identitymonk/Fathom-Drone-Archive/Packaging Instructions/Assets/postcard.png

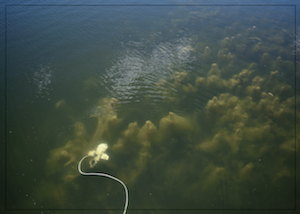
Packaging Instructions/Assets/postcard.png
