identitymonk/Fathom-Drone-Archive/Website/April 2018/Assets/UserManual.png

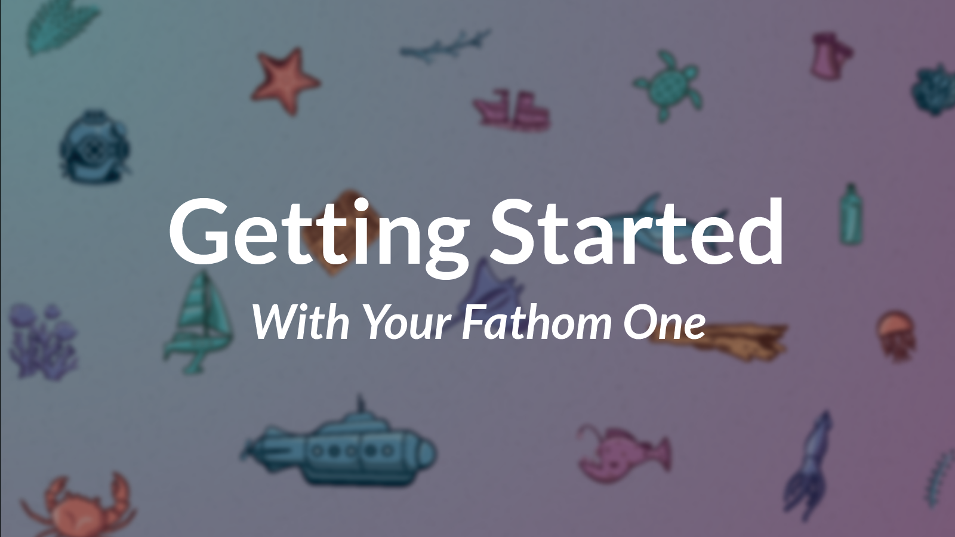
Website/April 2018/Assets/UserManual.png
