identitymonk/Fathom-Drone-Archive/README.md

# Fathom-Drone-Archive
Archive of the dead Fathom Drone Project (https://www.kickstarter.com/projects/1359605477/fathom-one-the-affordable-modular-hd-underwater-dr)
