identitymonk/Fathom-Drone-Archive/Charger/LiPo Charging Table.pdf

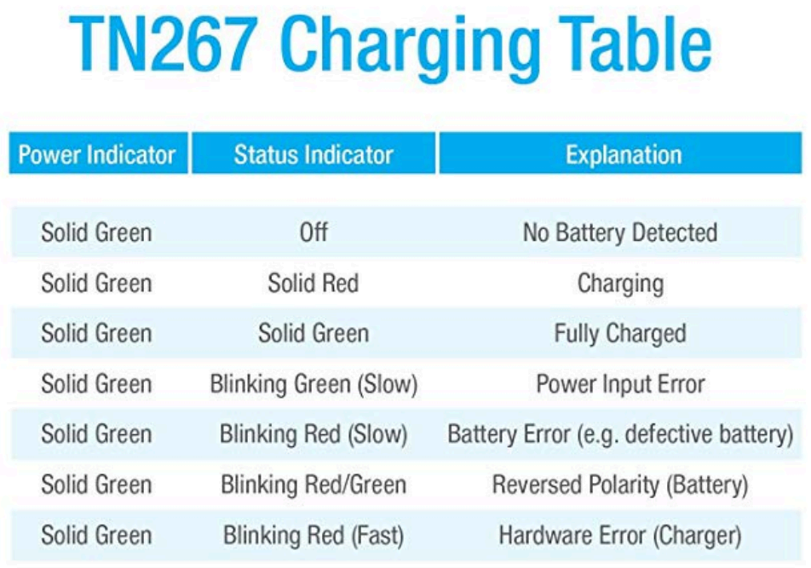
[picture p3: figure]
