identitymonk/Fathom-Drone-Archive/FaceMask/9013-0969.pdf

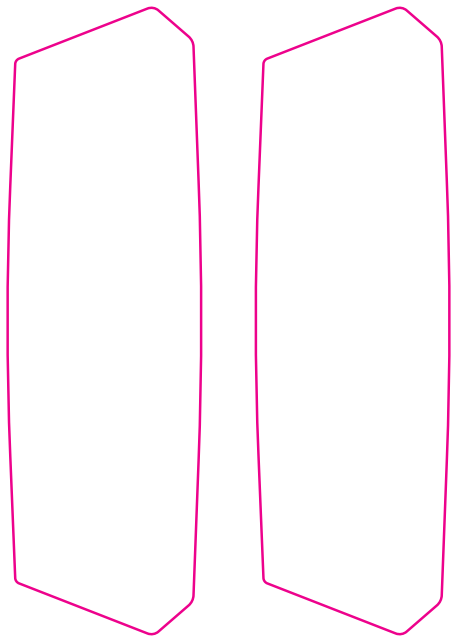
[picture p4: figure]
