identitymonk/Fathom-Drone-Archive/FaceMask/DOC072718-07272018104101.pdf

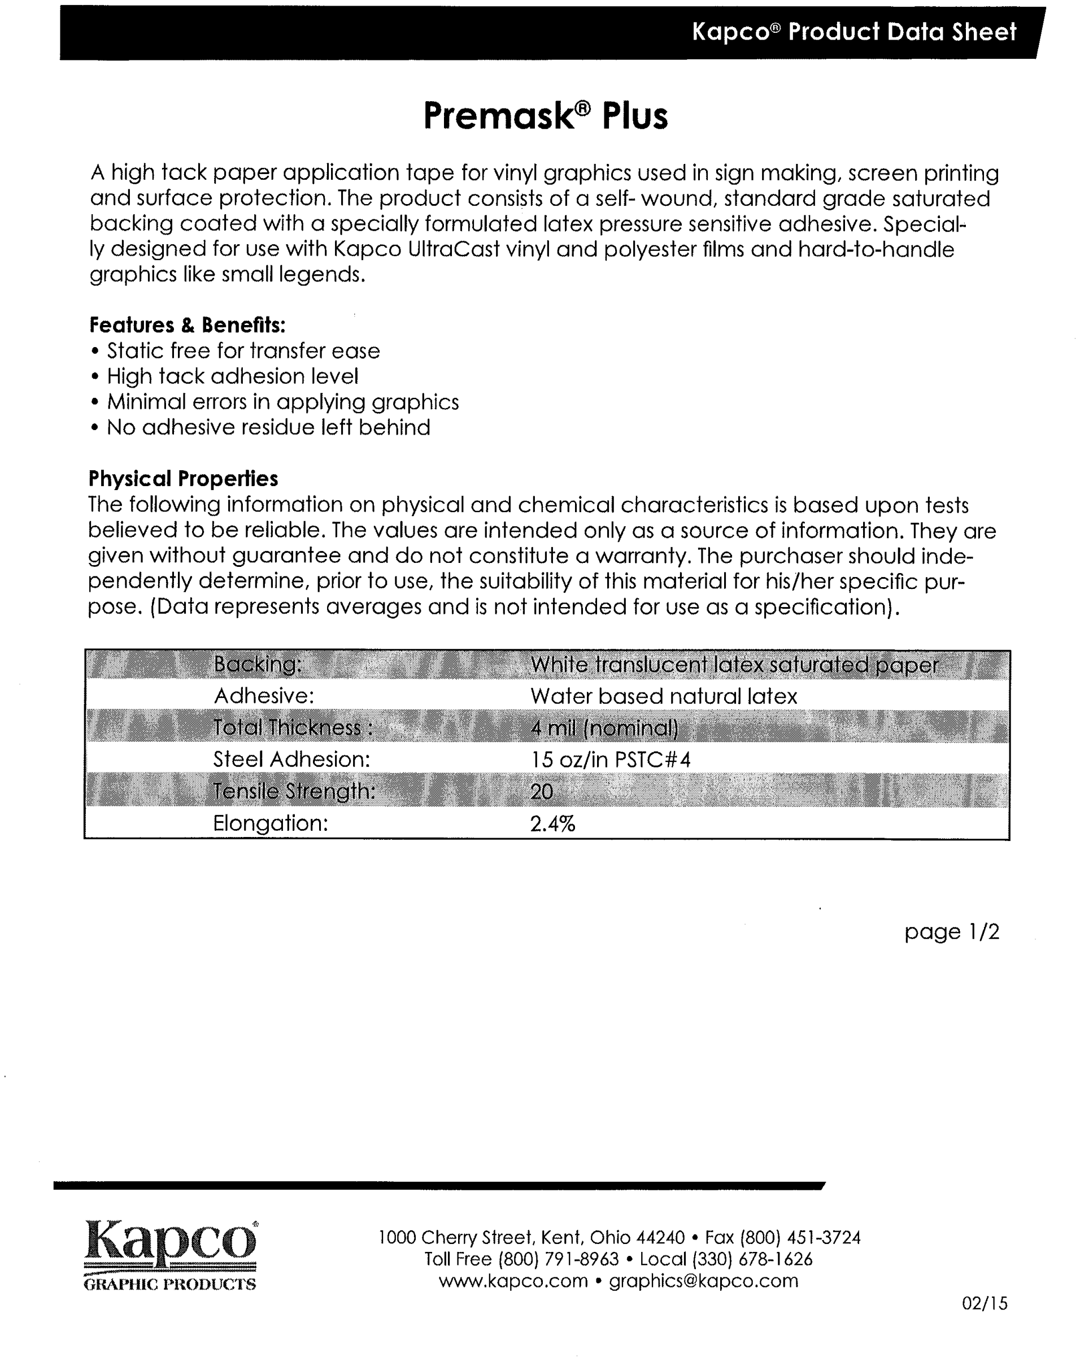
[picture p5: page 1]
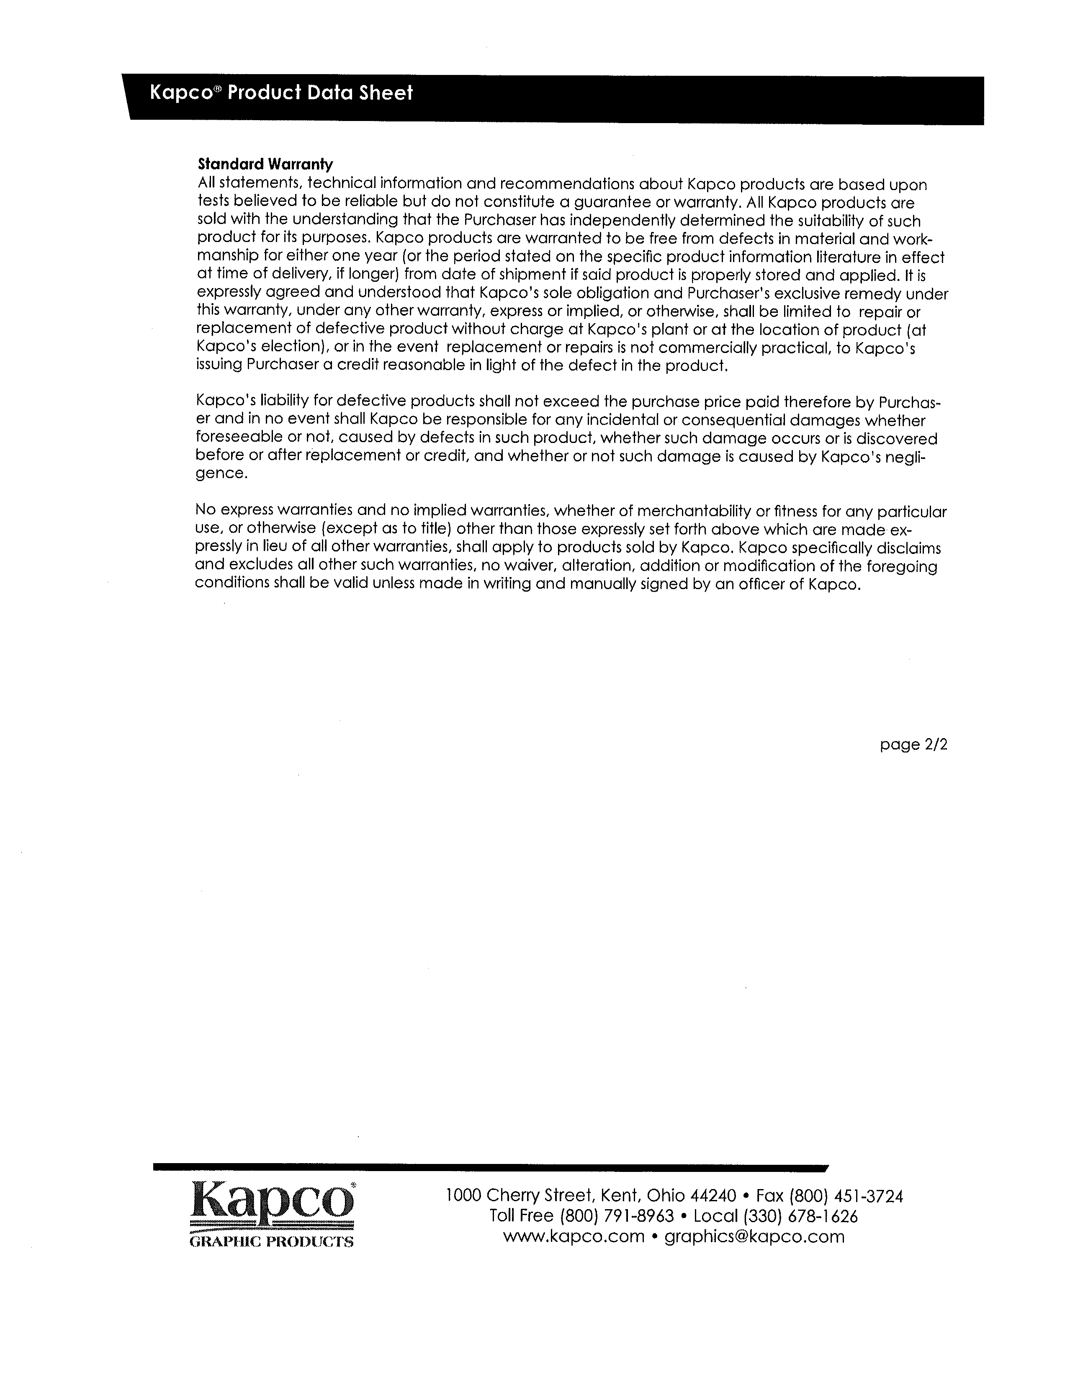
[picture p6: page 2]
