identitymonk/Fathom-Drone-Archive/FaceMask/Face drawing.pdf

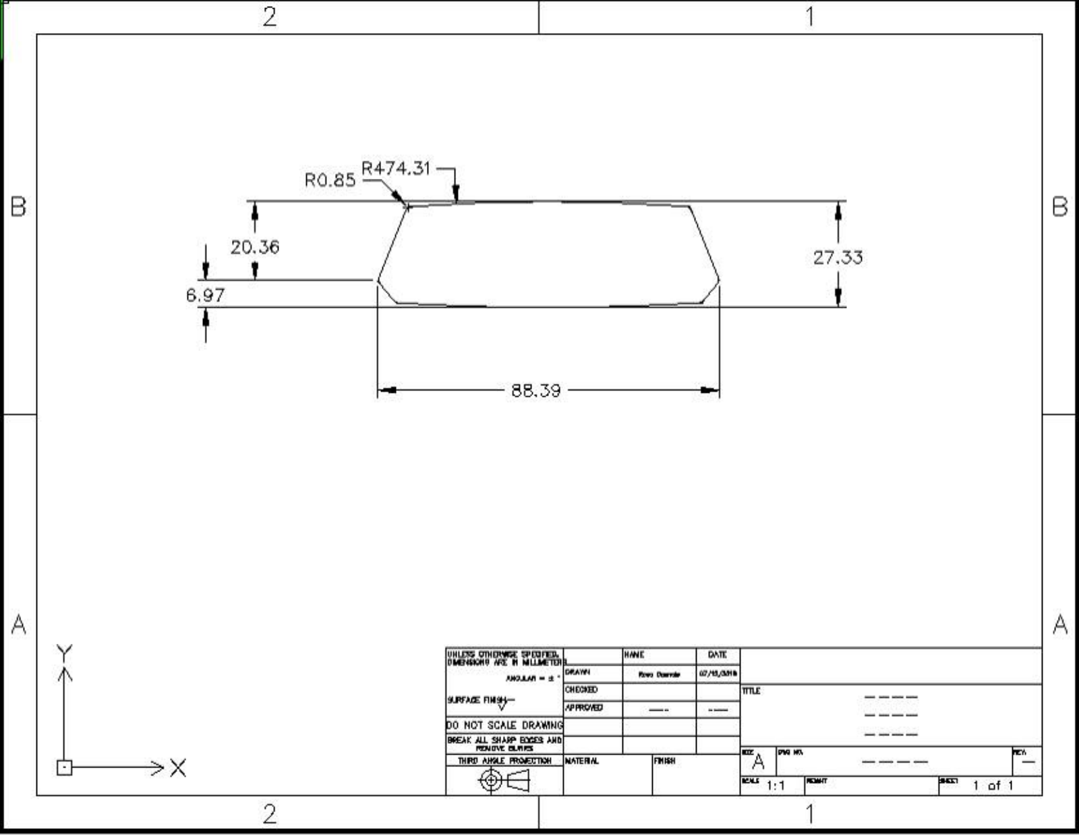
[picture p7: page 1]
