identitymonk/Fathom-Drone-Archive/App/App Screens/black-and-white-fun-happy-91227.jpg

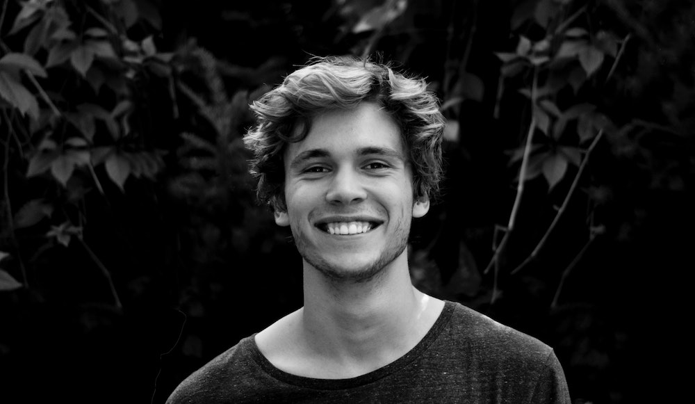
App/App Screens/black-and-white-fun-happy-91227.jpg
