identitymonk/Fathom-Drone-Archive/App/App Screens/IphoneXAccount.png

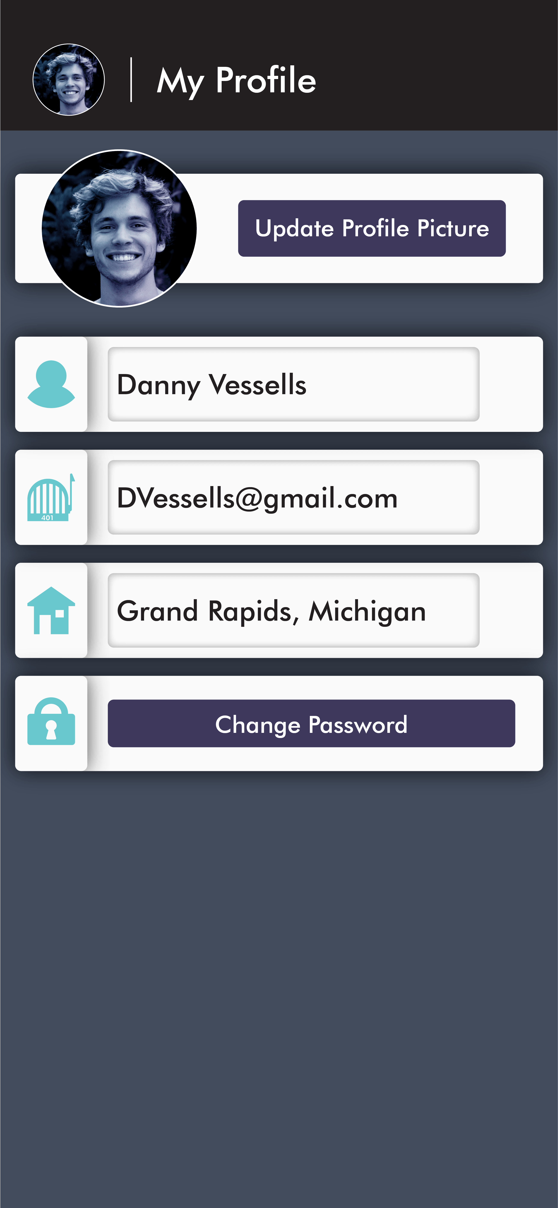
App/App Screens/IphoneXAccount.png
