identitymonk/Fathom-Drone-Archive/App/App Screens/X Home Connected.jpg

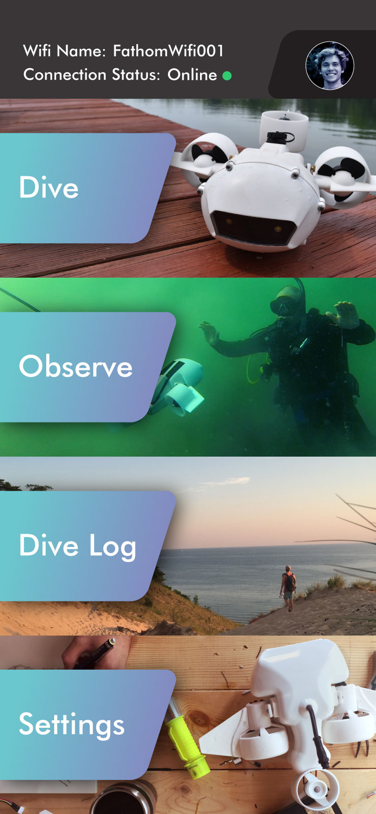
App/App Screens/X Home Connected.jpg
