identitymonk/Fathom-Drone-Archive/App/App Screens/X Profile.jpg

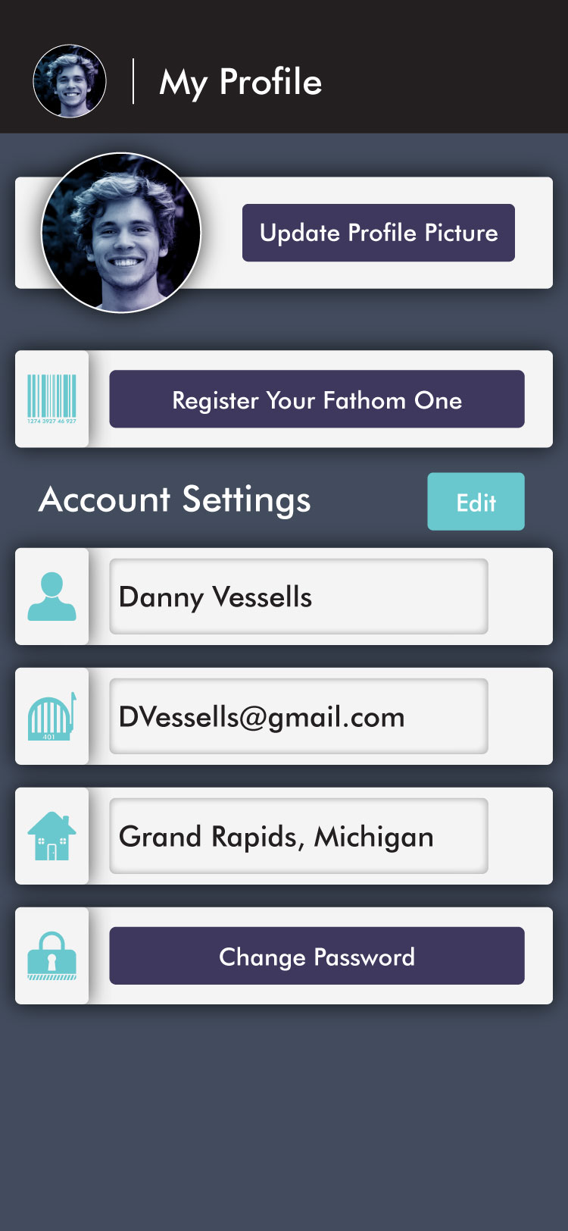
App/App Screens/X Profile.jpg
