identitymonk/Fathom-Drone-Archive/App/Drone Update/1 Loading.gif

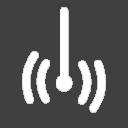
App/Drone Update/1 Loading.gif
