identitymonk/Fathom-Drone-Archive/App/iOS/October 2018 Update/iOSAssetsOCT16/DiveScreen/Joystick_Steer_Base@3x.png

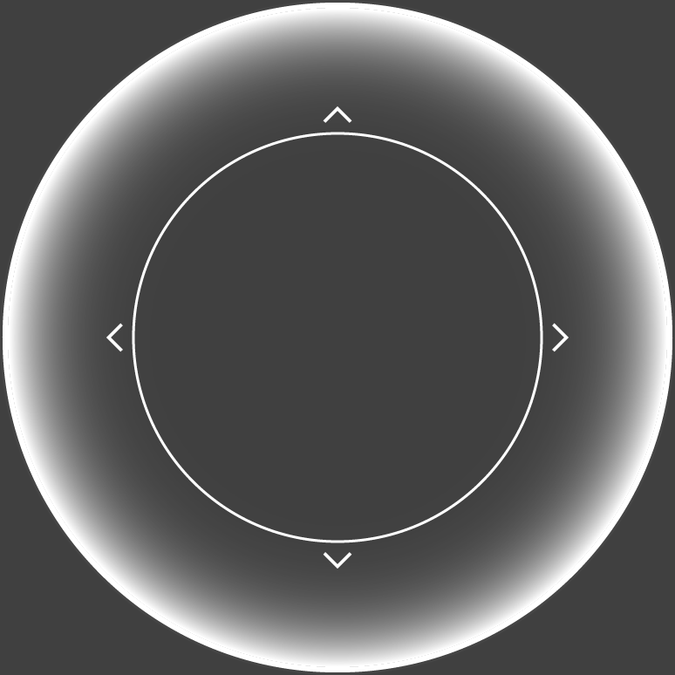
App/iOS/October 2018 Update/iOSAssetsOCT16/DiveScreen/Joystick_Steer_Base@3x.png
