identitymonk/Fathom-Drone-Archive/App/iOS/October 2018 Update/iOSAssetsOCT16/DiveScreen/JoyStick_Thrust_Base@3x.png

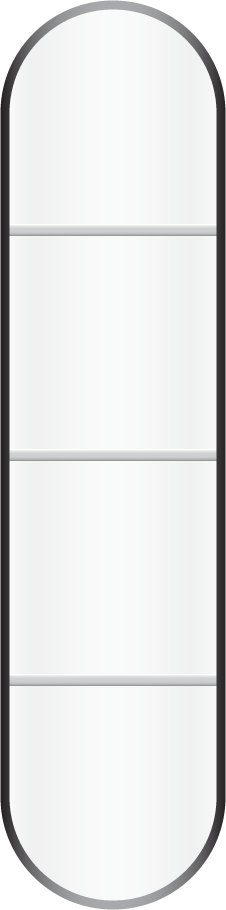
App/iOS/October 2018 Update/iOSAssetsOCT16/DiveScreen/JoyStick_Thrust_Base@3x.png
