identitymonk/Fathom-Drone-Archive/App/iOS/October 2018 Update/iOSAssetsOCT16/DiveScreen/ProMode.png

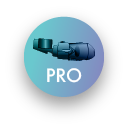
App/iOS/October 2018 Update/iOSAssetsOCT16/DiveScreen/ProMode.png
