identitymonk/Fathom-Drone-Archive/App/iOS/October 2018 Update/iOSAssetsOCT16/DiveScreen/Record_Off@2x.png

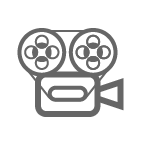
App/iOS/October 2018 Update/iOSAssetsOCT16/DiveScreen/Record_Off@2x.png
