identitymonk/Fathom-Drone-Archive/App/iOS/October 2018 Update/iOSAssetsOCT16/Examples/DiveScreen.png

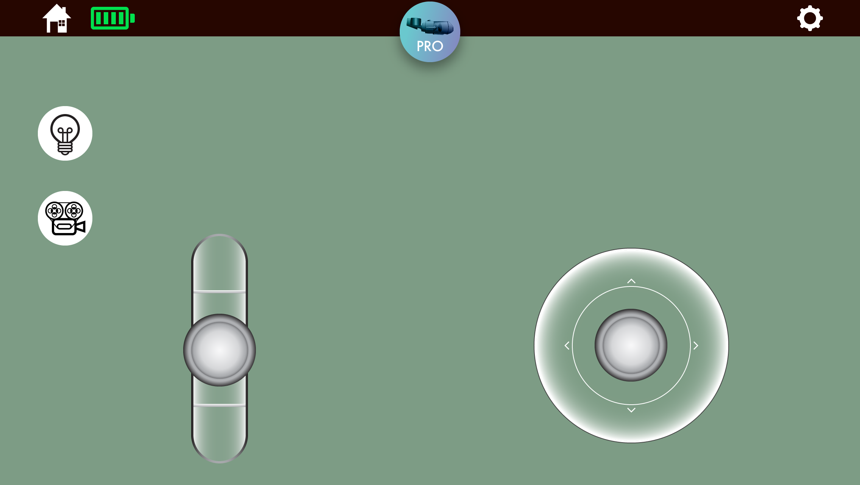
App/iOS/October 2018 Update/iOSAssetsOCT16/Examples/DiveScreen.png
