identitymonk/Fathom-Drone-Archive/App/iOS/October 2018 Update/iOSAssetsOCT16/MainMenu/Dive_Off.png

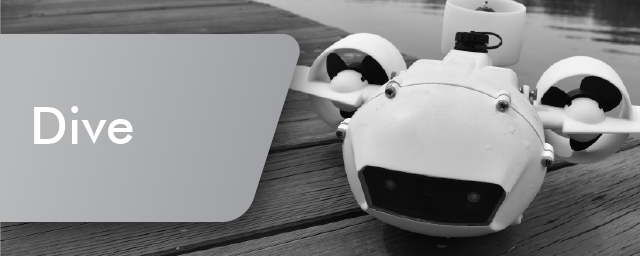
App/iOS/October 2018 Update/iOSAssetsOCT16/MainMenu/Dive_Off.png
