identitymonk/Fathom-Drone-Archive/App/iOS/October 2018 Update/iOSAssetsOCT16/MainMenu/Dive_On@2x.png

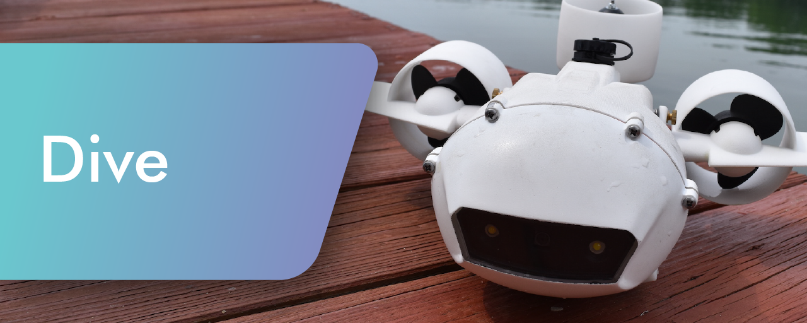
App/iOS/October 2018 Update/iOSAssetsOCT16/MainMenu/Dive_On@2x.png
