identitymonk/Fathom-Drone-Archive/App/iOS/October 2018 Update/iOSAssetsOCT16/MainMenu/DiveLog_Off.png

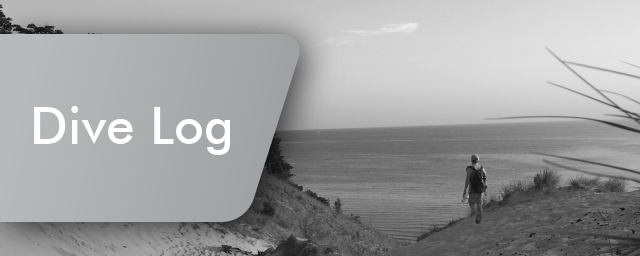
App/iOS/October 2018 Update/iOSAssetsOCT16/MainMenu/DiveLog_Off.png
