identitymonk/Fathom-Drone-Archive/App/iOS/October 2018 Update/iOSAssetsOCT16/MainMenu/Observe_Off.png

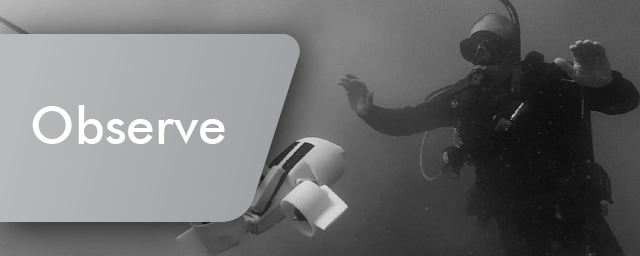
App/iOS/October 2018 Update/iOSAssetsOCT16/MainMenu/Observe_Off.png
