identitymonk/Fathom-Drone-Archive/App/Listing/DiveScreen.png

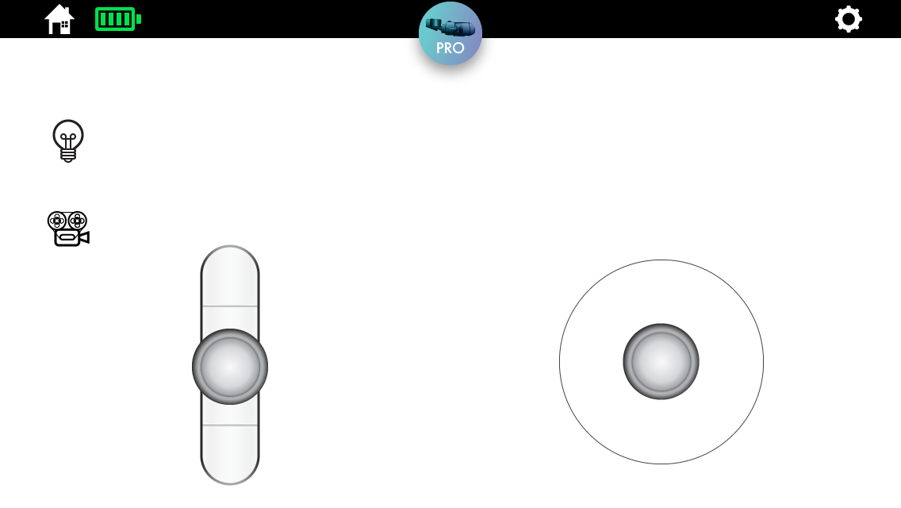
App/Listing/DiveScreen.png
