identitymonk/Fathom-Drone-Archive/App/Listing/Finals/MainMenu5_5.png

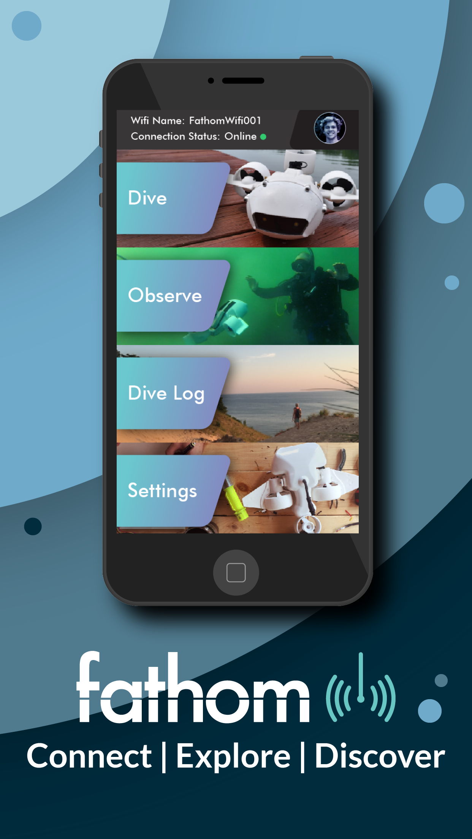
App/Listing/Finals/MainMenu5_5.png
