identitymonk/Fathom-Drone-Archive/App/Listing/Finals/MainMenu5_8.png

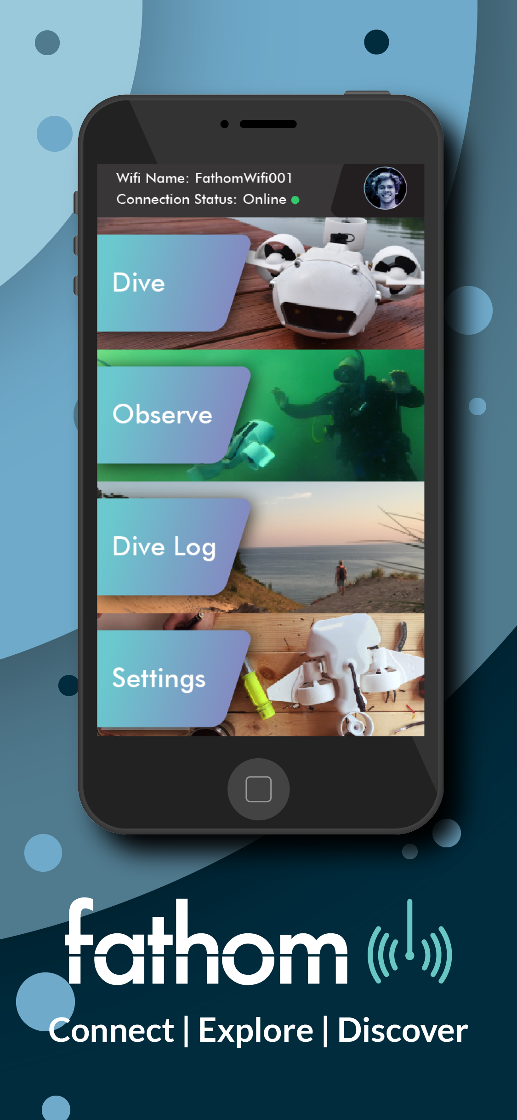
App/Listing/Finals/MainMenu5_8.png
