identitymonk/Fathom-Drone-Archive/App/Listing/Finals/MainMenu6_5.png

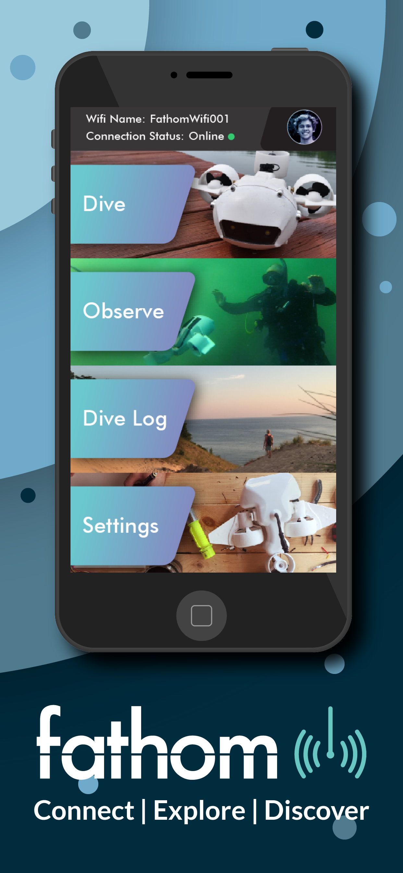
App/Listing/Finals/MainMenu6_5.png
