identitymonk/Fathom-Drone-Archive/App/Listing/Finals/MainMenu12_9.png

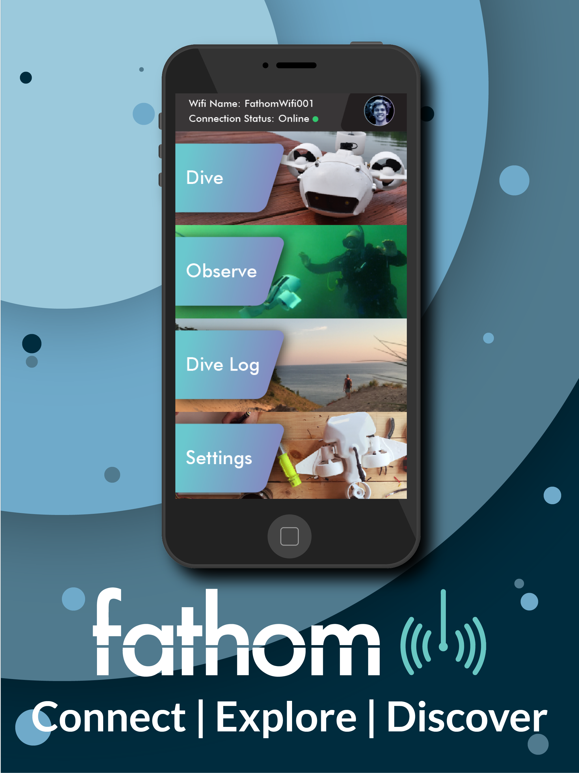
App/Listing/Finals/MainMenu12_9.png
