identitymonk/Fathom-Drone-Archive/CAD Files/Attachments/ElmoPayload/EPayload.JPG

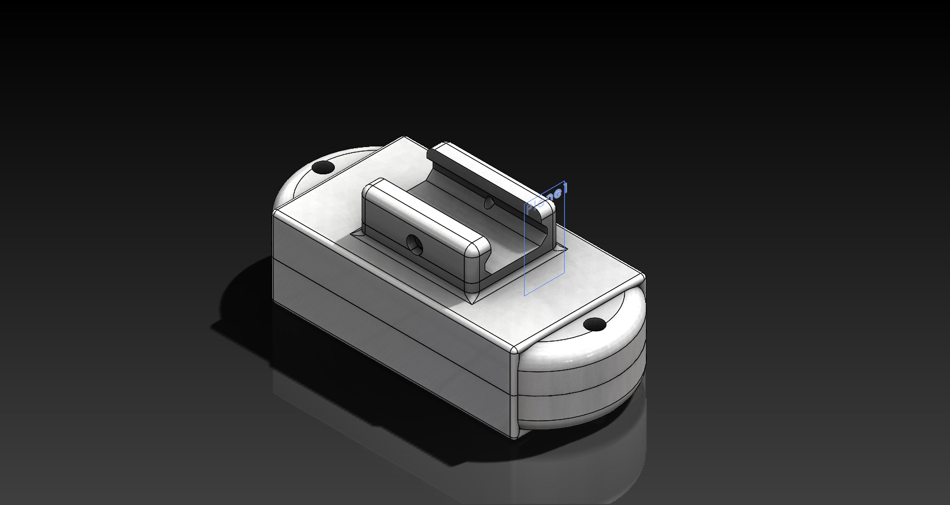
CAD Files/Attachments/ElmoPayload/EPayload.JPG
