identitymonk/Fathom-Drone-Archive/CAD Files/Attachments/LightModules2.JPG

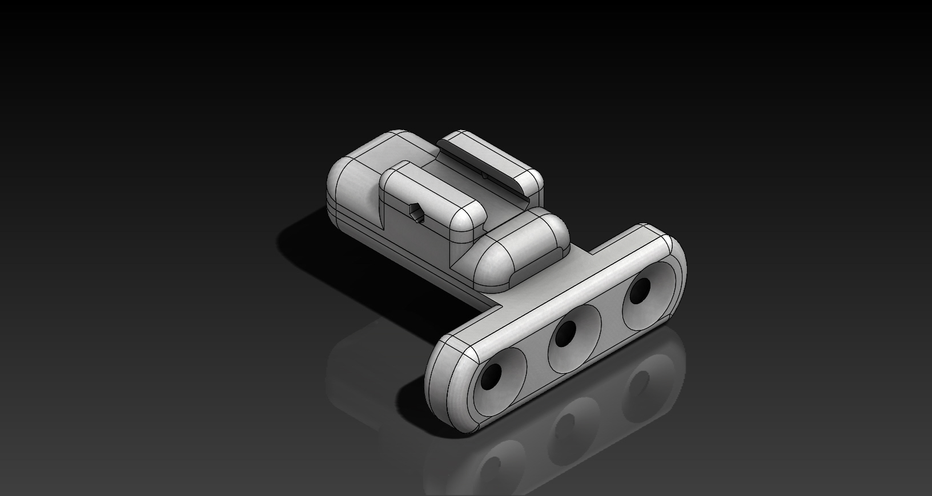
CAD Files/Attachments/LightModules2.JPG
