identitymonk/Fathom-Drone-Archive/CAD Files/Drone Related/Drone Documentation/Capture1.JPG

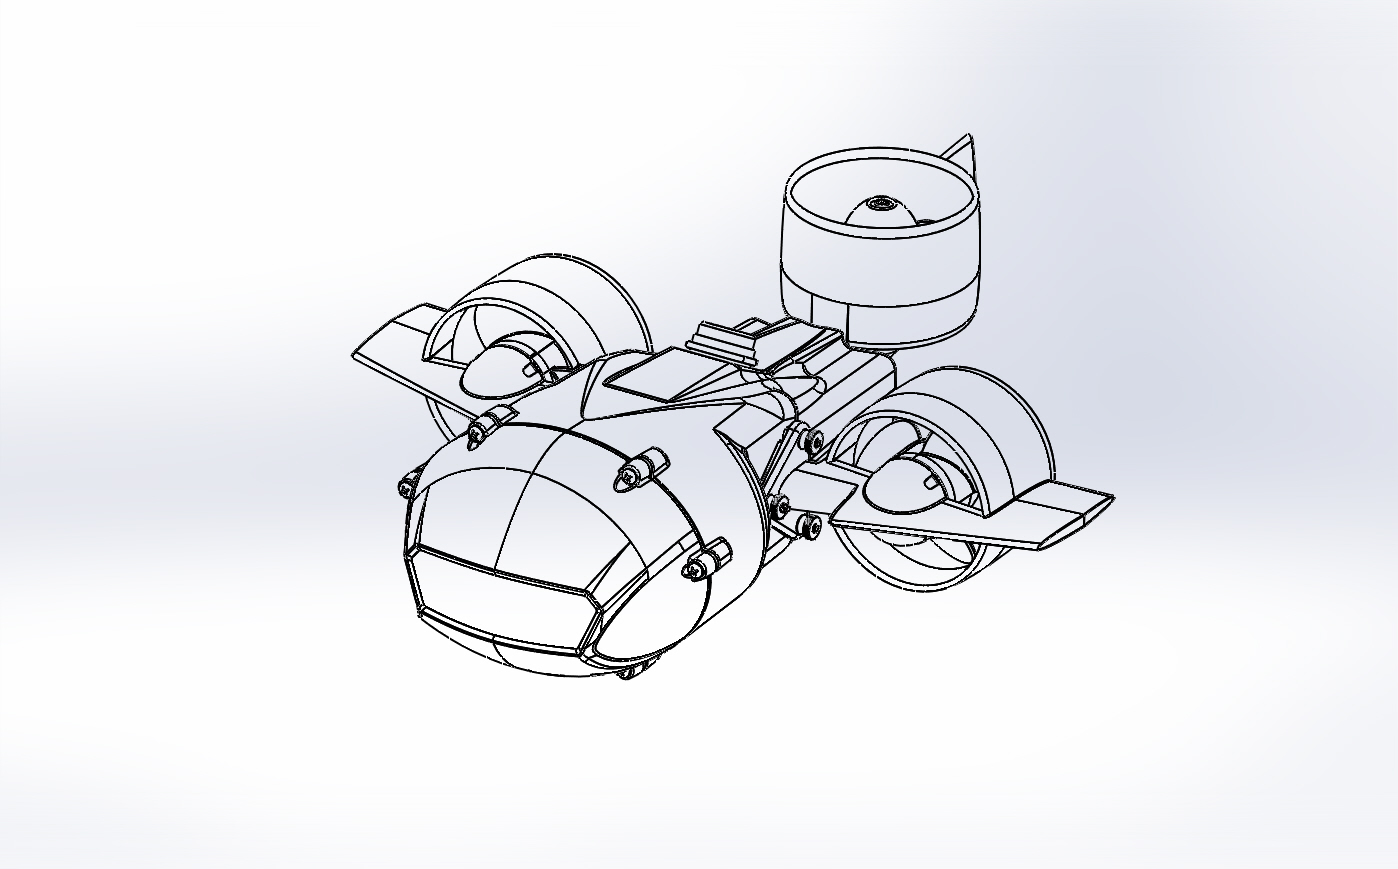
CAD Files/Drone Related/Drone Documentation/Capture1.JPG
