identitymonk/Fathom-Drone-Archive/CAD Files/Drone Related/Drone Documentation/Capture2.JPG

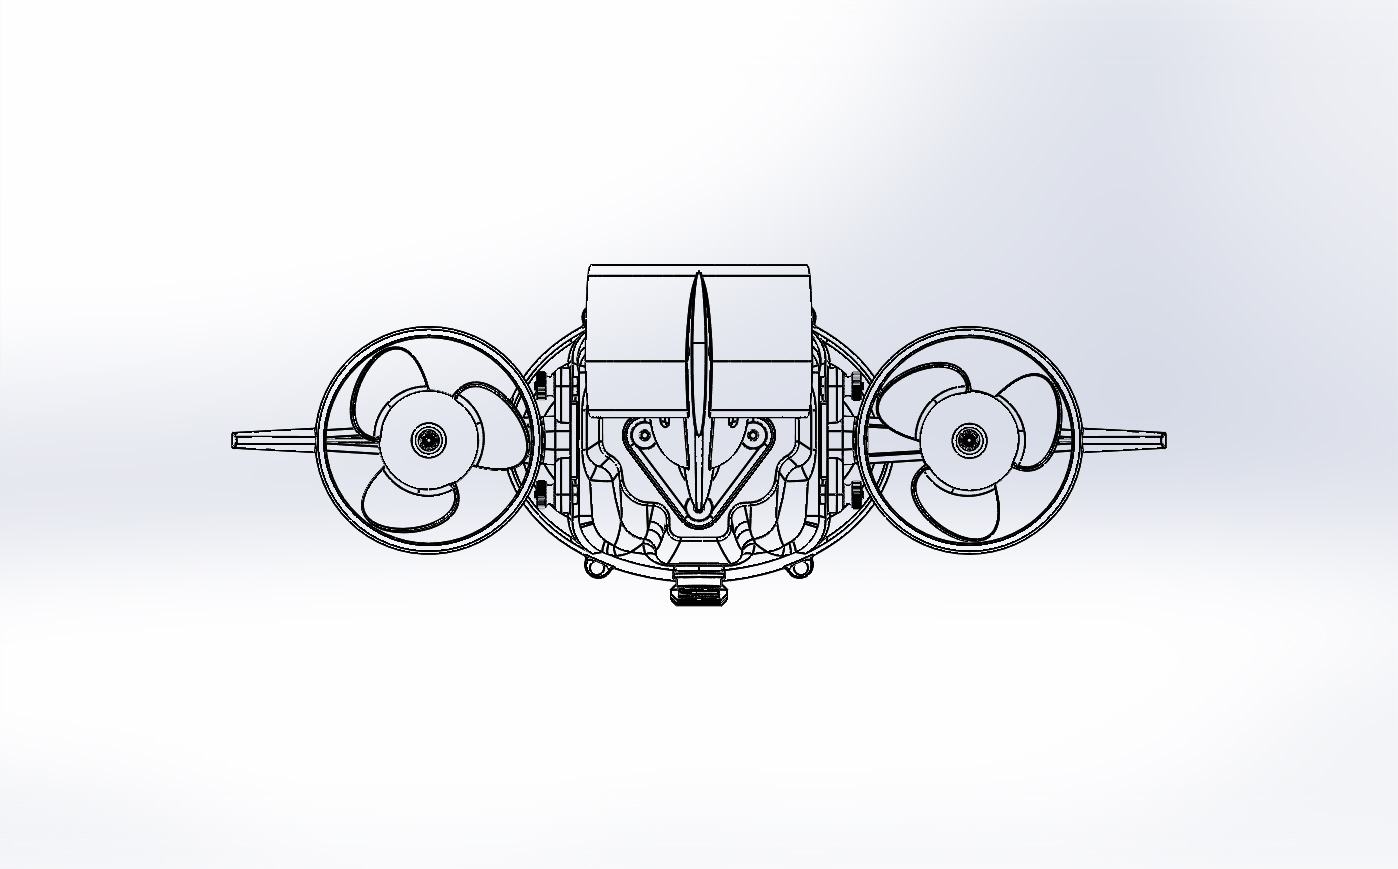
CAD Files/Drone Related/Drone Documentation/Capture2.JPG
