identitymonk/Fathom-Drone-Archive/CAD Files/Drone Related/Drone Documentation/Capture3.JPG

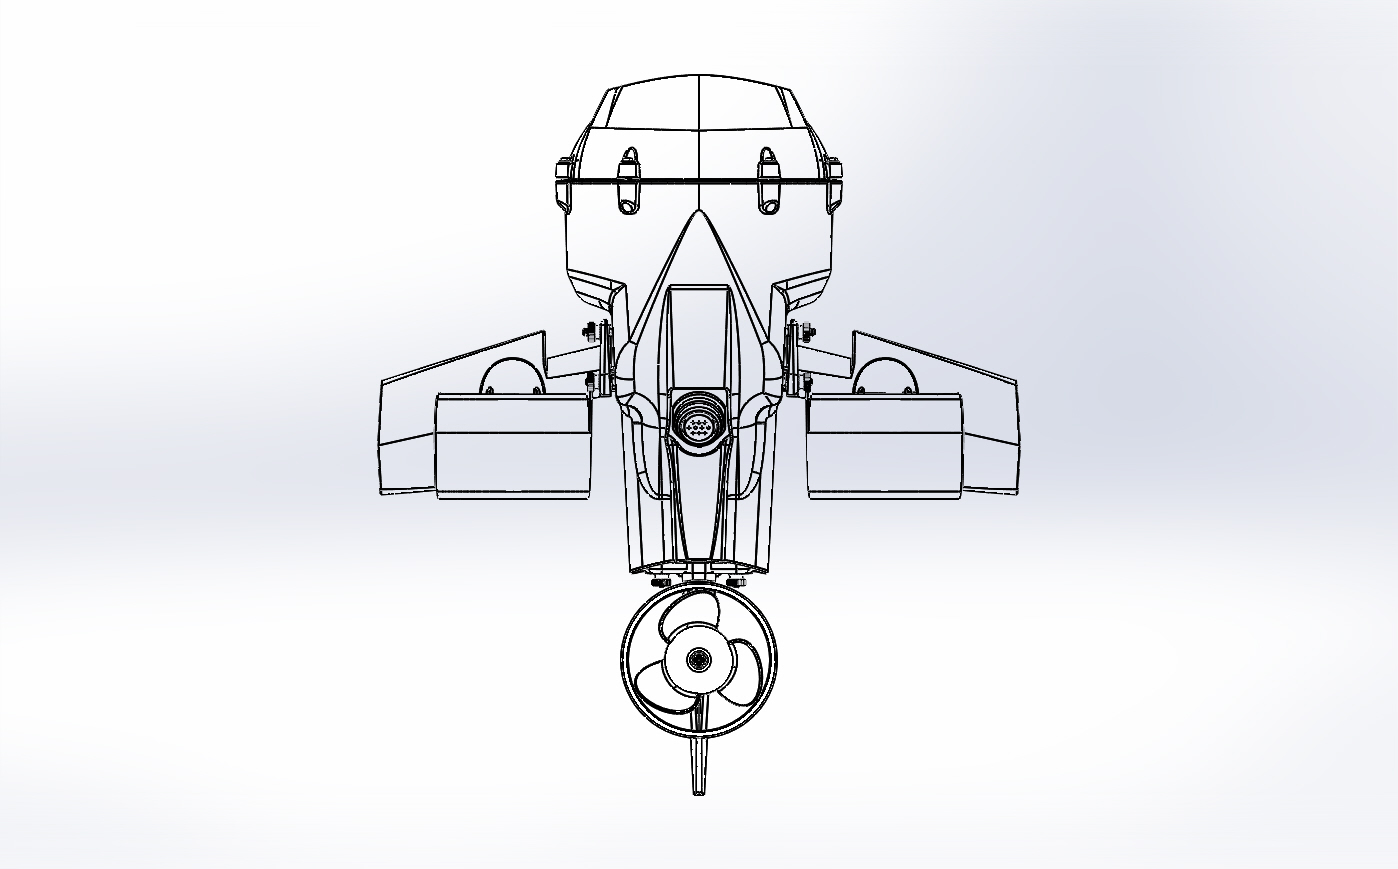
CAD Files/Drone Related/Drone Documentation/Capture3.JPG
