identitymonk/Fathom-Drone-Archive/CAD Files/Drone Related/Drone Documentation/Capture4.JPG

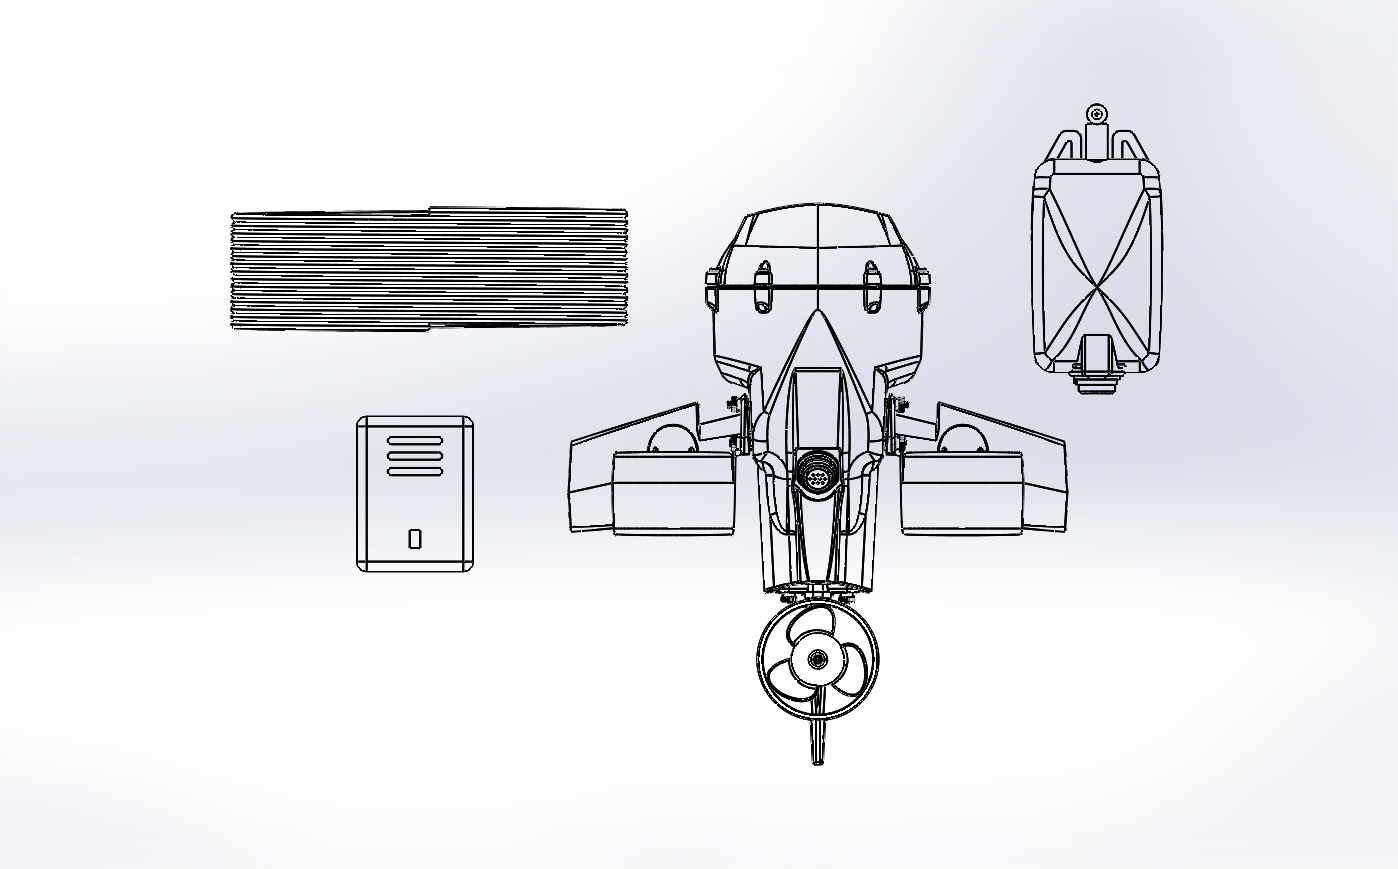
CAD Files/Drone Related/Drone Documentation/Capture4.JPG
