identitymonk/Fathom-Drone-Archive/Charger/Charger Status Code Table.jpg

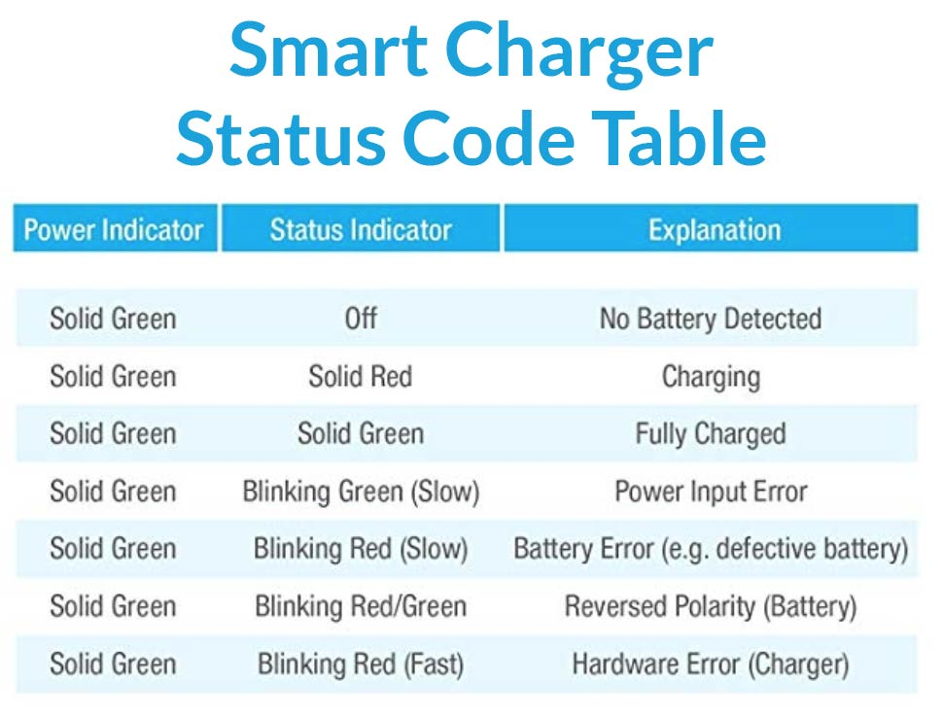
Charger/Charger Status Code Table.jpg
