identitymonk/Fathom-Drone-Archive/Drone Photos/2016 1 Alpha/Charlevoix/IMG_0231.jpg

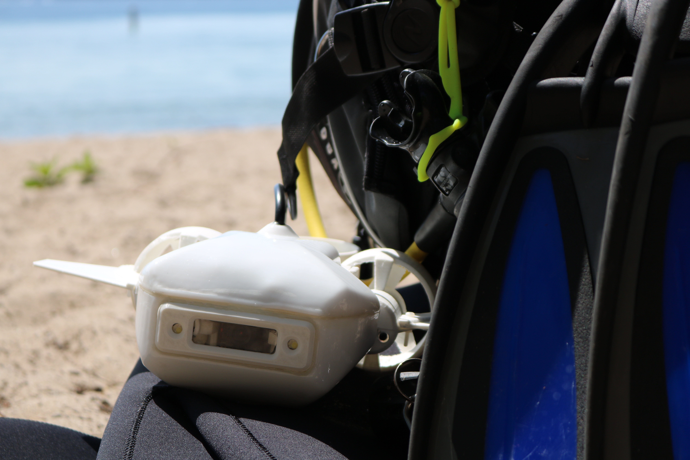
Drone Photos/2016 1 Alpha/Charlevoix/IMG_0231.jpg
