identitymonk/Fathom-Drone-Archive/Drone Photos/2016 1 Alpha/Charlevoix/IMG_0236.jpg

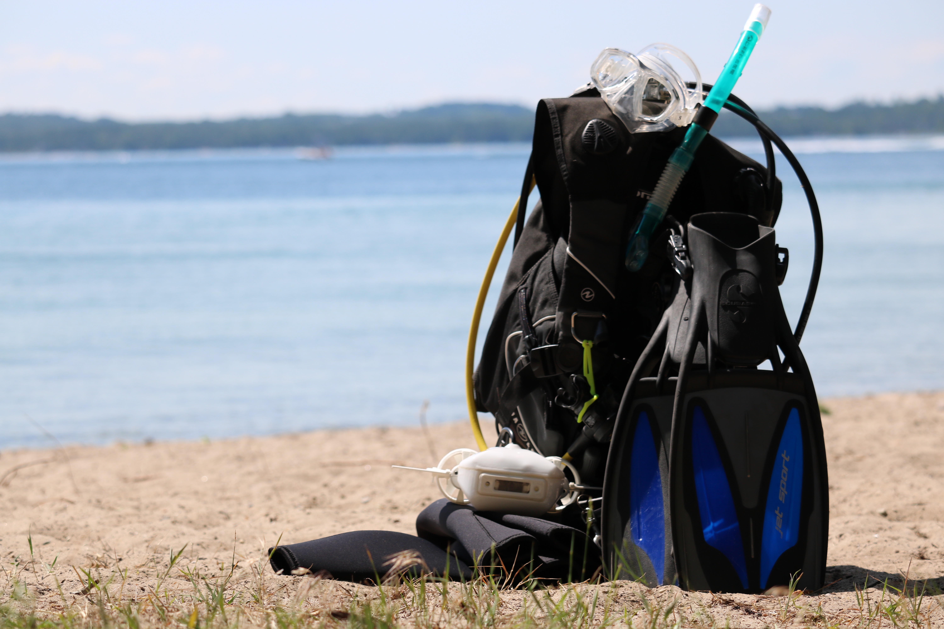
Drone Photos/2016 1 Alpha/Charlevoix/IMG_0236.jpg
