identitymonk/Fathom-Drone-Archive/Drone Photos/2016 1 Alpha/Charlevoix/IMG_0238.jpg

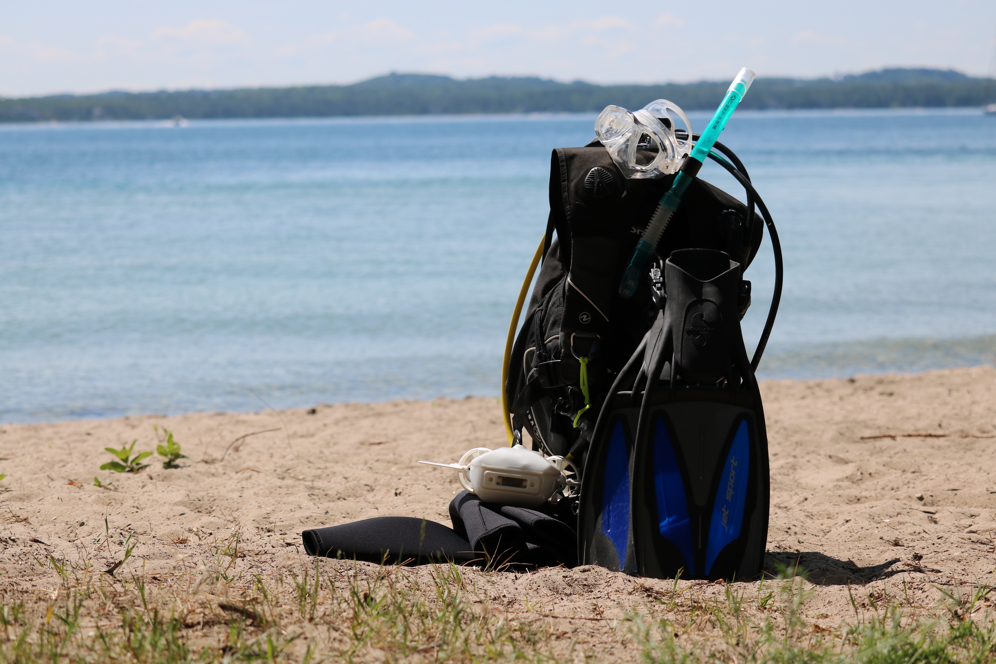
Drone Photos/2016 1 Alpha/Charlevoix/IMG_0238.jpg
