identitymonk/Fathom-Drone-Archive/Drone Photos/2016 1 Alpha/LL pics/IMG_0375.JPG

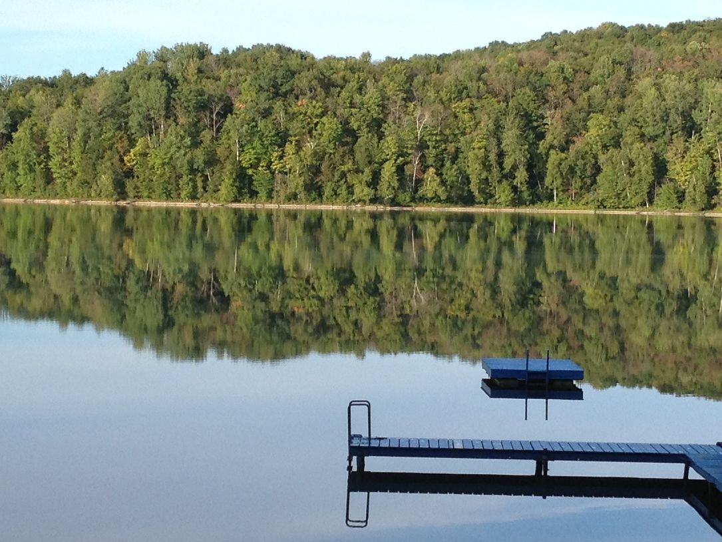
Drone Photos/2016 1 Alpha/LL pics/IMG_0375.JPG
