identitymonk/Fathom-Drone-Archive/Drone Photos/2016 1 Alpha/Press Kit/FathomBlackColor.png

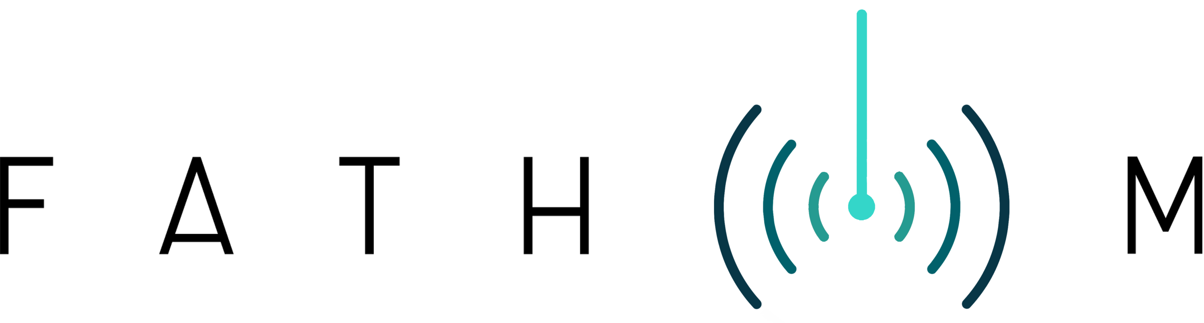
Drone Photos/2016 1 Alpha/Press Kit/FathomBlackColor.png
