identitymonk/Fathom-Drone-Archive/Drone Photos/2016 1 Alpha/Press Kit/FathomWhiteColor.png

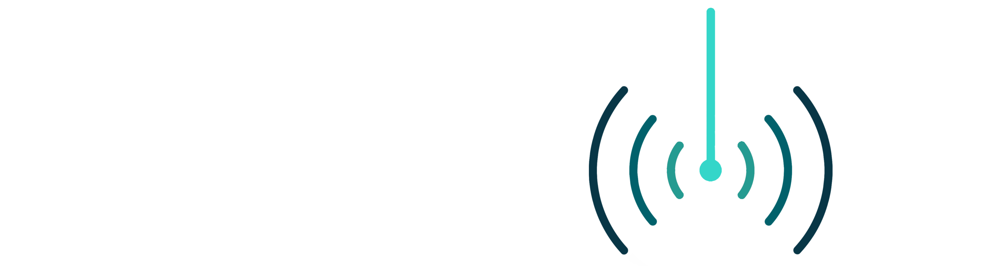
Drone Photos/2016 1 Alpha/Press Kit/FathomWhiteColor.png
