identitymonk/Fathom-Drone-Archive/Drone Photos/2016 1 Alpha/Underwater Shots/Fathom Floating Close.png

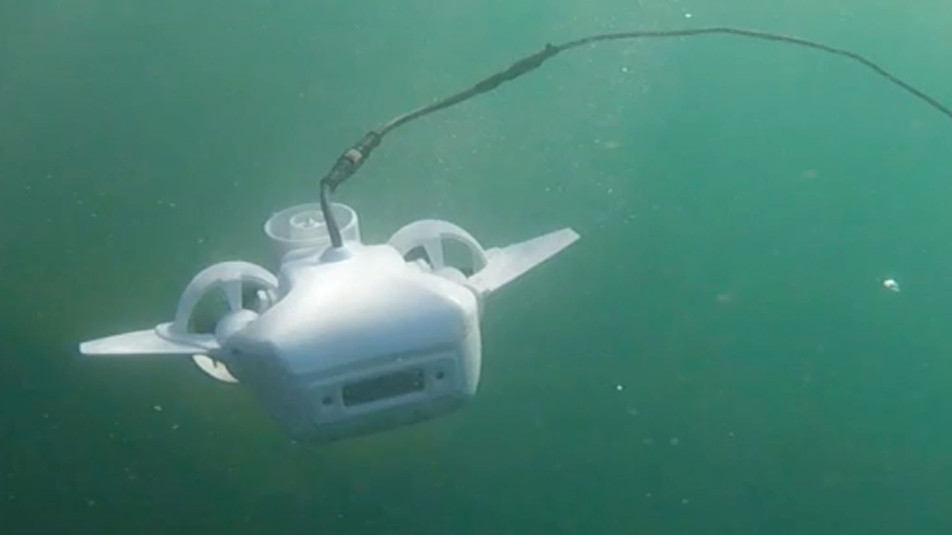
Drone Photos/2016 1 Alpha/Underwater Shots/Fathom Floating Close.png
