identitymonk/Fathom-Drone-Archive/Drone Photos/2016 1 Alpha/Underwater Shots/GoPro Rear.png

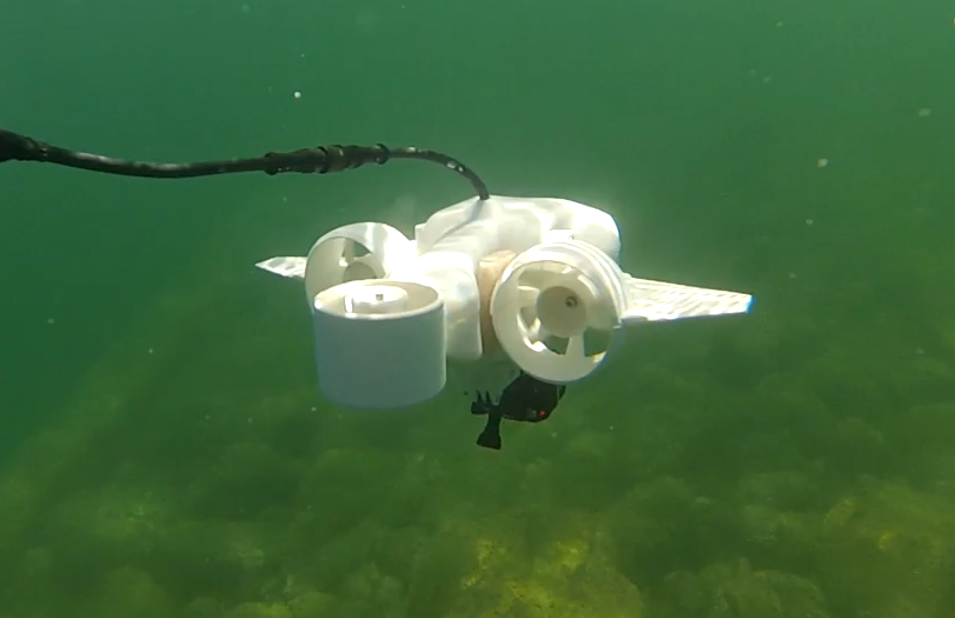
Drone Photos/2016 1 Alpha/Underwater Shots/GoPro Rear.png
