identitymonk/Fathom-Drone-Archive/Drone Photos/2017 2 Feb/Backpack.jpeg

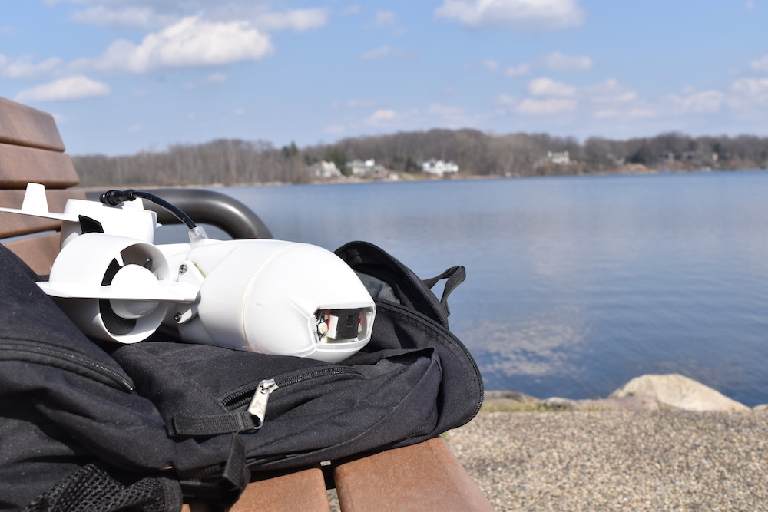
Drone Photos/2017 2 Feb/Backpack.jpeg
