identitymonk/Fathom-Drone-Archive/Drone Photos/2017 2 Feb/DroneShoot.png

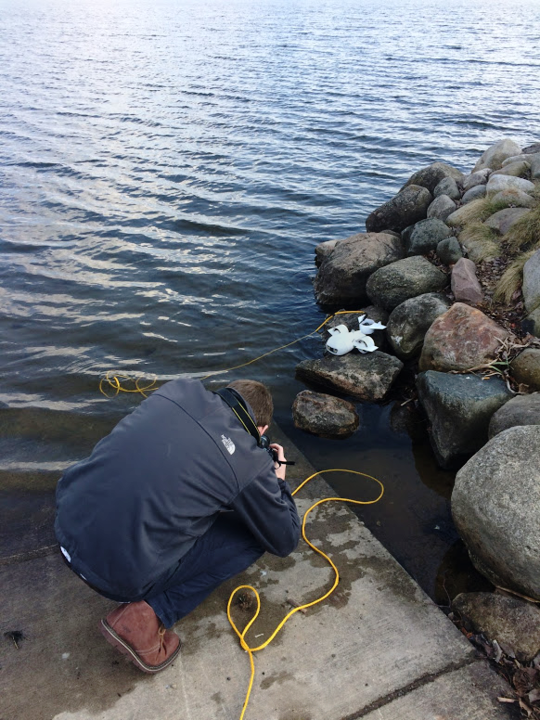
Drone Photos/2017 2 Feb/DroneShoot.png
