identitymonk/Fathom-Drone-Archive/Potting Cover/PottingCover.png

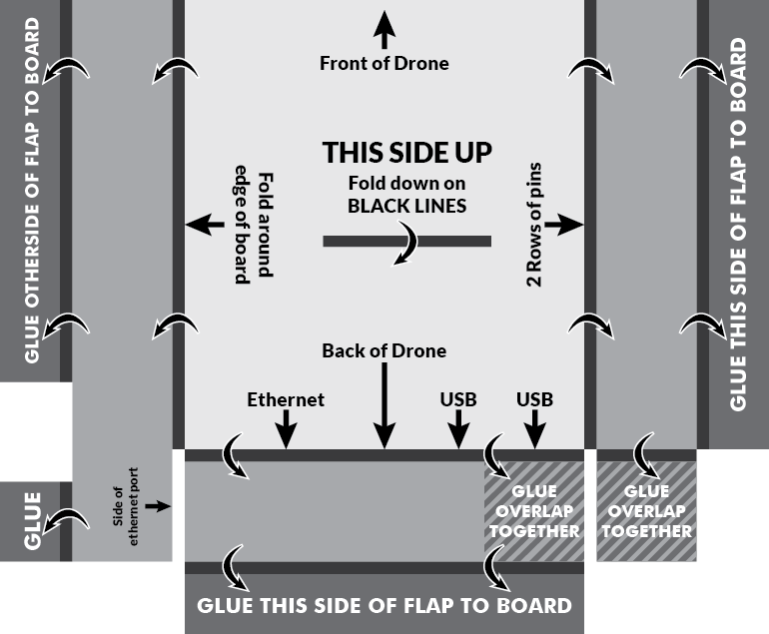
Potting Cover/PottingCover.png
