identitymonk/Fathom-Drone-Archive/Renders/F1 Model/Ortho30.png

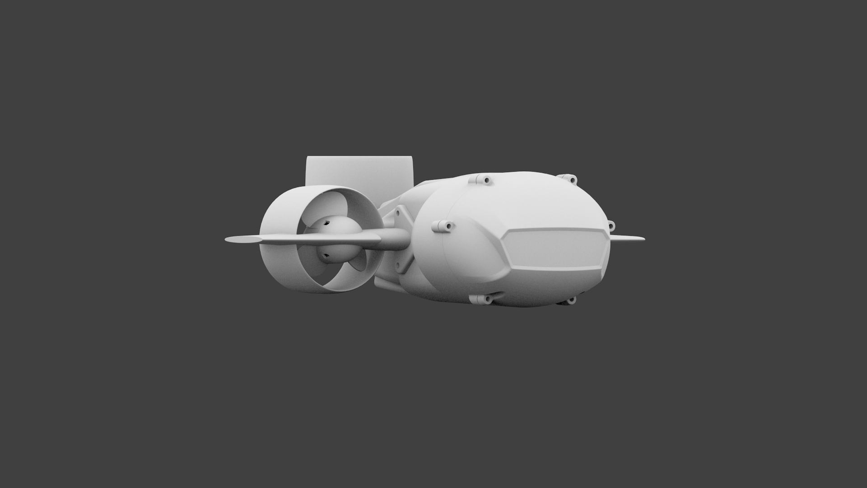
Renders/F1 Model/Ortho30.png
