identitymonk/Fathom-Drone-Archive/Renders/F1 Model/OrthoSide.png

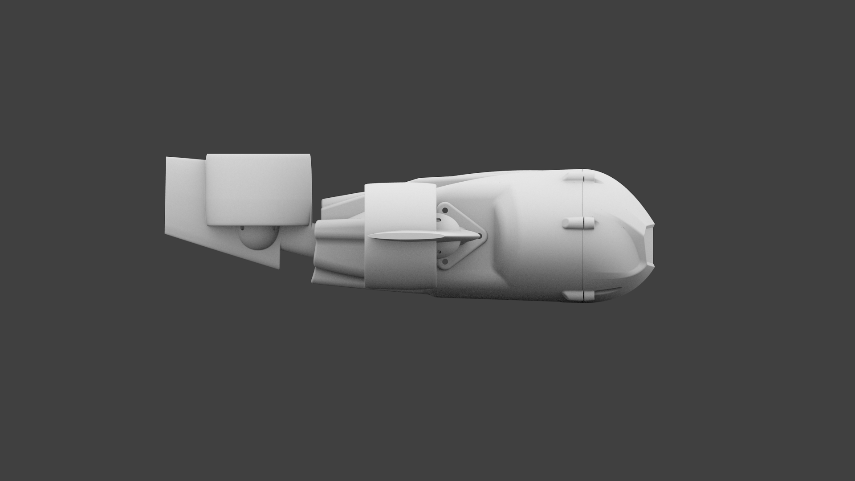
Renders/F1 Model/OrthoSide.png
