identitymonk/Fathom-Drone-Archive/Website/April 2018/Assets/App Breakout.png

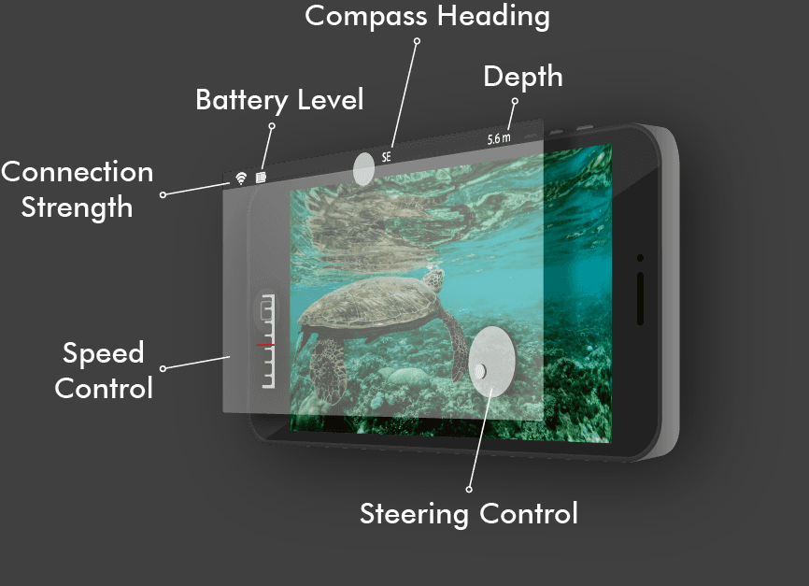
Website/April 2018/Assets/App Breakout.png
