identitymonk/Fathom-Drone-Archive/Website/April 2018/Assets/button-appstore.png

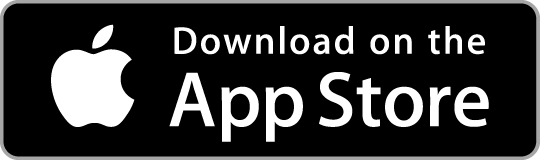
Website/April 2018/Assets/button-appstore.png
