identitymonk/Fathom-Drone-Archive/Website/April 2018/Assets/button_download_android.png

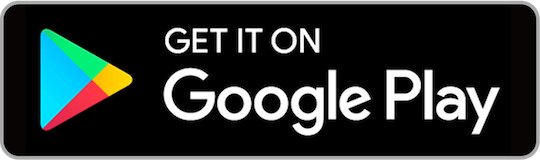
Website/April 2018/Assets/button_download_android.png
