identitymonk/Fathom-Drone-Archive/Website/April 2018/Assets/Dark Transparent Gradient.png

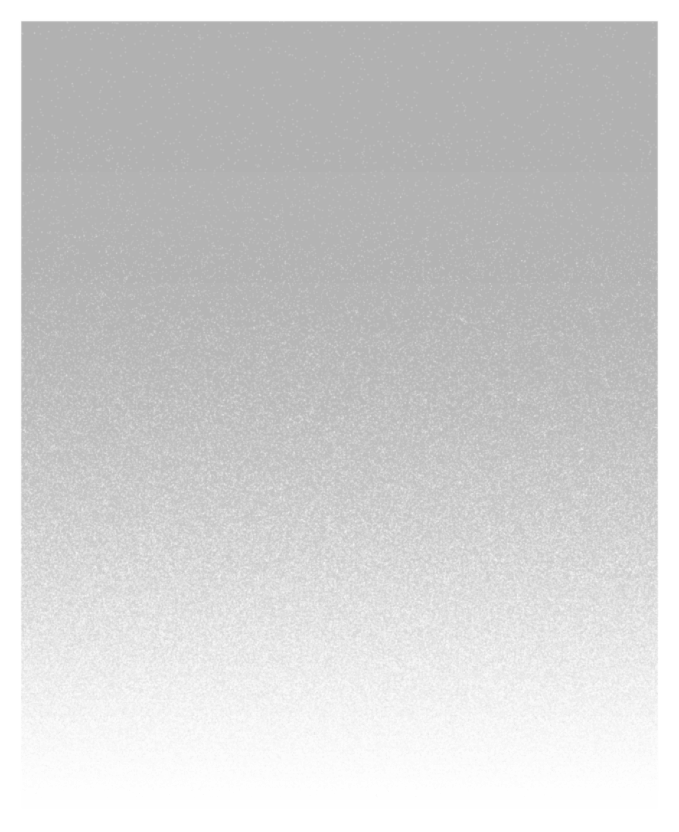
Website/April 2018/Assets/Dark Transparent Gradient.png
