identitymonk/Fathom-Drone-Archive/Website/April 2018/Assets/EmailConfirmationHeader.png

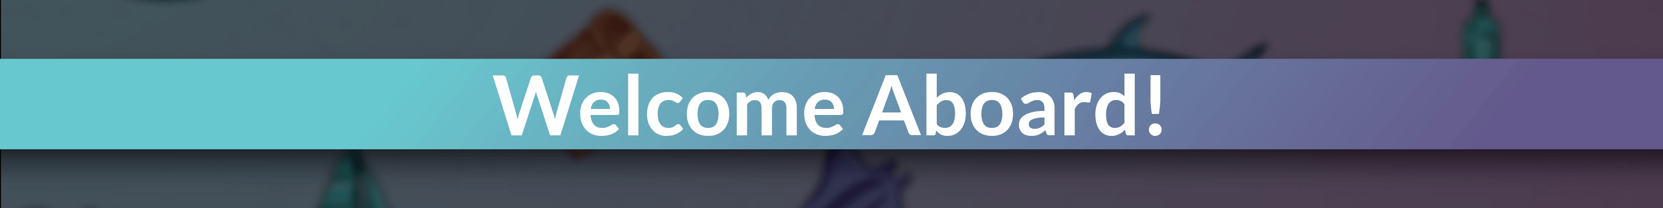
Website/April 2018/Assets/EmailConfirmationHeader.png
