identitymonk/Fathom-Drone-Archive/Website/April 2018/Assets/FathomOneDockEdit.jpg

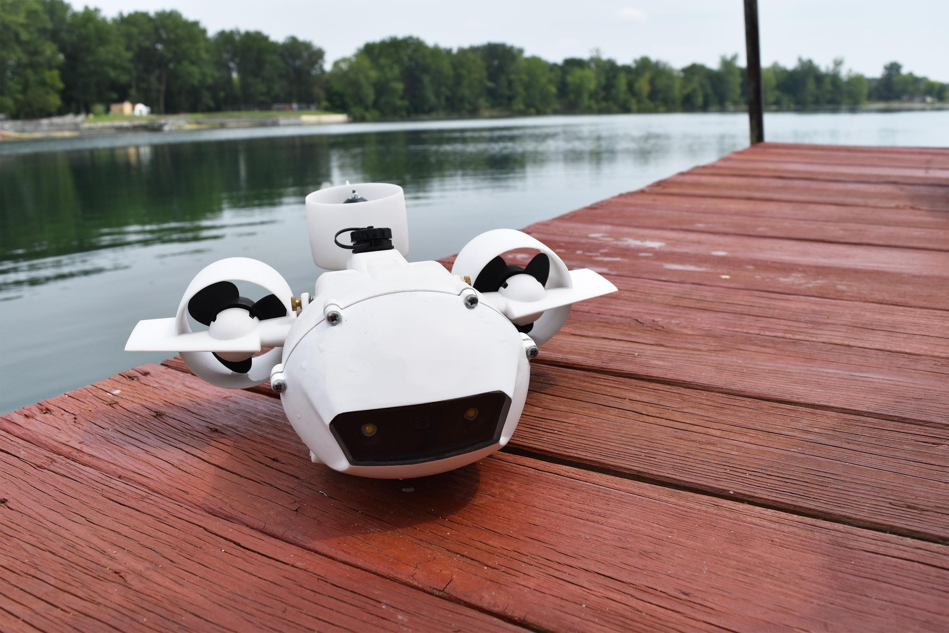
Website/April 2018/Assets/FathomOneDockEdit.jpg
