identitymonk/Fathom-Drone-Archive/Website/April 2018/Assets/FooterAdd.jpg

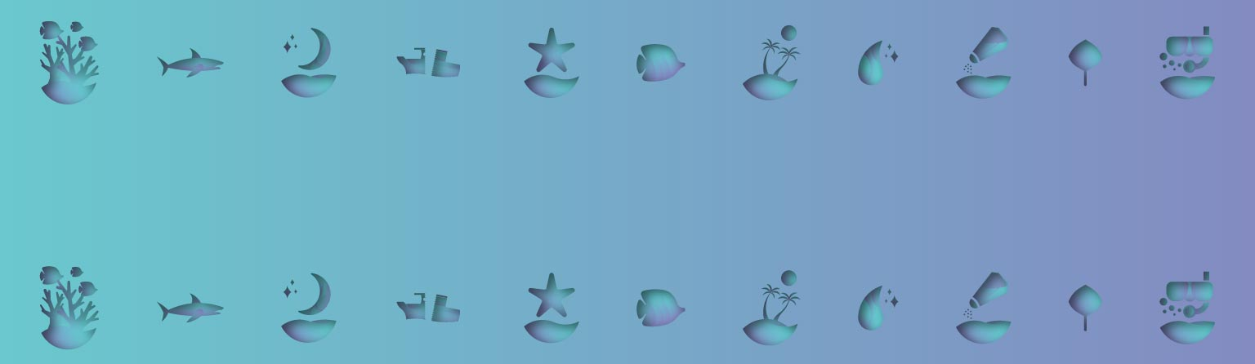
Website/April 2018/Assets/FooterAdd.jpg
