identitymonk/Fathom-Drone-Archive/Website/April 2018/Assets/Gradient Bottom2.png

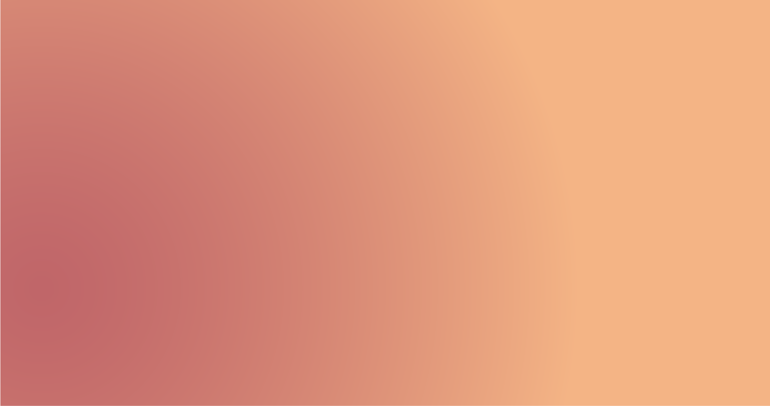
Website/April 2018/Assets/Gradient Bottom2.png
