identitymonk/Fathom-Drone-Archive/Website/April 2018/Assets/Gradient Bottom.png

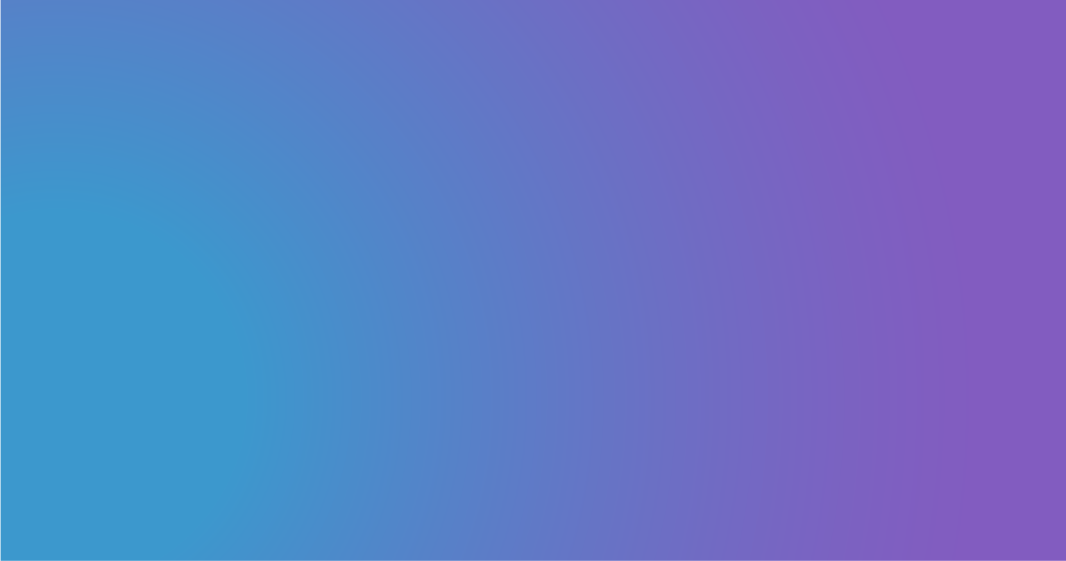
Website/April 2018/Assets/Gradient Bottom.png
