identitymonk/Fathom-Drone-Archive/Website/April 2018/Assets/HeaderBackground.png

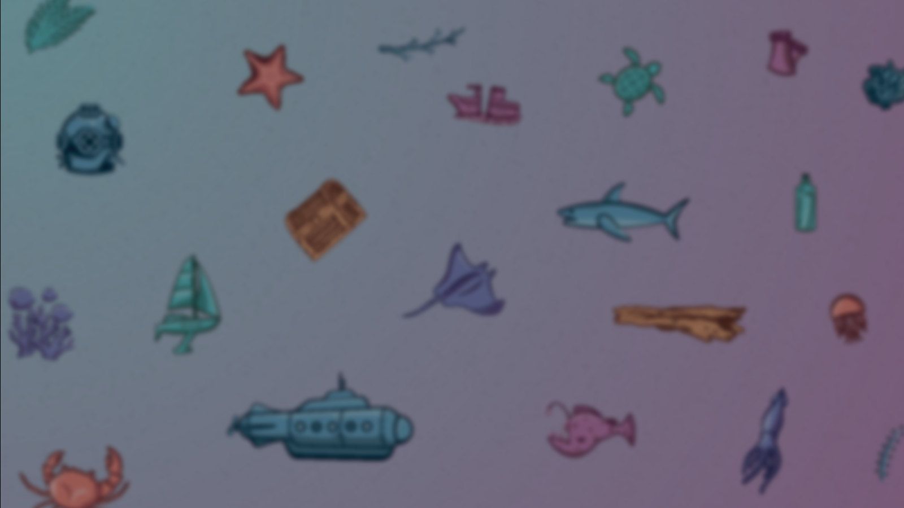
Website/April 2018/Assets/HeaderBackground.png
