identitymonk/Fathom-Drone-Archive/Website/April 2018/Assets/HeroTop.jpg

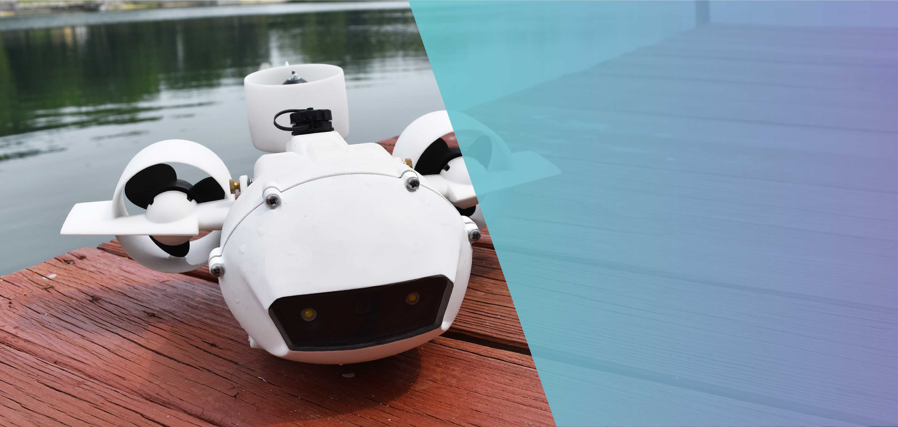
Website/April 2018/Assets/HeroTop.jpg
