identitymonk/Fathom-Drone-Archive/Website/April 2018/Assets/MilleniumParkFathom1-min.jpg

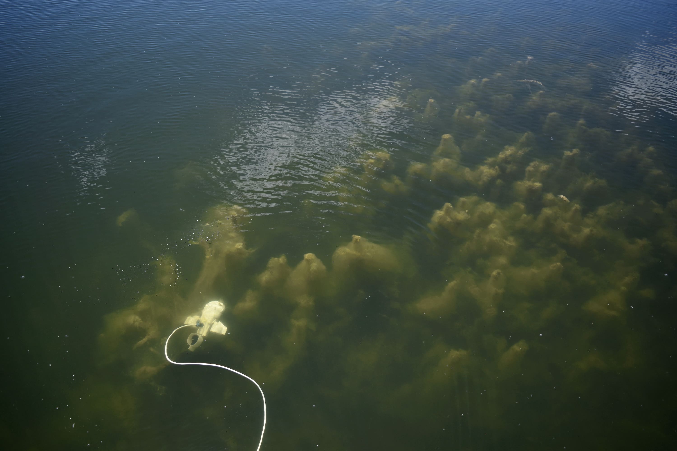
Website/April 2018/Assets/MilleniumParkFathom1-min.jpg
