identitymonk/Fathom-Drone-Archive/Website/April 2018/Assets/Phone Home.png

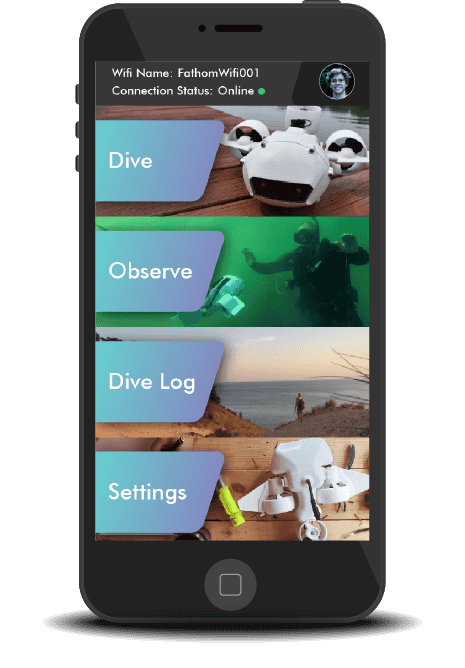
Website/April 2018/Assets/Phone Home.png
