identitymonk/Fathom-Drone-Archive/Website/April 2018/Final_Mobile/DownloadVideos_Mobile.jpg

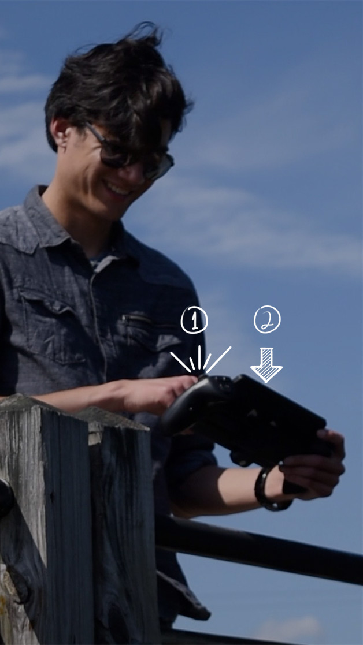
Website/April 2018/Final_Mobile/DownloadVideos_Mobile.jpg
