identitymonk/Fathom-Drone-Archive/Website/April 2018/Final_Mobile/FathomOneDock_Mobile.jpg

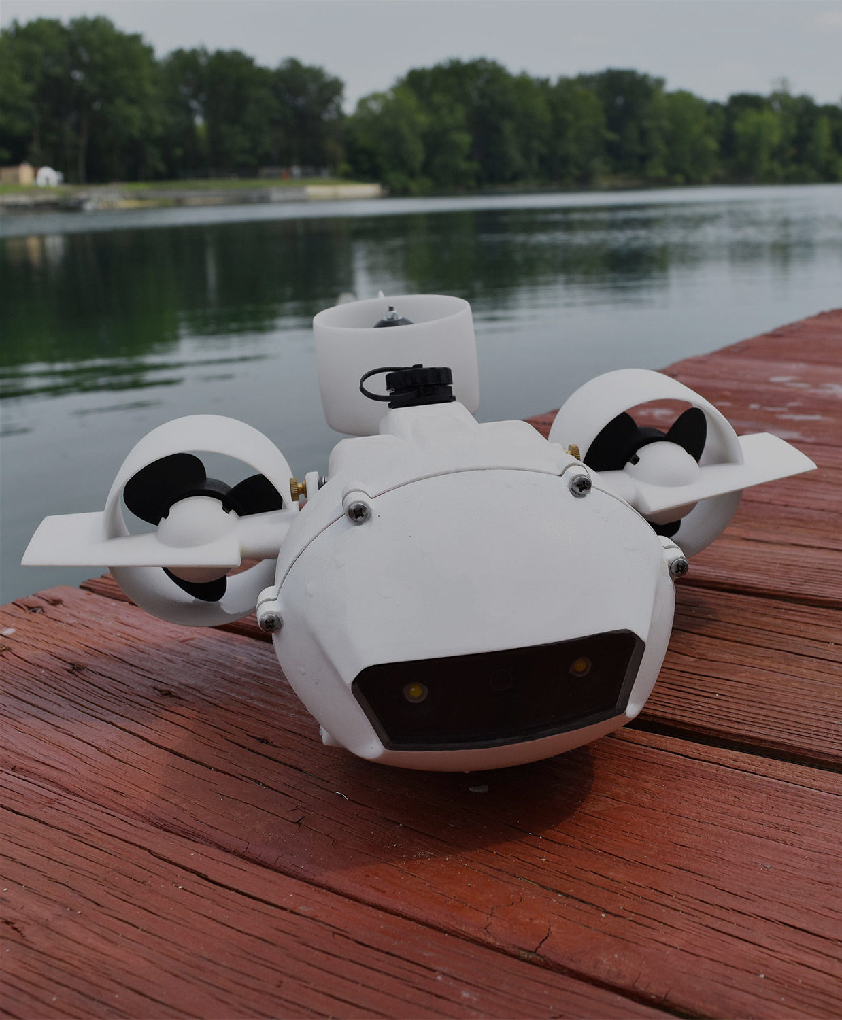
Website/April 2018/Final_Mobile/FathomOneDock_Mobile.jpg
