identitymonk/Fathom-Drone-Archive/Website/April 2018/Finals/AppBreakoutBacked.jpg

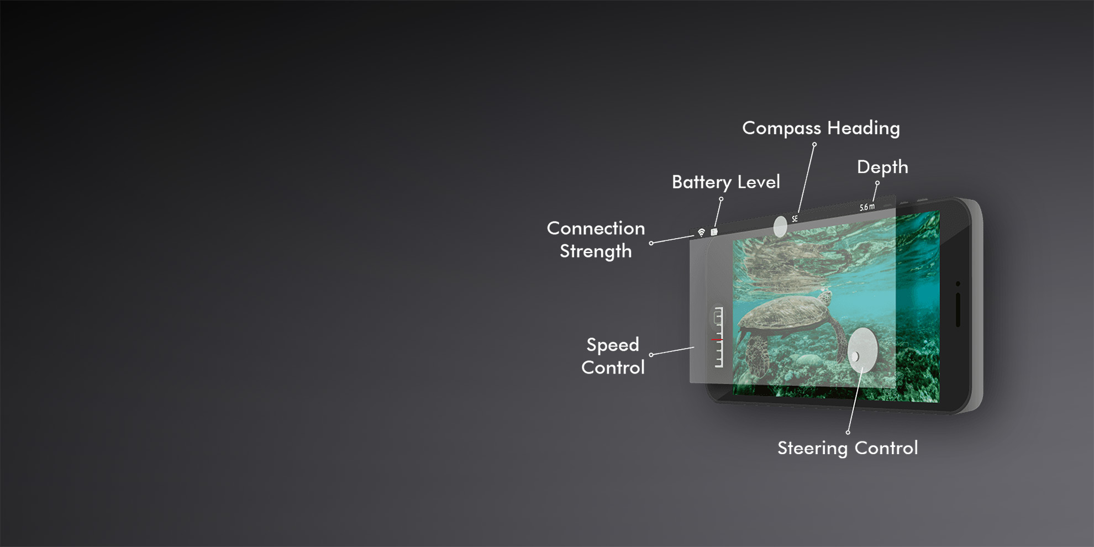
Website/April 2018/Finals/AppBreakoutBacked.jpg
