identitymonk/Fathom-Drone-Archive/Website/April 2018/Finals/Attachment.jpg

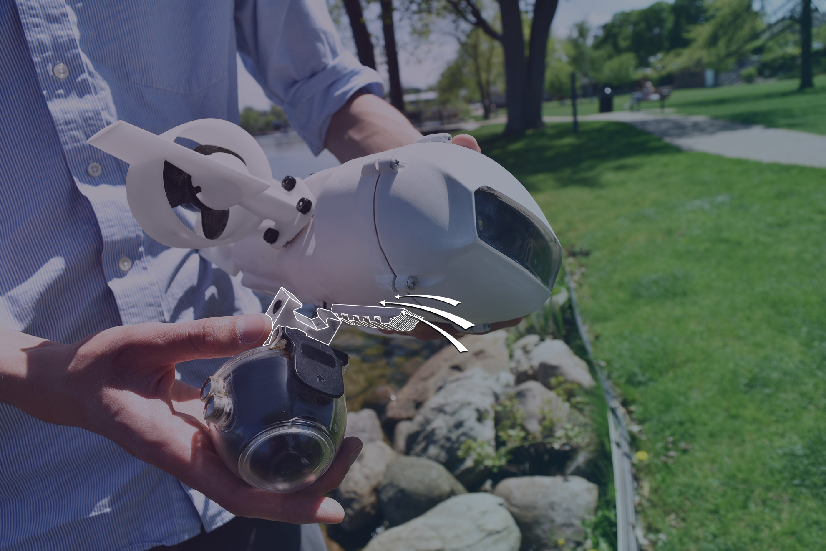
Website/April 2018/Finals/Attachment.jpg
