identitymonk/Fathom-Drone-Archive/Website/April 2018/Finals/BackgroundGradient.jpg

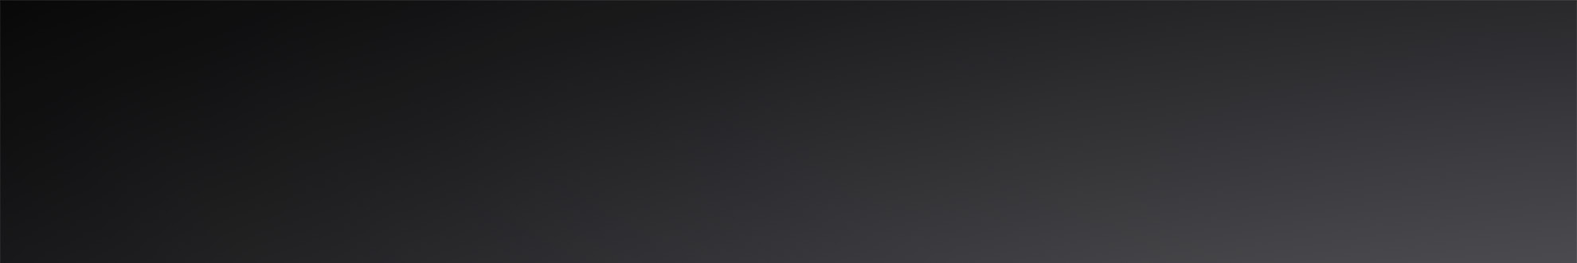
Website/April 2018/Finals/BackgroundGradient.jpg
