identitymonk/Fathom-Drone-Archive/Website/April 2018/Finals/Diver.jpg

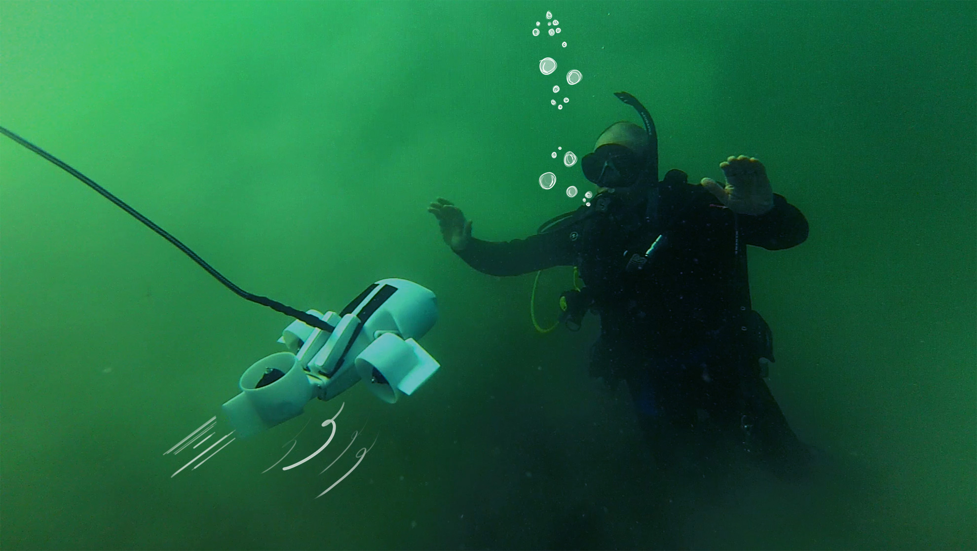
Website/April 2018/Finals/Diver.jpg
