identitymonk/Fathom-Drone-Archive/Website/April 2018/Finals/DownloadVideos.jpg

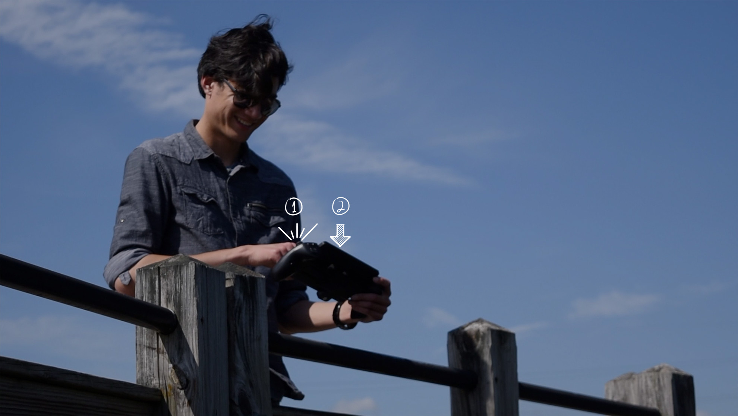
Website/April 2018/Finals/DownloadVideos.jpg
