identitymonk/Fathom-Drone-Archive/Website/April 2018/Finals/FathomPopup.jpg

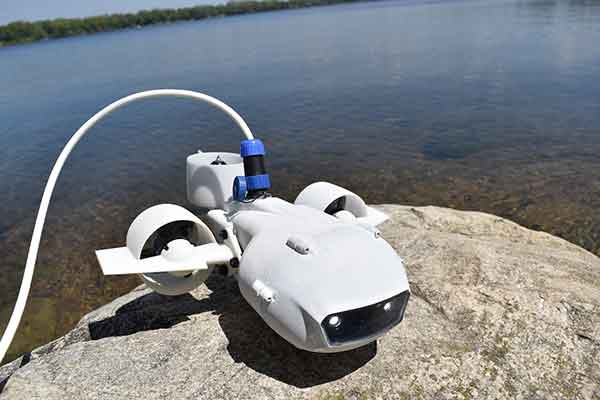
Website/April 2018/Finals/FathomPopup.jpg
