identitymonk/Fathom-Drone-Archive/Website/April 2018/Finals/HoldingOne.jpg

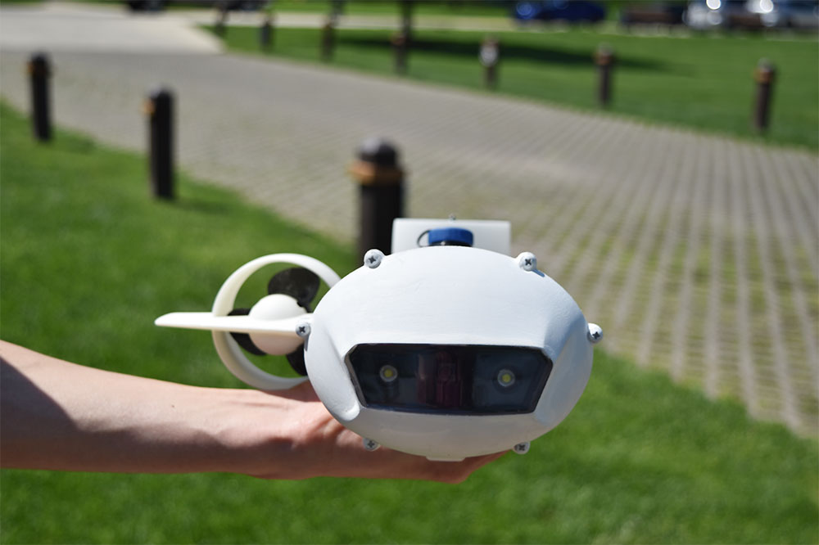
Website/April 2018/Finals/HoldingOne.jpg
