identitymonk/Fathom-Drone-Archive/Website/April 2018/Finals/ModularSplit.jpg

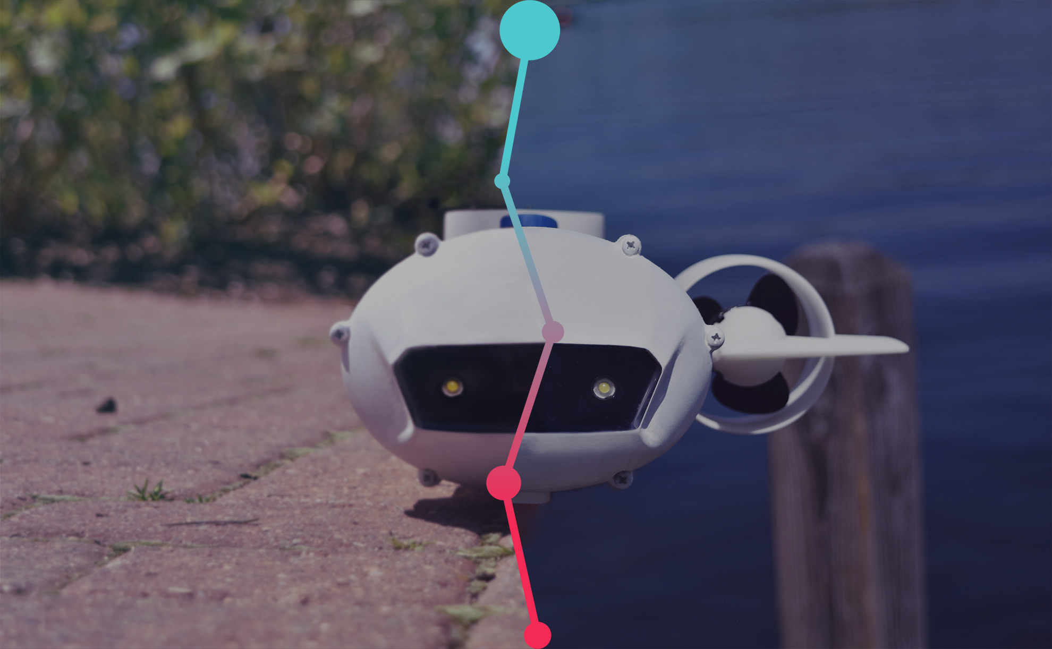
Website/April 2018/Finals/ModularSplit.jpg
