identitymonk/Fathom-Drone-Archive/Website/April 2018/Finals/Plug2.jpg

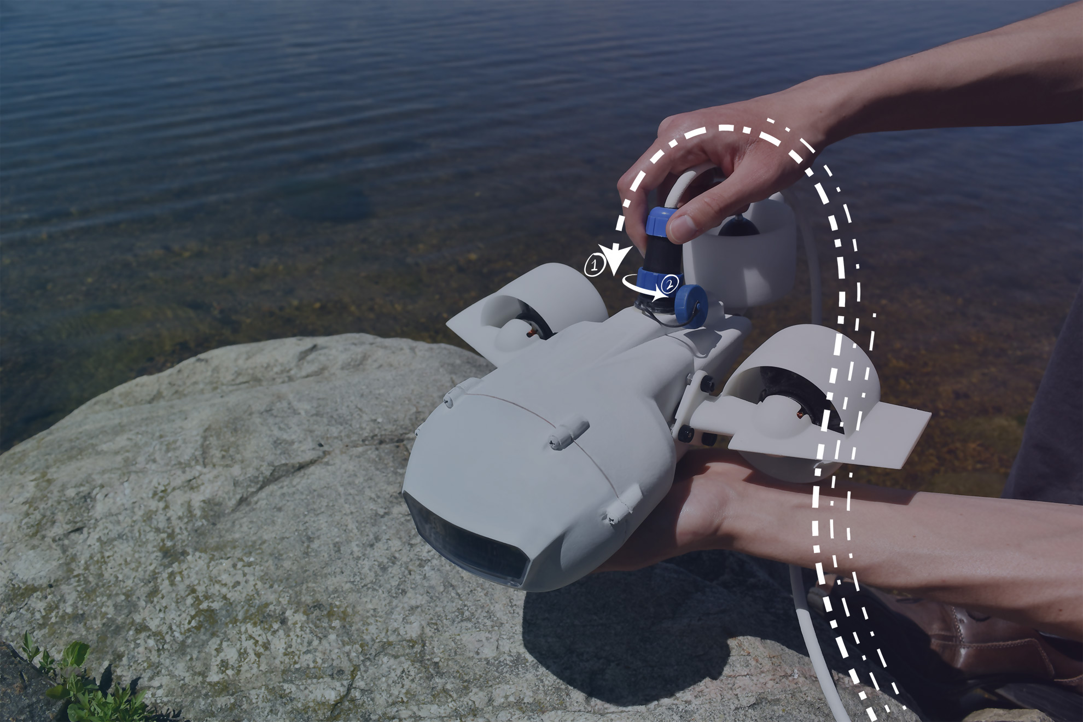
Website/April 2018/Finals/Plug2.jpg
