identitymonk/Fathom-Drone-Archive/Website/April 2018/Finals/Plug.jpg

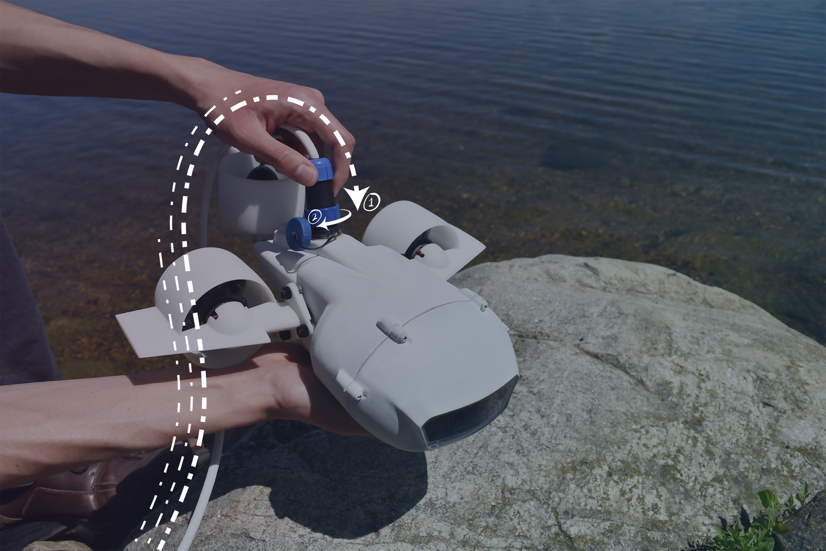
Website/April 2018/Finals/Plug.jpg
