identitymonk/Fathom-Drone-Archive/Website/April 2018/Finals/Portable.jpg

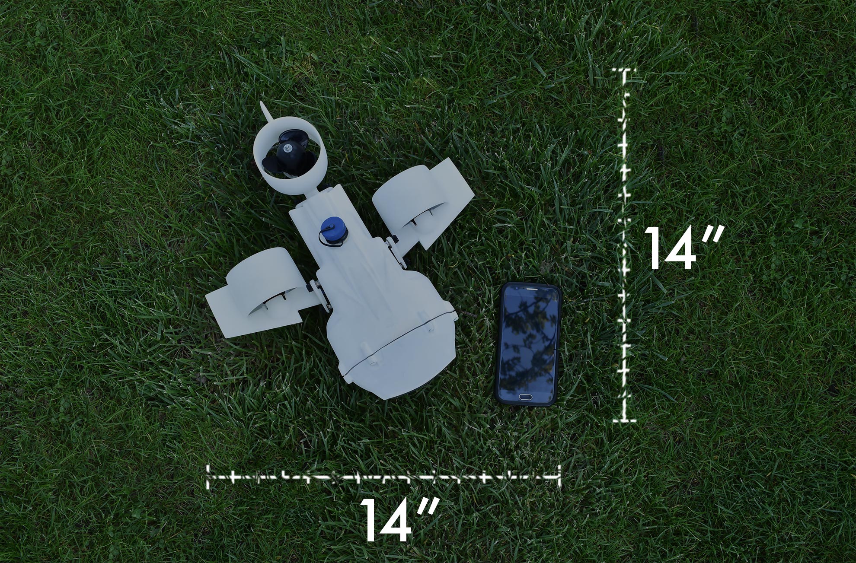
Website/April 2018/Finals/Portable.jpg
