identitymonk/Fathom-Drone-Archive/Website/April 2018/Finals/TabletAppHolding.jpg

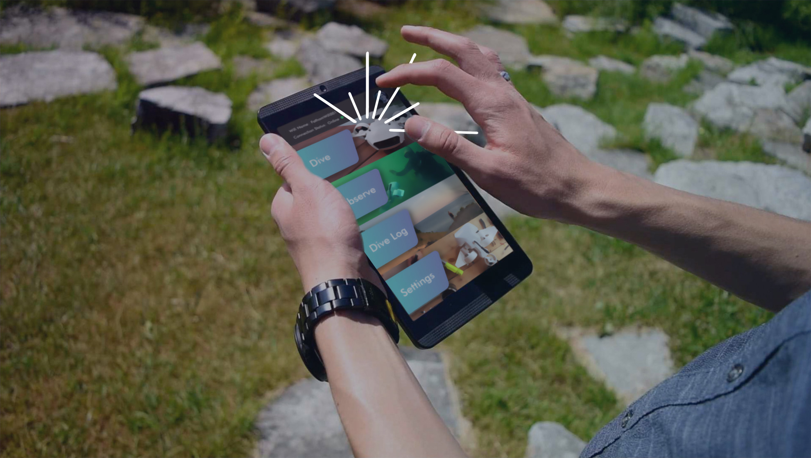
Website/April 2018/Finals/TabletAppHolding.jpg
