identitymonk/Fathom-Drone-Archive/Website/April 2018/Finals/UnderwaterFlight.jpg

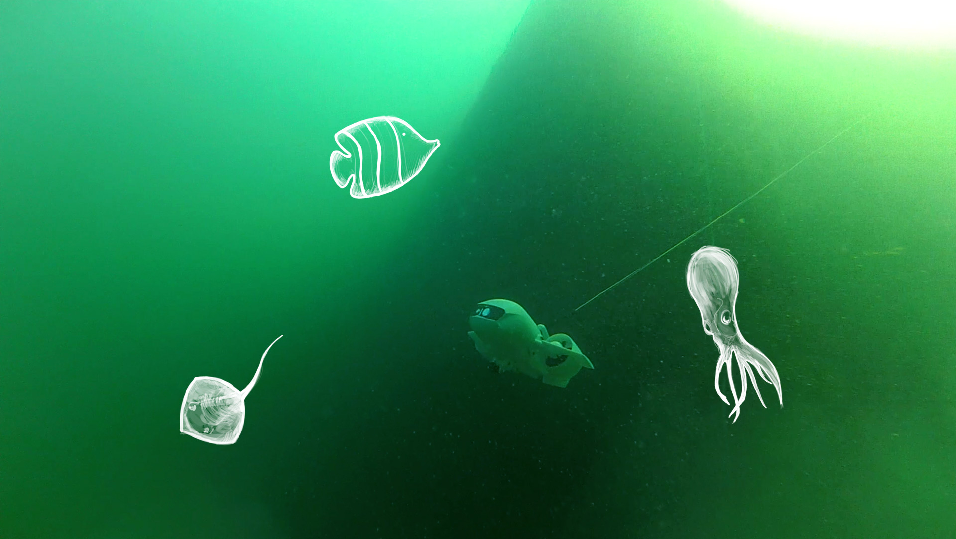
Website/April 2018/Finals/UnderwaterFlight.jpg
