identitymonk/Fathom-Drone-Archive/Website/April 2018/Finals/WholeSystem.jpg

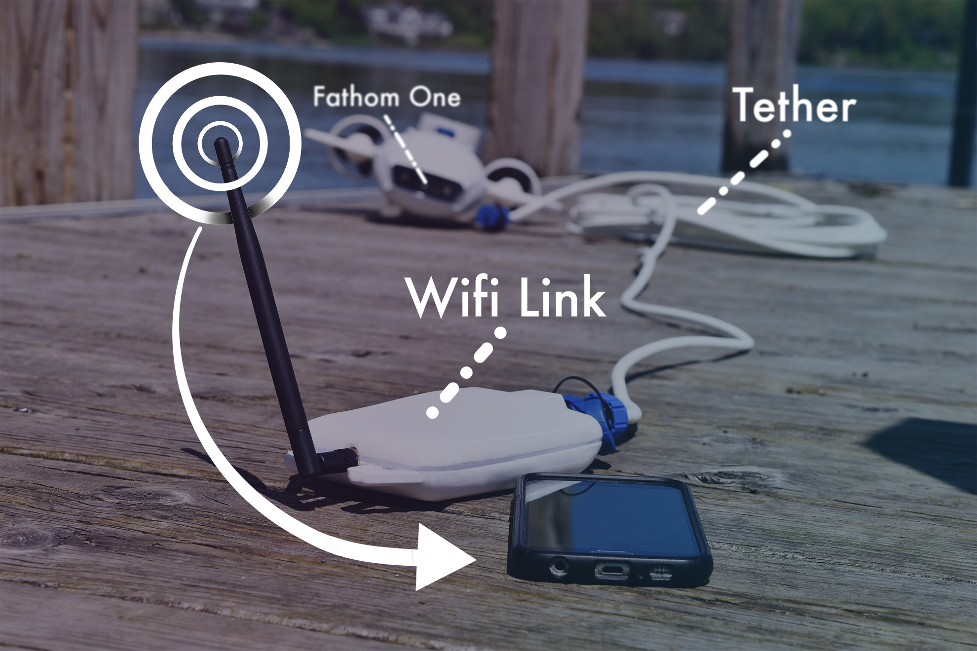
Website/April 2018/Finals/WholeSystem.jpg
