identitymonk/Fathom-Drone-Archive/Website/April 2018/Illustrations/ActionRail-assets/ActionRail.png

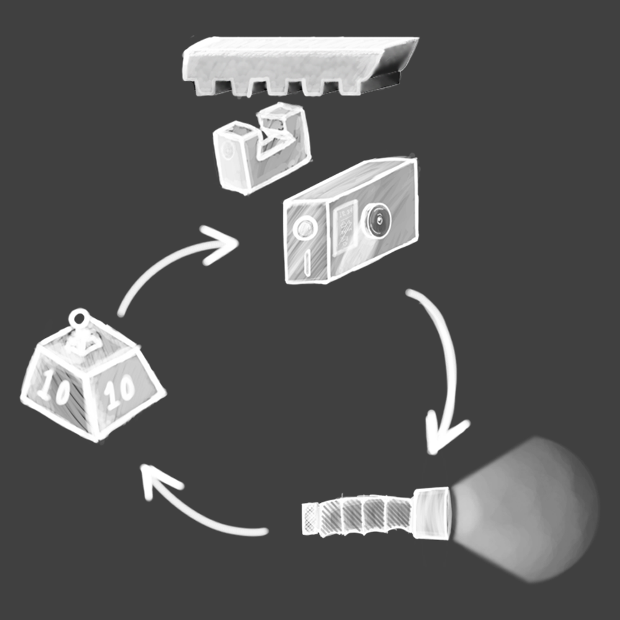
Website/April 2018/Illustrations/ActionRail-assets/ActionRail.png
