identitymonk/Fathom-Drone-Archive/Website/April 2018/Illustrations/LinkandTether-assets/How It Works.png

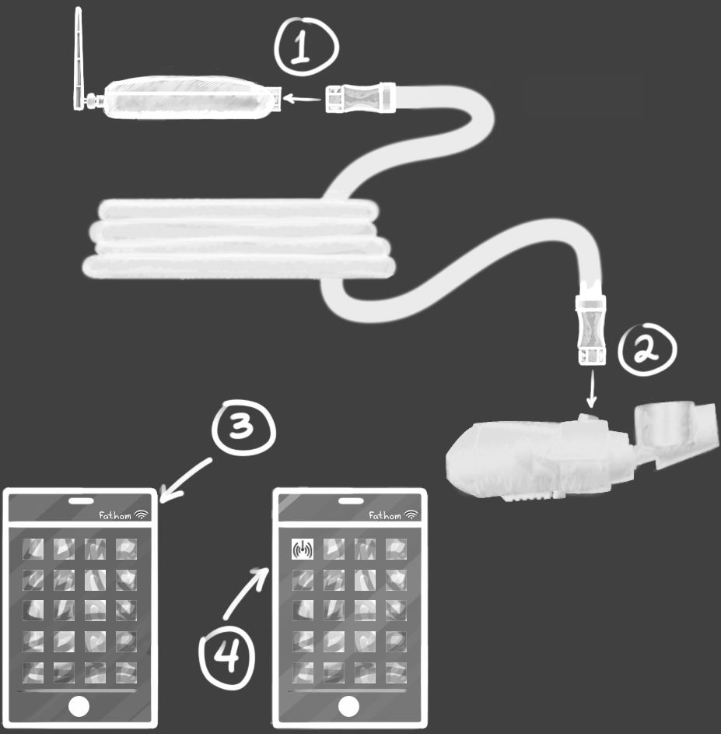
Website/April 2018/Illustrations/LinkandTether-assets/How It Works.png
