identitymonk/Fathom-Drone-Archive/Website/April 2018/Illustrations/TetherPhysics-assets/WirelessPhysics.png

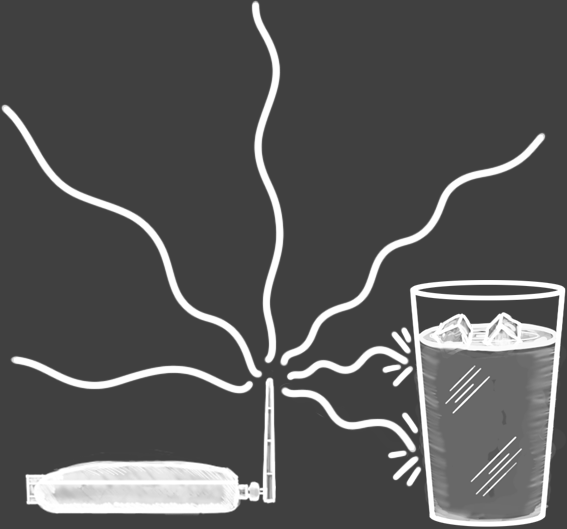
Website/April 2018/Illustrations/TetherPhysics-assets/WirelessPhysics.png
