identitymonk/Fathom-Drone-Archive/Website/April 2018/Illustrator Assets/ConnectGo1.png

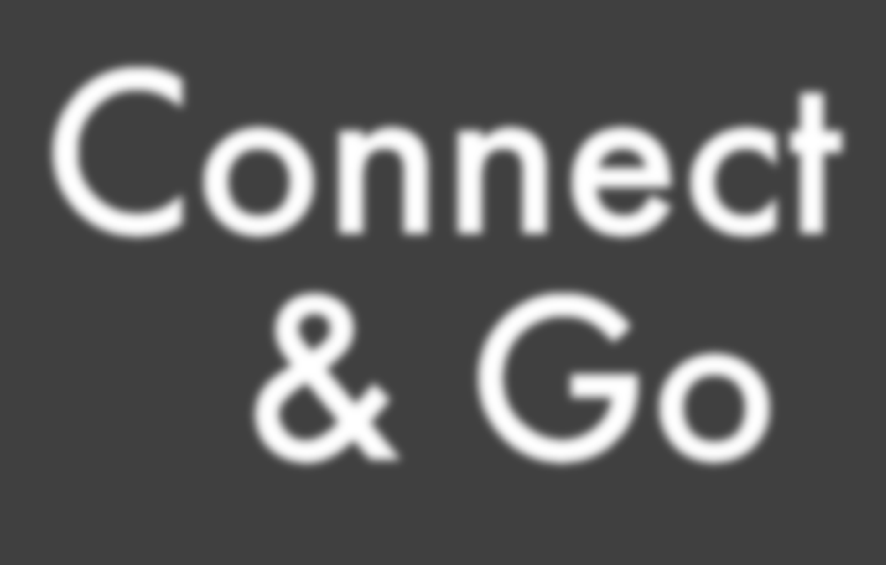
Website/April 2018/Illustrator Assets/ConnectGo1.png
