identitymonk/Fathom-Drone-Archive/Website/April 2018/Illustrator Assets/Dive.png

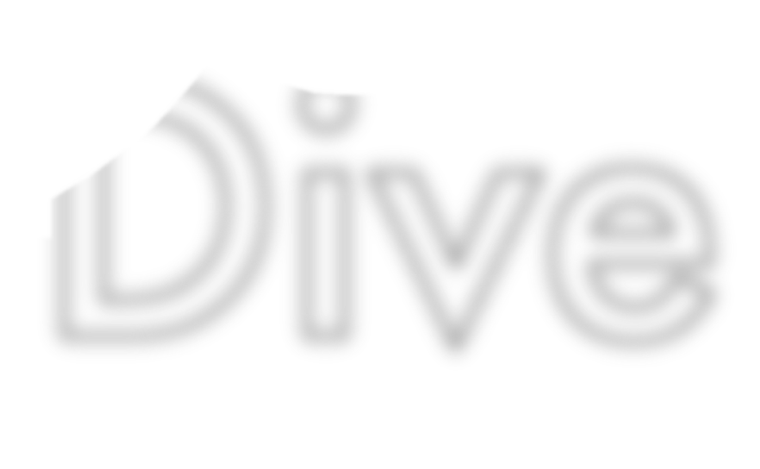
Website/April 2018/Illustrator Assets/Dive.png
