identitymonk/Fathom-Drone-Archive/Website/April 2018/Illustrator Assets/Divider.png

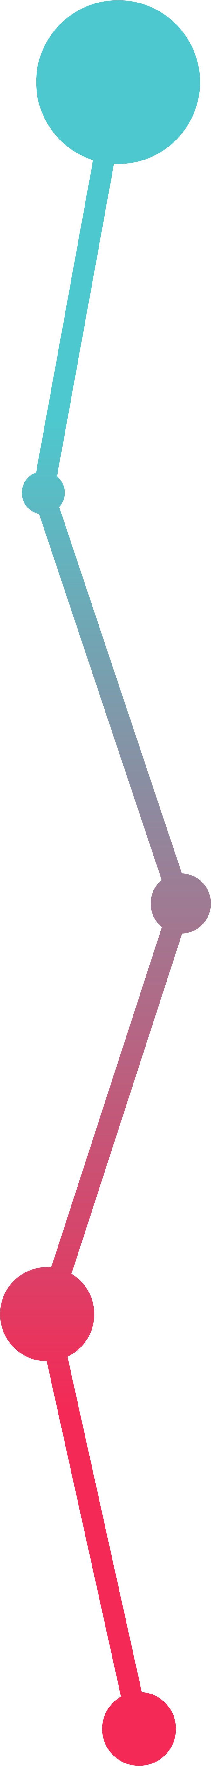
Website/April 2018/Illustrator Assets/Divider.png
