identitymonk/Fathom-Drone-Archive/Website/April 2018/Illustrator Assets/FathomOne.png

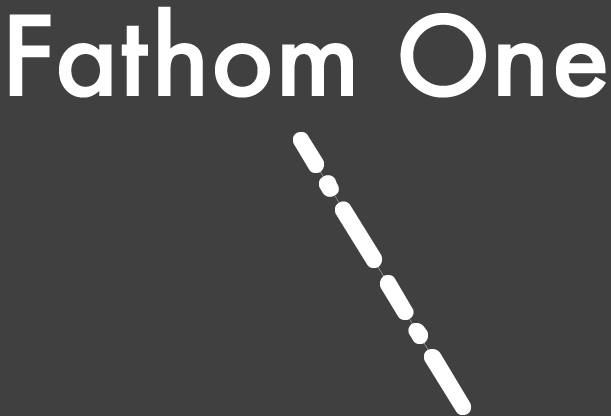
Website/April 2018/Illustrator Assets/FathomOne.png
