identitymonk/Fathom-Drone-Archive/Website/April 2018/Illustrator Assets/Tether.png

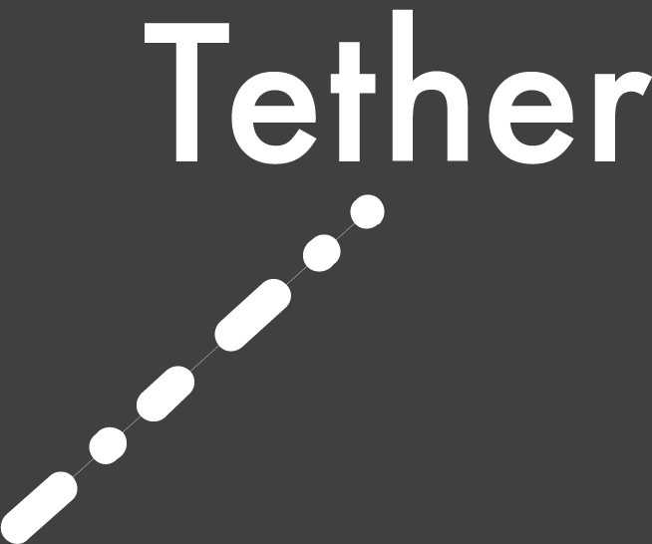
Website/April 2018/Illustrator Assets/Tether.png
