identitymonk/Fathom-Drone-Archive/Website/April 2018/Illustrator Assets/Travel.png

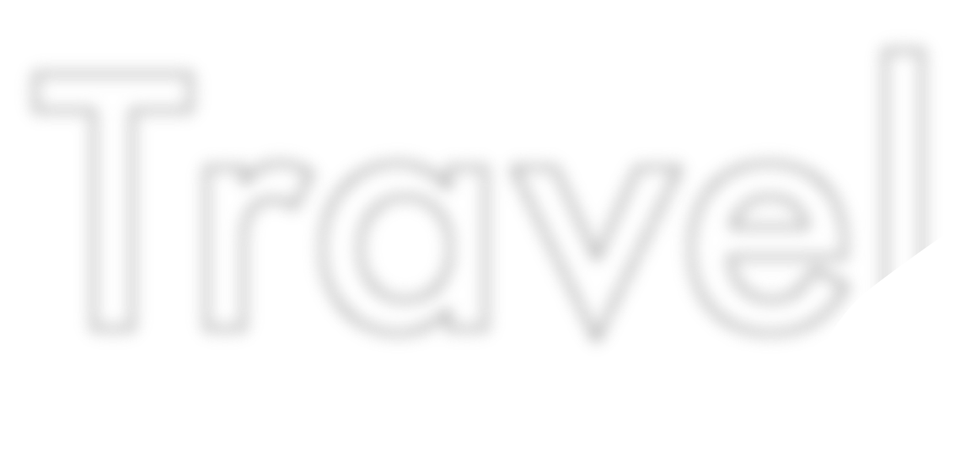
Website/April 2018/Illustrator Assets/Travel.png
