identitymonk/Fathom-Drone-Archive/Website/April 2018/Illustrator Assets/Whole System Text.png

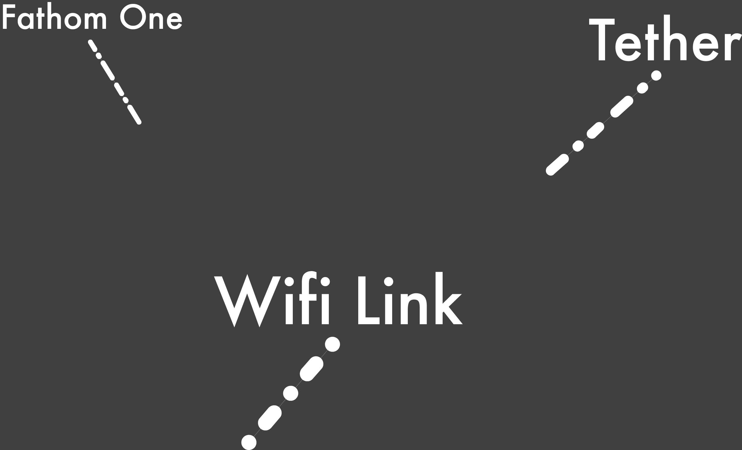
Website/April 2018/Illustrator Assets/Whole System Text.png
