identitymonk/Fathom-Drone-Archive/Website/April 2018/Illustrator Assets/WifiLink.png

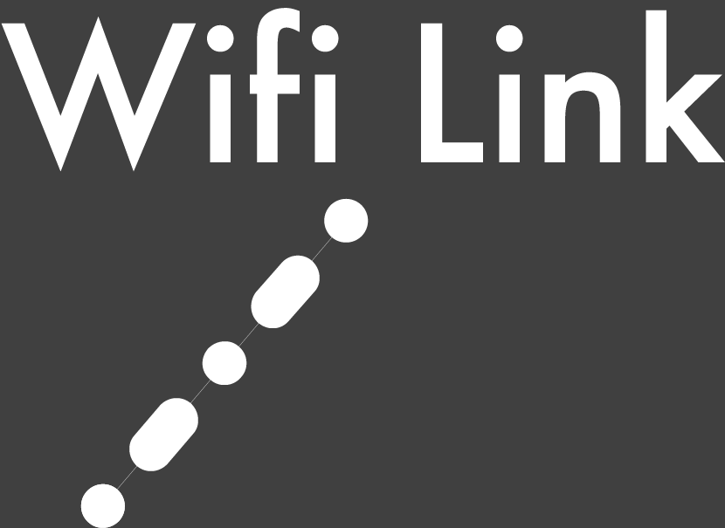
Website/April 2018/Illustrator Assets/WifiLink.png
