identitymonk/Fathom-Drone-Archive/Assembly Instructions/Supplier Information - Sheet1.pdf

## Fathom One Supplier Contact Information

Component | Contact Name | Email | Company Name
Drone Tether | Howie Wong | sales@comnen.com | Comnen Technology Co., Limited
Drone Charger | Lynn Lin | sales19@ryderbattery.com | Ryder Electronics
Topside Routerboard | Lydia Yang | lydia@alfa.com.tw | Alfa Networks Inc.
Custom 800 KV Brushless Motors | Callie Lu | info.aoxan@foxmail.com | Shenzhen Aoyuxiang Electronic Technology Co.,Ltd
Pressure Transducer | Amy Huang | 8017@kogean.cn | Joint Sensor Instruments Ltd.
Injection Molding | Justin Howard | Justin.Howard@3dsystems.com | 3D Systems
Custom 20A ESC | HobbyKing Wholesale | wholesale@hobbyking.com | HexTronik Ltd.
11.1V Lithium Polymer Pack | Amence Leu | amence@cxjtechnology.com | Shenzhen Chuangxinjia Technology Co.,LTD
Fathom One Robotics Core | Andrew Hamilton | andy@magnum-gr.com | Magnum Engineering
