identitymonk/Fathom-Drone-Archive/Assembly Instructions/F1_BOM_103117 (1).xlsx

Sheet: Flat Costed BOM
This is a generated report. Changes made to this sheet will be lost the next time the report is generated.
Type | Part Number | Part Name | Description | Lead Time (wk) | MOQ | Fixed Cost (USD) | Unit Cost (USD) | Quantity | Ext. Cost (USD)
PCB | PCBA-0001 | F1-CORE | Raspberry Pi 3 Robotics Shield |  |  |  | $44.000 | 1 | $44.000
PCB |  |  |  | 0 | 0 | $0.000 |  | 1 | $44.000
Fabricated Part | MH_001 | FP-0001 | F1 HULL | 8 | 600 |  | $6.600 | 1 | $6.600
Fabricated Part | FW_001 | FP-0002 | FRONT CAP | 8 | 600 |  | $3.000 | 1 | $3.000
Fabricated Part | TS_001 | FP-0003 | THRUSTER HOUSING | 8 | 1800 |  | $3.250 | 3 | $9.750
Fabricated Part | PR_001 | FP-0004 | PROP (R) | 8 | 600 |  | $1.400 | 1 | $1.400
Fabricated Part | PL-T_001 | FP-0005 | PROP (L/T) | 8 | 1200 |  | $1.400 | 2 | $2.800
Fabricated Part | BS_001 | FP-0006 | WIRELESS TRANSMITTER TOP | 8 | 600 |  | $3.000 | 1 | $3.000
Fabricated Part | BC_001 | FP-0007 | WIRELESS TRANSMITTER BOTTOM | 8 | 600 |  | $2.900 | 2 | $5.800
Fabricated Part | FC_001 | FP-0008 | CAMERA MOUNT | 8 | 600 |  | $2.500 | 1 | $2.500
Fabricated Part | CPU_MOUNT | FP-0009 | CPU MOUNT | 8 | 600 |  | $3.000 | 1 | $3.000
Fabricated Part | PIC_RAIL | FP-0010 | PICATINNY RAIL | 8 | 600 |  | $1.500 | 1 | $1.500
Fabricated Part |  |  |  | 8 | 1800 | $0.000 |  | 14 | $39.350
Purchased Part | M641-150psi A-1C32 | PP-0001 | 150 PSI PRESSURE TRANSDUCER WITH ANALOG OUTPUT |  |  | $0.000 | $30.000 | 1 | $30.000
Purchased Part | 9192000310-0 | PP-0002 | CUSTOM 20A BRUSHLESS SPEED CONTROLLER W/ FORWARD AND REVERSE FUNCTION |  |  | $0.000 | $9.900 | 3 | $29.700
Purchased Part | AR9331 | PP-0003 | 802.11 WIFI ROUTER MODULE |  |  | $0.000 | $16.700 | 1 | $16.700
Purchased Part | C6U001 | PP-0004 | 100 FT TETHER |  |  | $0.000 | $82.800 | 1 | $82.800
Purchased Part | TBD | PP-0005 | 3W LED |  |  | $0.000 | $0.420 | 2 | $0.840
Purchased Part | TBD | PP-0006 | 11.1V, 5200 MAH, 10C LITHIUM POLYMER BATTERY PACK |  |  | $0.000 | $32.000 | 1 | $32.000
Purchased Part | AX2312N | PP-0007 | CUSTOM RUGGEDIZED 800KV THREE PHASE BRUSHLESS MOTOR W/ RING TERMINALS |  |  | $0.000 | $21.000 | 3 | $63.000
Purchased Part | RASPBERRYPI3-MODB-1GB | PP-0008 | RASPBERRY PI 3 MODEL B |  |  | $0.000 | $34.500 | 1 | $34.500
Purchased Part | RPI 8MP CAMERA BOARD | PP-0009 | RASPBERRY PI CAMERA V2 |  |  | $0.000 | $25.000 | 1 | $25.000
Purchased Part | TBD | PP-0010 | 3S BALANCE LEAD EXTENSION |  |  | $0.000 | $2.470 | 1 | $2.470
Purchased Part | TBD | PP-0011 | CLASS 10 16GB MICRO SD CARD |  |  | $0.000 | $10.040 | 1 | $10.040
Purchased Part | TBD | PP-0012 | 5 DBI ANTENNA W/ LOCK WASHER AND NUT |  |  | $0.000 | $0.750 | 1 | $0.750
Purchased Part | TBD | PP-0013 | IPEX-RSMA(F)1.13-10 |  |  | $0.000 | $0.850 | 1 | $0.850
Purchased Part | JMC002-11 | PP-0014 | DRONE CHARGER |  |  | $0.000 | $16.510 | 1 | $16.510
Purchased Part | SD13 | PP-0015 | 4-PIN WATERPROOF CONNECTOR M/F - INCLUDED WITH CHARGER |  |  | $0.000 | $3.000 | 1 | $3.000
Purchased Part | SP2110/P10-SY2112/S10 | PP-0016 | 10-PIN WATERPROOF CONNECTOR M/F - INCLUDED WITH TETHER |  |  | $0.000 | $4.000 | 2 | $8.000
Purchased Part | 4.304 x .070 – 50SLR | PP-0017 | FACE GASKET ORING |  |  | $0.000 | $0.861 | 1 | $0.861
Purchased Part | TBD | PP-0018 | STEEL BALLAST STOCK (2.85’’ x 2.5’’ x 0.25’’) |  |  | $0.000 | $3.000 | 1 | $3.000
Purchased Part | TBD | PP-0019 | STEEL BALLAST STOCK (3.64’’ x 2.5’’ x 0.25’’) |  |  | $0.000 | $3.000 | 1 | $3.000
Purchased Part | 624/625 | PP-0020 | 624/625 POTTING FOAM COMPOUND |  |  | $0.000 | $0.100 | 1 | $0.100
Purchased Part | 92745A371 | PP-0021 | #4-40 0.25'' NYLON STANDOFF |  |  | $0.000 | $0.500 | 4 | $2.000
Purchased Part | 94812A200 | PP-0022 | #4-40 NYLON HEX NUT |  |  | $0.000 | $0.060 | 4 | $0.240
Purchased Part | 93135A272 | PP-0023 | #4-40 0.25'' NYLON SCREW |  |  | $0.000 | $0.060 | 4 | $0.240
Purchased Part | 93886A110 | PP-0025 | #6-32 PLASTIC THUMB NUT |  |  | $0.000 | $0.803 | 9 | $7.227
Purchased Part | 99461A615 | PP-0027 | #1 1/4'' SELF THREADING SCREWS |  |  | $0.000 | $0.230 | 12 | $2.760
Purchased Part | 97975A215 | PP-0029 | #6 5/8'' HIGH-LOW SELF THREADING SCREW |  |  | $0.000 | $0.060 | 10 | $0.600
Purchased Part | 93330A470 | PP-0030 | #6-32 3/16'' ROUND THREADED STANDOFF |  |  | $0.000 | $0.500 | 9 | $4.500
Purchased Part | TBD | PP-0031 | RJ45 PLUG - INCLUDED WITH TETHER |  |  | $0.000 | $0.000 | 2 | $0.000
Purchased Part | TBD | PP-0032 | SOLDER |  |  | $0.000 | $0.100 | 1 | $0.100
Purchased Part | TBD | PP-0033 | 15'' 26 AWG STRANDED COPPER WIRING |  |  | $0.000 | $0.100 | 1 | $0.100
Purchased Part | TBD | PP-0034 | 10K OHM NTC THERMISTOR (4050K B CONSTANT) |  |  | $0.000 | $0.100 | 2 | $0.200
Purchased Part | 99461A605 | PP-0035 | #1 1/8'' SELF THREADING SCREWS |  |  | $0.000 | $0.230 | 6 | $1.380
Purchased Part | 90380A144 | PP-0036 | #6 1/4'' SELF THREADING SCREWS |  |  | $0.000 | $0.073 | 7 | $0.511
Purchased Part | 92314A151 | PP-0037 | #6-32 0.75'' HEX HEAD SCREW |  |  | $0.000 | $0.137 | 9 | $1.233
Purchased Part | 209728 | PP-0038 | LOCTITE THREADLOCKER BLUE 242 |  |  | $0.000 | $0.100 | 1 | $0.100
Purchased Part | TBD | PP-0039 | M3 STAINLESS WASHER - INCLUDED WITH MOTOR |  |  | $0.000 | $0.000 | 3 | $0.000
Purchased Part | TBD | PP-0040 | M3 STAINLESS STEEL LOCK NUT - INCLUDED WITH MOTOR |  |  | $0.000 | $0.000 | 3 | $0.000
Purchased Part | TBD | PP-0041 | MIXING CUP |  |  | $0.000 | $0.050 | 1 | $0.050
Purchased Part | TBD | PP-0042 | MIXING STICK |  |  | $0.000 | $0.050 | 1 | $0.050
Purchased Part | TBD | PP-0043 | SILICONE GREASE |  |  | $0.000 | $0.050 | 1 | $0.050
Purchased Part | TBD | PP-0044 | POLYCARBONATE INDUSTRIAL ADHESIVE |  |  | $0.000 | $0.200 | 1 | $0.200
Purchased Part | TBD | PP-0045 | SILICA GEL PACKET |  |  | $0.000 | $0.050 | 1 | $0.050
Purchased Part |  |  |  | 0 | 0 | $0.000 |  | 118 | $384.712
PCB Component | C10 |  | CAP CER 10PF 50V C0G/NP0 0603 |  |  | $0.000 | $0.000 | 1 | $0.000
PCB Component | C9 |  | CAP CER 470PF 50V X7R 0603 |  |  | $0.000 | $0.000 | 1 | $0.000
PCB Component | C7,C25 |  | CAP CER 10000PF 50V X7R 0402 |  |  | $0.000 | $0.000 | 2 | $0.000
PCB Component | C2,C21,C24,C27-C30 |  | CAP CER 0.1UF 50V X7R 0402 |  |  | $0.000 | $0.000 | 7 | $0.000
PCB Component | C4,C8 |  | CAP CER 0.47UF 16V X7R 0603 |  |  | $0.000 | $0.000 | 2 | $0.000
PCB Component | C12,C13,C15-C19,C23,C46,C47 |  | CAP CER 1UF 10V X5R 0402 |  |  | $0.000 | $0.000 | 10 | $0.000
PCB Component | C1,C3 |  | CAP CER 2.2UF 25V X5R 0603 |  |  | $0.000 | $0.000 | 2 | $0.000
PCB Component | C5,C11,C26 |  | CAP CER 10UF 10V X5R 0805 |  |  | $0.000 | $0.000 | 3 | $0.000
PCB Component | C6,C22 |  | CAP CER 10UF 50V X5R 1206 |  |  | $0.000 | $0.000 | 2 | $0.000
PCB Component | C20 |  | CAP ALUM POLY 150UF 20% 6.3V SMD |  |  | $0.000 | $0.000 | 1 | $0.000
PCB Component | C14 |  | CAP ALUM 470UF 20% 25V RADIAL |  |  | $0.000 | $0.000 | 1 | $0.000
PCB Component | D1 |  | DIODE ZENER 12V 225MW SOT23-3 |  |  | $0.000 | $0.000 | 1 | $0.000
PCB Component | D2,D3,D6 |  | DIODE SCHOTTKY 40V 3A SMA |  |  | $0.000 | $0.000 | 3 | $0.000
PCB Component | D8 |  | TVS DIODE 15VWM 24.4VC SOD123F |  |  | $0.000 | $0.000 | 1 | $0.000
PCB Component | D5 |  | TVS DIODE 18VWM 29.2VC SMC |  |  | $0.000 | $0.000 | 1 | $0.000
PCB Component | D4 |  | DIODE GEN PURP 100V 150MA SOD123 |  |  | $0.000 | $0.000 | 1 | $0.000
PCB Component | F1 |  | PTC RESETTABLE 30V 500MA 1812 |  |  | $0.000 | $0.000 | 1 | $0.000
PCB Component | IC1 |  | IC LED DRVR RGLTR DIM 1A 16TSSOP |  |  | $0.000 | $0.000 | 1 | $0.000
PCB Component | IC2 |  | IC REG BUCK ADJ 5A 16-MSOP |  |  | $0.000 | $0.000 | 1 | $0.000
PCB Component | IC3 |  | IC ADC 12BIT I2C 3.3KSPS 10MSOP |  |  | $0.000 | $0.000 | 1 | $0.000
PCB Component | IC16 |  | IC LVL XLTR LV 8MBPS SOT23-8 |  |  | $0.000 | $0.000 | 1 | $0.000
PCB Component | J1 |  | TERM BLOCK 6POS SIDE ENT 5.08MM |  |  | $0.000 | $0.000 | 1 | $0.000
PCB Component | J2,J7 |  | CONN TERM BLOCK 2.54MM 2POS PCB |  |  | $0.000 | $0.000 | 2 | $0.000
PCB Component | J5 |  | CONN TERM BLOCK 2.54MM 3POS PCB |  |  | $0.000 | $0.000 | 1 | $0.000
PCB Component | J3,J6 |  | CONN TERM BLOCK 2.54MM 4POS PCB |  |  | $0.000 | $0.000 | 2 | $0.000
PCB Component | J4 |  | CONN TERM BLOCK 2.54MM 6POS PCB |  |  | $0.000 | $0.000 | 1 | $0.000
PCB Component | L1 |  | FIXED IND 6.8UH 1.45A 98 MOHM |  |  | $0.000 | $0.000 | 1 | $0.000
PCB Component | L2 |  | FIXED IND 2.2UH 7.4A 11.5 MOHM |  |  | $0.000 | $0.000 | 1 | $0.000
PCB Component | Q1 |  | MOSFET N-CH 40V 120A TO263-3-2 |  |  | $0.000 | $0.000 | 1 | $0.000
PCB Component | R4 |  | RES SMD 0.0 OHM JUMPER 1/8W 0805 |  |  | $0.000 | $0.000 | 1 | $0.000
PCB Component | R10 |  | RES SMD 2.2 OHM 1% 1/10W 0603 |  |  | $0.000 | $0.000 | 1 | $0.000
PCB Component | R22-R24 |  | RES SMD 100 OHM 1% 1/10W 0603 |  |  | $0.000 | $0.000 | 3 | $0.000
PCB Component | R18,R25-R29,R31 |  | RES SMD 300 OHM 1% 1/16W 0402 |  |  | $0.000 | $0.000 | 7 | $0.000
PCB Component | R2,R3 |  | RES SMD 2.2K OHM 1% 1/10W 0603 |  |  | $0.000 | $0.000 | 2 | $0.000
PCB Component | R13-R16,R20,R65,R66 |  | RES SMD 3.3K OHM 1% 1/16W 0402 |  |  | $0.000 | $0.000 | 7 | $0.000
PCB Component | R1,R17,R19,R21,R30,R51 |  | RES SMD 10K OHM 1% 1/10W 0603 |  |  | $0.000 | $0.000 | 6 | $0.000
PCB Component | R9 |  | RES SMD 14.7K OHM 1% 1/10W 0603 |  |  | $0.000 | $0.000 | 1 | $0.000
PCB Component | R6,R7 |  | RES SMD 33K OHM 1% 1/10W 0603 |  |  | $0.000 | $0.000 | 2 | $0.000
PCB Component | R8 |  | RES SMD 100K OHM 1% 1/10W 0603 |  |  | $0.000 | $0.000 | 1 | $0.000
PCB Component | R12 |  | RES SMD 316K OHM 1% 1/10W 0603 |  |  | $0.000 | $0.000 | 1 | $0.000
PCB Component | R5 |  | RES SMD 470K OHM 1% 1/10W 0603 |  |  | $0.000 | $0.000 | 1 | $0.000
PCB Component | R11 |  | RES SMD 1M OHM 1% 1/10W 0603 |  |  | $0.000 | $0.000 | 1 | $0.000
PCB Component | T1 |  | MOSFET N-CH 60V 0.115A SOT-23 |  |  | $0.000 | $0.000 | 1 | $0.000
PCB Component | U1 |  | IC LED DRIVER RGBA 28-TSSOP |  |  | $0.000 | $0.000 | 1 | $0.000
PCB Component | U6 |  | IMU ACCEL/GYRO/MAG |  |  | $0.000 | $0.000 | 1 | $0.000
PCB Component | X1-X3 |  | FERRITE BEAD 120 OHM 0603 1LN |  |  | $0.000 | $0.000 | 3 | $0.000
PCB Component | PI |  | CONN HEADR FMALE 40POS .1" DL AU |  |  | $0.000 | $0.000 | 1 | $0.000
PCB Component | XT60 |  | XT60 POWER CONNECTOR |  |  | $0.000 | $0.500 | 1 | $0.500
PCB Component | WIRE |  | 5'' 14 AWG SILICONE BATTERY WIRE |  |  | $0.000 | $0.200 | 1 | $0.200
PCB Component |  |  |  | 0 | 0 | $0.000 |  | 97 | $0.700
Packaging | PACK-001 | DRONE BOX | Packaging for the Fathom One Drone, Topside Wireless Transmitter, and Tether | 3 | 600 | $0.000 | $10.000 | 1 | $10.000
Packaging |  |  |  | 3 | 600 | $0.000 |  | 1 | $10.000
All Parts |  |  |  | 8 | 1800 | $0.000 |  | 231 | $478.762

Sheet: Purchased Parts
Detailed list of off-the-shelf components in your product such as batteries, accessories, fasteners, etc.
Quantity | Part Number | Part Name | Description | Manufacturer | MPN | Procurement Method | Lead Time (wk) | MOQ | Fixed Cost (USD) | Unit Cost (USD) | Ext. Cost (USD) | Notes
1 | M641-150psi A-1C32 | PP-0001 | 150 PSI PRESSURE TRANSDUCER WITH ANALOG OUTPUT | Joint Sensor Instruments Ltd. | M641-150psi A-1C32 | Assigned |  |  | $0.000 | $30.00 | $30.000
3 | 9192000310-0 | PP-0002 | CUSTOM 20A BRUSHLESS SPEED CONTROLLER W/ FORWARD AND REVERSE FUNCTION | Hextronic Ltd | 9192000310-0 | Assigned |  |  | $0.000 | $9.90 | $29.700
1 | AR9331 | PP-0003 | 802.11 WIFI ROUTER MODULE | Alfa Network Inc. | AR9331 | Assigned |  |  | $0.000 | $16.70 | $16.700
1 | C6U001 | PP-0004 | 100 FT TETHER | Comnen Technology Co., Limited | C6U001 | Generic |  |  | $0.000 | $82.80 | $82.800
2 | TBD | PP-0005 | 3W LED | TBD | TBD | Generic |  |  | $0.000 | $0.42 | $0.840
1 | TBD | PP-0006 | 11.1V, 5200 MAH, 10C LITHIUM POLYMER BATTERY PACK | Shenzhen Chuangxinjia Technology Co., Ltd | TBD | Generic |  |  | $0.000 | $32.00 | $32.000
3 | AX2312N | PP-0007 | CUSTOM RUGGEDIZED 800KV THREE PHASE BRUSHLESS MOTOR W/ RING TERMINALS | Shenzhen Aoyuxiang Electronic Technology Co.,Ltd | AX2312N | Assigned |  |  | $0.000 | $21.00 | $63.000
1 | RASPBERRYPI3-MODB-1GB | PP-0008 | RASPBERRY PI 3 MODEL B | Newark Element 14 | RASPBERRYPI3-MODB-1GB | Assigned |  |  | $0.000 | $34.50 | $34.500
1 | RPI 8MP CAMERA BOARD | PP-0009 | RASPBERRY PI CAMERA V2 | Newark Element 14 | RPI 8MP CAMERA BOARD | Assigned |  |  | $0.000 | $25.00 | $25.000
1 | TBD | PP-0010 | 3S BALANCE LEAD EXTENSION | TBD | TBD | Generic |  |  | $0.000 | $2.47 | $2.470
1 | TBD | PP-0011 | CLASS 10 16GB MICRO SD CARD | Sandisk | TBD | Generic |  |  | $0.000 | $10.04 | $10.040
1 | TBD | PP-0012 | 5 DBI ANTENNA W/ LOCK WASHER AND NUT | Alfa Network Inc. | TBD | Generic |  |  | $0.000 | $0.75 | $0.750
1 | TBD | PP-0013 | IPEX-RSMA(F)1.13-10 | Alfa Network Inc. | TBD | Generic |  |  | $0.000 | $0.85 | $0.850
1 | JMC002-11 | PP-0014 | DRONE CHARGER | Ryder Electronics | JMC002-11 | Assigned |  |  | $0.000 | $16.51 | $16.510
1 | SD13 | PP-0015 | 4-PIN WATERPROOF CONNECTOR M/F - INCLUDED WITH CHARGER | Ryder Electronics | SD13 | Generic |  |  | $0.000 | $3.000 | $3.000
2 | SP2110/P10-SY2112/S10 | PP-0016 | 10-PIN WATERPROOF CONNECTOR M/F - INCLUDED WITH TETHER | Comnen Technology Co., Limited | SP2110/P10-SY2112/S10 | Generic |  |  | $0.000 | $4.00 | $8.000
1 | 4.304 x .070 – 50SLR | PP-0017 | FACE GASKET ORING | Apple Rubber | 4.304 x .070 – 50SLR | Generic |  |  | $0.000 | $0.861 | $0.861
1 | TBD | PP-0018 | STEEL BALLAST STOCK (2.85’’ x 2.5’’ x 0.25’’) | TBD | TBD | Generic |  |  | $0.000 | $3.00 | $3.000
1 | TBD | PP-0019 | STEEL BALLAST STOCK (3.64’’ x 2.5’’ x 0.25’’) | TBD | TBD | Generic |  |  | $0.000 | $3.00 | $3.000
1 | 624/625 | PP-0020 | 624/625 POTTING FOAM COMPOUND | Fibre Glast | 624/625 | Generic |  |  | $0.000 | $0.10 | $0.100
4 | 92745A371 | PP-0021 | #4-40 0.25'' NYLON STANDOFF | McMaster Carr | 92745A371 | Generic |  |  | $0.000 | $0.500 | $2.000
4 | 94812A200 | PP-0022 | #4-40 NYLON HEX NUT | McMaster Carr | 94812A200 | Generic |  |  | $0.000 | $0.060 | $0.240
4 | 93135A272 | PP-0023 | #4-40 0.25'' NYLON SCREW | McMaster Carr | 93135A272 | Generic |  |  | $0.000 | $0.060 | $0.240
9 | 93886A110 | PP-0025 | #6-32 PLASTIC THUMB NUT | McMaster Carr | 93886A110 | Generic |  |  | $0.000 | $0.803 | $7.227
12 | 99461A615 | PP-0027 | #1 1/4'' SELF THREADING SCREWS | McMaster Carr | 99461A615 | Generic |  |  | $0.000 | $0.230 | $2.760
10 | 97975A215 | PP-0029 | #6 5/8'' HIGH-LOW SELF THREADING SCREW | McMaster Carr | 97975A215 | Generic |  |  | $0.000 | $0.060 | $0.600
9 | 93330A470 | PP-0030 | #6-32 3/16'' ROUND THREADED STANDOFF | McMaster Carr | 91125A441 | Generic |  |  | $0.000 | $0.500 | $4.500
2 | TBD | PP-0031 | RJ45 PLUG - INCLUDED WITH TETHER | Comnen Technology Co., Limited | N/A | Generic |  |  | $0.000 | $0.000 | $0.000
1 | TBD | PP-0032 | SOLDER | TBD | N/A | Generic |  |  | $0.000 | $0.100 | $0.100
1 | TBD | PP-0033 | 15'' 26 AWG STRANDED COPPER WIRING | TBD | N/A | Generic |  |  | $0.000 | $0.100 | $0.100
2 | TBD | PP-0034 | 10K OHM NTC THERMISTOR (4050K B CONSTANT) | TBD | N/A | Generic |  |  | $0.000 | $0.100 | $0.200
6 | 99461A605 | PP-0035 | #1 1/8'' SELF THREADING SCREWS | Mcmaster Carr | N/A | Generic |  |  | $0.000 | $0.230 | $1.380
7 | 90380A144 | PP-0036 | #6 1/4'' SELF THREADING SCREWS | Mcmaster Carr | N/A | Generic |  |  | $0.000 | $0.073 | $0.511
9 | 92314A151 | PP-0037 | #6-32 0.75'' HEX HEAD SCREW | Mcmaster Carr | N/A | Generic |  |  | $0.000 | $0.137 | $1.233
1 | 209728 | PP-0038 | LOCTITE THREADLOCKER BLUE 242 | Henkel Adhesives | N/A | Generic |  |  | $0.000 | $0.100 | $0.100
3 | TBD | PP-0039 | M3 STAINLESS WASHER - INCLUDED WITH MOTOR | Shenzhen Aoyuxiang Electronic Technology Co.,Ltd | N/A | Generic |  |  | $0.000 | $0.000 | $0.000
3 | TBD | PP-0040 | M3 STAINLESS STEEL LOCK NUT - INCLUDED WITH MOTOR | Shenzhen Aoyuxiang Electronic Technology Co.,Ltd | N/A | Generic |  |  | $0.000 | $0.000 | $0.000
1 | TBD | PP-0041 | MIXING CUP | TBD | N/A | Generic |  |  | $0.000 | $0.050 | $0.050
1 | TBD | PP-0042 | MIXING STICK | TBD | N/A | Generic |  |  | $0.000 | $0.050 | $0.050
1 | TBD | PP-0043 | SILICONE GREASE | TBD | N/A | Generic |  |  | $0.000 | $0.050 | $0.050
1 | TBD | PP-0044 | POLYCARBONATE INDUSTRIAL ADHESIVE | TBD | N/A | Generic |  |  | $0.000 | $0.200 | $0.200
1 | TBD | PP-0045 | SILICA GEL PACKET | TBD | N/A | Generic |  |  | $0.000 | $0.050 | $0.050
 |  |  |  |  |  |  |  |  |  |  | $0.000
 |  |  |  |  |  |  |  |  |  |  | $0.000
 |  |  |  |  |  |  |  |  |  |  | $0.000
 |  |  |  |  |  |  |  |  |  |  | $0.000
 |  |  |  |  |  |  |  |  |  |  | $0.000
 |  |  |  |  |  |  |  |  |  |  | $0.000
 |  |  |  |  |  |  |  |  |  |  | $0.000
 |  |  |  |  |  |  |  |  |  |  | $0.000
 |  |  |  |  |  |  |  |  |  |  | $0.000
 |  |  |  |  |  |  |  |  |  |  | $0.000
 |  |  |  |  |  |  |  |  |  |  | $0.000
 |  |  |  |  |  |  |  |  |  |  | $0.000
 |  |  |  |  |  |  |  |  |  |  | $0.000
 |  |  |  |  |  |  |  |  |  |  | $0.000
 |  |  |  |  |  |  |  |  |  |  | $0.000
 |  |  |  |  |  |  |  |  |  |  | $0.000
 |  |  |  |  |  |  |  |  |  |  | $0.000
 |  |  |  |  |  |  |  |  |  |  | $0.000
 |  |  |  |  |  |  |  |  |  |  | $0.000
 |  |  |  |  |  |  |  |  |  |  | $0.000
 |  |  |  |  |  |  |  |  |  |  | $0.000
 |  |  |  |  |  |  |  |  |  |  | $0.000
 |  |  |  |  |  |  |  |  |  |  | $0.000
 |  |  |  |  |  |  |  |  |  |  | $0.000
 |  |  |  |  |  |  |  |  |  |  | $0.000
 |  |  |  |  |  |  |  |  |  |  | $0.000
 |  |  |  |  |  |  |  |  |  |  | $0.000
 |  |  |  |  |  |  |  |  |  |  | $0.000
 |  |  |  |  |  |  |  |  |  |  | $0.000
 |  |  |  |  |  |  |  |  |  |  | $0.000
 |  |  |  |  |  |  |  |  |  |  | $0.000
 |  |  |  |  |  |  |  |  |  |  | $0.000
 |  |  |  |  |  |  |  |  |  |  | $0.000
 |  |  |  |  |  |  |  |  |  |  | $0.000
 |  |  |  |  |  |  |  |  |  |  | $0.000
 |  |  |  |  |  |  |  |  |  |  | $0.000
 |  |  |  |  |  |  |  |  |  |  | $0.000
 |  |  |  |  |  |  |  |  |  |  | $0.000
 |  |  |  |  |  |  |  |  |  |  | $0.000
 |  |  |  |  |  |  |  |  |  |  | $0.000
 |  |  |  |  |  |  |  |  |  |  | $0.000
 |  |  |  |  |  |  |  |  |  |  | $0.000
 |  |  |  |  |  |  |  |  |  |  | $0.000
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
 |  |  |  |  |  |  |  |  |  |  | $0.000
 |  |  |  |  |  |  |  |  |  |  | $0.000
 |  |  |  |  |  |  |  |  |  |  | $0.000
 |  |  |  |  |  |  |  |  |  |  | $0.000
 |  |  |  |  |  |  |  |  |  |  | $0.000
 |  |  |  |  |  |  |  |  |  |  | $0.000
 |  |  |  |  |  |  |  |  |  |  | $0.000

Sheet: Fabricated Parts
Detailed list of the custom fabricated parts in your product such as molded, stamped, diecast, etc.
Quantity | Part Number | Part Name | Description | Process Type | Material Type | Material Finish | Material Additives | Other Details | Bounding Width (mm) | Bounding Length (mm) | Bounding Height (mm) | Volume (cm^3) | Lead Time (wk) | MOQ | Fixed Cost (USD) | Unit Cost (USD) | Ext. Cost (USD) | Notes
1 | MH_001 | FP-0001 | F1 HULL | Injection Molding | Polycarbonate | Satin |  | White |  |  |  |  | 8 | 600 |  | $6.600 | $6.600
1 | FW_001 | FP-0002 | FRONT CAP | Injection Molding | Polycarbonate | Optical/Satin |  | Clear |  |  |  |  | 8 | 600 |  | $3.000 | $3.000
3 | TS_001 | FP-0003 | THRUSTER HOUSING | Injection Molding | Polycarbonate | Satin |  | White |  |  |  |  | 8 | 1800 |  | $3.250 | $9.750
1 | PR_001 | FP-0004 | PROP (R) | Injection Molding | Polycarbonate | Matte |  | Black |  |  |  |  | 8 | 600 |  | $1.400 | $1.400
2 | PL-T_001 | FP-0005 | PROP (L/T) | Injection Molding | Polycarbonate | Matte |  | Black |  |  |  |  | 8 | 1200 |  | $1.400 | $2.800
1 | BS_001 | FP-0006 | WIRELESS TRANSMITTER TOP | Injection Molding | Polycarbonate | Satin |  | White |  |  |  |  | 8 | 600 |  | $3.000 | $3.000
2 | BC_001 | FP-0007 | WIRELESS TRANSMITTER BOTTOM | Injection Molding | Polycarbonate | Satin |  | White |  |  |  |  | 8 | 600 |  | $2.900 | $5.800
1 | FC_001 | FP-0008 | CAMERA MOUNT | Injection Molding | ABS | Matte |  | Black |  |  |  |  | 8 | 600 |  | $2.500 | $2.500
1 | CPU_MOUNT | FP-0009 | CPU MOUNT | Sheet Cutting | Plastic | N/A |  | N/A |  |  |  |  | 8 | 600 |  | $3.000 | $3.000
1 | PIC_RAIL | FP-0010 | PICATINNY RAIL | Injection Molding | Polycarbonate | Satin |  | White |  |  |  |  | 8 | 600 |  | $1.500 | $1.500
 |  |  |  |  |  |  |  |  |  |  |  |  |  |  |  |  | $0.000
 |  |  |  |  |  |  |  |  |  |  |  |  |  |  |  |  | $0.000
 |  |  |  |  |  |  |  |  |  |  |  |  |  |  |  |  | $0.000
 |  |  |  |  |  |  |  |  |  |  |  |  |  |  |  |  | $0.000
 |  |  |  |  |  |  |  |  |  |  |  |  |  |  |  |  | $0.000
 |  |  |  |  |  |  |  |  |  |  |  |  |  |  |  |  | $0.000
 |  |  |  |  |  |  |  |  |  |  |  |  |  |  |  |  | $0.000
 |  |  |  |  |  |  |  |  |  |  |  |  |  |  |  |  | $0.000
 |  |  |  |  |  |  |  |  |  |  |  |  |  |  |  |  | $0.000
 |  |  |  |  |  |  |  |  |  |  |  |  |  |  |  |  | $0.000
 |  |  |  |  |  |  |  |  |  |  |  |  |  |  |  |  | $0.000
 |  |  |  |  |  |  |  |  |  |  |  |  |  |  |  |  | $0.000
 |  |  |  |  |  |  |  |  |  |  |  |  |  |  |  |  | $0.000
 |  |  |  |  |  |  |  |  |  |  |  |  |  |  |  |  | $0.000
 |  |  |  |  |  |  |  |  |  |  |  |  |  |  |  |  | $0.000
 |  |  |  |  |  |  |  |  |  |  |  |  |  |  |  |  | $0.000
 |  |  |  |  |  |  |  |  |  |  |  |  |  |  |  |  | $0.000
 |  |  |  |  |  |  |  |  |  |  |  |  |  |  |  |  | $0.000
 |  |  |  |  |  |  |  |  |  |  |  |  |  |  |  |  | $0.000
 |  |  |  |  |  |  |  |  |  |  |  |  |  |  |  |  | $0.000
 |  |  |  |  |  |  |  |  |  |  |  |  |  |  |  |  | $0.000
 |  |  |  |  |  |  |  |  |  |  |  |  |  |  |  |  | $0.000
 |  |  |  |  |  |  |  |  |  |  |  |  |  |  |  |  | $0.000
 |  |  |  |  |  |  |  |  |  |  |  |  |  |  |  |  | $0.000
 |  |  |  |  |  |  |  |  |  |  |  |  |  |  |  |  | $0.000
 |  |  |  |  |  |  |  |  |  |  |  |  |  |  |  |  | $0.000
 |  |  |  |  |  |  |  |  |  |  |  |  |  |  |  |  | $0.000
 |  |  |  |  |  |  |  |  |  |  |  |  |  |  |  |  | $0.000
 |  |  |  |  |  |  |  |  |  |  |  |  |  |  |  |  | $0.000
 |  |  |  |  |  |  |  |  |  |  |  |  |  |  |  |  | $0.000
 |  |  |  |  |  |  |  |  |  |  |  |  |  |  |  |  | $0.000
 |  |  |  |  |  |  |  |  |  |  |  |  |  |  |  |  | $0.000
 |  |  |  |  |  |  |  |  |  |  |  |  |  |  |  |  | $0.000
 |  |  |  |  |  |  |  |  |  |  |  |  |  |  |  |  | $0.000
 |  |  |  |  |  |  |  |  |  |  |  |  |  |  |  |  | $0.000
 |  |  |  |  |  |  |  |  |  |  |  |  |  |  |  |  | $0.000
 |  |  |  |  |  |  |  |  |  |  |  |  |  |  |  |  | $0.000
 |  |  |  |  |  |  |  |  |  |  |  |  |  |  |  |  | $0.000
 |  |  |  |  |  |  |  |  |  |  |  |  |  |  |  |  | $0.000
 |  |  |  |  |  |  |  |  |  |  |  |  |  |  |  |  | $0.000
 |  |  |  |  |  |  |  |  |  |  |  |  |  |  |  |  | $0.000
 |  |  |  |  |  |  |  |  |  |  |  |  |  |  |  |  | $0.000
 |  |  |  |  |  |  |  |  |  |  |  |  |  |  |  |  | $0.000
 |  |  |  |  |  |  |  |  |  |  |  |  |  |  |  |  | $0.000
 |  |  |  |  |  |  |  |  |  |  |  |  |  |  |  |  | $0.000
 |  |  |  |  |  |  |  |  |  |  |  |  |  |  |  |  | $0.000
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
 |  |  |  |  |  |  |  |  |  |  |  |  |  |  |  |  | $0.000
 |  |  |  |  |  |  |  |  |  |  |  |  |  |  |  |  | $0.000
 |  |  |  |  |  |  |  |  |  |  |  |  |  |  |  |  | $0.000
 |  |  |  |  |  |  |  |  |  |  |  |  |  |  |  |  | $0.000
 |  |  |  |  |  |  |  |  |  |  |  |  |  |  |  |  | $0.000

Sheet: PCBA Components
Detailed list of components that are either machine placed/mounted or through-hole soldered onto the PCB.
Quantity | Part Number | Part Name | Description | PCB Number | Manufacturer | MPN | Procurement Method | Lead Time (wk) | MOQ | Fixed Cost (USD) | Unit Cost (USD) | Ext. Cost (USD) | Notes
1 | C10 |  | CAP CER 10PF 50V C0G/NP0 0603 | PCBA-0001 | Murata Electronics North America | GCM1885C1H100JA16D | Assigned |  |  | $0.000 | $0.000 | $0.000
1 | C9 |  | CAP CER 470PF 50V X7R 0603 | PCBA-0001 | Murata Electronics North America | GRM188R71H471KA01D | Assigned |  |  | $0.000 | $0.000 | $0.000
2 | C7,C25 |  | CAP CER 10000PF 50V X7R 0402 | PCBA-0001 | Murata Electronics North America | GRM155R71H103KA88D | Assigned |  |  | $0.000 | $0.000 | $0.000
7 | C2,C21,C24,C27-C30 |  | CAP CER 0.1UF 50V X7R 0402 | PCBA-0001 | Murata Electronics North America | GRM155R71H104KE14J | Assigned |  |  | $0.000 | $0.000 | $0.000
2 | C4,C8 |  | CAP CER 0.47UF 16V X7R 0603 | PCBA-0001 | Murata Electronics North America | GCM188R71C474KA55D | Assigned |  |  | $0.000 | $0.000 | $0.000
10 | C12,C13,C15-C19,C23,C46,C47 |  | CAP CER 1UF 10V X5R 0402 | PCBA-0001 | Murata Electronics North America | GRM155R61A105ME01D | Assigned |  |  | $0.000 | $0.000 | $0.000
2 | C1,C3 |  | CAP CER 2.2UF 25V X5R 0603 | PCBA-0001 | Murata Electronics North America | GRM188R61E225MA12D | Assigned |  |  | $0.000 | $0.000 | $0.000
3 | C5,C11,C26 |  | CAP CER 10UF 10V X5R 0805 | PCBA-0001 | Murata Electronics North America | GRM21BR61A106ME19L | Assigned |  |  | $0.000 | $0.000 | $0.000
2 | C6,C22 |  | CAP CER 10UF 50V X5R 1206 | PCBA-0001 | Taiyo Yuden | UMK316BBJ106ML-T | Assigned |  |  | $0.000 | $0.000 | $0.000
1 | C20 |  | CAP ALUM POLY 150UF 20% 6.3V SMD | PCBA-0001 | United Chemi-Con | APXF6R3ARA151ME61G | Assigned |  |  | $0.000 | $0.000 | $0.000
1 | C14 |  | CAP ALUM 470UF 20% 25V RADIAL | PCBA-0001 | United Chemi-Con | EKY-250ELL471MH20D | Assigned |  |  | $0.000 | $0.000 | $0.000
1 | D1 |  | DIODE ZENER 12V 225MW SOT23-3 | PCBA-0001 | ON Semiconductor | BZX84C12LT1G | Assigned |  |  | $0.000 | $0.000 | $0.000
3 | D2,D3,D6 |  | DIODE SCHOTTKY 40V 3A SMA | PCBA-0001 | Diodes Incorporated | B340A-13-F | Assigned |  |  | $0.000 | $0.000 | $0.000
1 | D8 |  | TVS DIODE 15VWM 24.4VC SOD123F | PCBA-0001 | Littelfuse Inc. | SMF15A | Assigned |  |  | $0.000 | $0.000 | $0.000
1 | D5 |  | TVS DIODE 18VWM 29.2VC SMC | PCBA-0001 | Littelfuse Inc. | SMCJ18A | Assigned |  |  | $0.000 | $0.000 | $0.000
1 | D4 |  | DIODE GEN PURP 100V 150MA SOD123 | PCBA-0001 | Diodes Incorporated | BAV16W-7-F | Assigned |  |  | $0.000 | $0.000 | $0.000
1 | F1 |  | PTC RESETTABLE 30V 500MA 1812 | PCBA-0001 | Bel Fuse Inc. | 0ZCG0050AF2C | Assigned |  |  | $0.000 | $0.000 | $0.000
1 | IC1 |  | IC LED DRVR RGLTR DIM 1A 16TSSOP | PCBA-0001 | Linear Technology | LT3474EFE#PBF | Assigned |  |  | $0.000 | $0.000 | $0.000
1 | IC2 |  | IC REG BUCK ADJ 5A 16-MSOP | PCBA-0001 | Linear Technology | LT3976EMSE#PBF | Assigned |  |  | $0.000 | $0.000 | $0.000
1 | IC3 |  | IC ADC 12BIT I2C 3.3KSPS 10MSOP | PCBA-0001 | Texas Instruments | ADS1015IDGSR | Assigned |  |  | $0.000 | $0.000 | $0.000
1 | IC16 |  | IC LVL XLTR LV 8MBPS SOT23-8 | PCBA-0001 | Maxim Integrated | MAX3373EEKA+T | Assigned |  |  | $0.000 | $0.000 | $0.000
1 | J1 |  | TERM BLOCK 6POS SIDE ENT 5.08MM | PCBA-0001 | TE Connectivity AMP Connectors | 282857-6 | Assigned |  |  | $0.000 | $0.000 | $0.000
2 | J2,J7 |  | CONN TERM BLOCK 2.54MM 2POS PCB | PCBA-0001 | On Shore Technology Inc. | OSTVN02A150 | Assigned |  |  | $0.000 | $0.000 | $0.000
1 | J5 |  | CONN TERM BLOCK 2.54MM 3POS PCB | PCBA-0001 | On Shore Technology Inc. | OSTVN03A150 | Assigned |  |  | $0.000 | $0.000 | $0.000
2 | J3,J6 |  | CONN TERM BLOCK 2.54MM 4POS PCB | PCBA-0001 | On Shore Technology Inc. | OSTVN04A150 | Assigned |  |  | $0.000 | $0.000 | $0.000
1 | J4 |  | CONN TERM BLOCK 2.54MM 6POS PCB | PCBA-0001 | On Shore Technology Inc. | OSTVN06A150 | Assigned |  |  | $0.000 | $0.000 | $0.000
1 | L1 |  | FIXED IND 6.8UH 1.45A 98 MOHM | PCBA-0001 | Bourns Inc. | SRN4018TA-6R8M | Assigned |  |  | $0.000 | $0.000 | $0.000
1 | L2 |  | FIXED IND 2.2UH 7.4A 11.5 MOHM | PCBA-0001 | Bourns Inc. | SRN8040TA-2R2Y | Assigned |  |  | $0.000 | $0.000 | $0.000
1 | Q1 |  | MOSFET N-CH 40V 120A TO263-3-2 | PCBA-0001 | Infineon Technologies | IPB120N04S402ATMA1 | Assigned |  |  | $0.000 | $0.000 | $0.000
1 | R4 |  | RES SMD 0.0 OHM JUMPER 1/8W 0805 | PCBA-0001 | Yageo | RC0805FR-070RL | Assigned |  |  | $0.000 | $0.000 | $0.000
1 | R10 |  | RES SMD 2.2 OHM 1% 1/10W 0603 | PCBA-0001 | Yageo | RC0603FR-072R2L | Assigned |  |  | $0.000 | $0.000 | $0.000
3 | R22-R24 |  | RES SMD 100 OHM 1% 1/10W 0603 | PCBA-0001 | Yageo | RC0603FR-07100RL | Assigned |  |  | $0.000 | $0.000 | $0.000
7 | R18,R25-R29,R31 |  | RES SMD 300 OHM 1% 1/16W 0402 | PCBA-0001 | Yageo | RC0402FR-07300RL | Assigned |  |  | $0.000 | $0.000 | $0.000
2 | R2,R3 |  | RES SMD 2.2K OHM 1% 1/10W 0603 | PCBA-0001 | Yageo | RC0603FR-072K2L | Assigned |  |  | $0.000 | $0.000 | $0.000
7 | R13-R16,R20,R65,R66 |  | RES SMD 3.3K OHM 1% 1/16W 0402 | PCBA-0001 | Yageo | RC0402FR-073K3L | Assigned |  |  | $0.000 | $0.000 | $0.000
6 | R1,R17,R19,R21,R30,R51 |  | RES SMD 10K OHM 1% 1/10W 0603 | PCBA-0001 | Yageo | RC0603FR-0710KL | Assigned |  |  | $0.000 | $0.000 | $0.000
1 | R9 |  | RES SMD 14.7K OHM 1% 1/10W 0603 | PCBA-0001 | Yageo | RC0603FR-0714K7L | Assigned |  |  | $0.000 | $0.000 | $0.000
2 | R6,R7 |  | RES SMD 33K OHM 1% 1/10W 0603 | PCBA-0001 | Yageo | RC0603FR-0733KL | Assigned |  |  | $0.000 | $0.000 | $0.000
1 | R8 |  | RES SMD 100K OHM 1% 1/10W 0603 | PCBA-0001 | Yageo | RC0603FR-07100KL | Assigned |  |  | $0.000 | $0.000 | $0.000
1 | R12 |  | RES SMD 316K OHM 1% 1/10W 0603 | PCBA-0001 | Yageo | RC0603FR-07316KL | Assigned |  |  | $0.000 | $0.000 | $0.000
1 | R5 |  | RES SMD 470K OHM 1% 1/10W 0603 | PCBA-0001 | Yageo | RC0603FR-07470KL | Assigned |  |  | $0.000 | $0.000 | $0.000
1 | R11 |  | RES SMD 1M OHM 1% 1/10W 0603 | PCBA-0001 | Yageo | RC0603FR-071ML | Assigned |  |  | $0.000 | $0.000 | $0.000
1 | T1 |  | MOSFET N-CH 60V 0.115A SOT-23 | PCBA-0001 | ON Semiconductor | 2N7002LT1G | Assigned |  |  | $0.000 | $0.000 | $0.000
1 | U1 |  | IC LED DRIVER RGBA 28-TSSOP | PCBA-0001 | NXP USA Inc. | PCA9685PW,118 | Assigned |  |  | $0.000 | $0.000 | $0.000
1 | U6 |  | IMU ACCEL/GYRO/MAG | PCBA-0001 | STMicroelectronics | LSM9DS1TR | Assigned |  |  | $0.000 | $0.000 | $0.000
3 | X1-X3 |  | FERRITE BEAD 120 OHM 0603 1LN | PCBA-0001 | Murata Electronics North America | BLM18PG121SN1D | Assigned |  |  | $0.000 | $0.000 | $0.000
1 | PI |  | CONN HEADR FMALE 40POS .1" DL AU | PCBA-0001 | Sullins Connector Solutions | PPPC202LFBN-RC | Assigned |  |  | $0.000 | $0.000 | $0.000
1 | XT60 |  | XT60 POWER CONNECTOR | PCBA-0001 | Hextronik Ltd |  | Generic |  |  | $0.000 | $0.500 | $0.500
1 | WIRE |  | 5'' 14 AWG SILICONE BATTERY WIRE | PCBA-0001 | TBD |  | Generic |  |  | $0.000 | $0.200 | $0.200
 |  |  |  |  |  |  |  |  |  |  |  | $0.000
 |  |  |  |  |  |  |  |  |  |  |  | $0.000
 |  |  |  |  |  |  |  |  |  |  |  | $0.000
 |  |  |  |  |  |  |  |  |  |  |  | $0.000
 |  |  |  |  |  |  |  |  |  |  |  | $0.000
 |  |  |  |  |  |  |  |  |  |  |  | $0.000
 |  |  |  |  |  |  |  |  |  |  |  | $0.000
 |  |  |  |  |  |  |  |  |  |  |  | $0.000
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
 |  |  |  |  |  |  |  |  |  |  |  | $0.000
 |  |  |  |  |  |  |  |  |  |  |  | $0.000
 |  |  |  |  |  |  |  |  |  |  |  | $0.000
 |  |  |  |  |  |  |  |  |  |  |  | $0.000
 |  |  |  |  |  |  |  |  |  |  |  | $0.000
 |  |  |  |  |  |  |  |  |  |  |  | $0.000
 |  |  |  |  |  |  |  |  |  |  |  | $0.000
 |  |  |  |  |  |  |  |  |  |  |  | $0.000
 |  |  |  |  |  |  |  |  |  |  |  | $0.000
 |  |  |  |  |  |  |  |  |  |  |  | $0.000
 |  |  |  |  |  |  |  |  |  |  |  | $0.000
 |  |  |  |  |  |  |  |  |  |  |  | $0.000
 |  |  |  |  |  |  |  |  |  |  |  | $0.000
 |  |  |  |  |  |  |  |  |  |  |  | $0.000
 |  |  |  |  |  |  |  |  |  |  |  | $0.000
 |  |  |  |  |  |  |  |  |  |  |  | $0.000
 |  |  |  |  |  |  |  |  |  |  |  | $0.000
 |  |  |  |  |  |  |  |  |  |  |  | $0.000
 |  |  |  |  |  |  |  |  |  |  |  | $0.000
 |  |  |  |  |  |  |  |  |  |  |  | $0.000
 |  |  |  |  |  |  |  |  |  |  |  | $0.000
 |  |  |  |  |  |  |  |  |  |  |  | $0.000
 |  |  |  |  |  |  |  |  |  |  |  | $0.000
 |  |  |  |  |  |  |  |  |  |  |  | $0.000
 |  |  |  |  |  |  |  |  |  |  |  | $0.000
 |  |  |  |  |  |  |  |  |  |  |  | $0.000
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
