identitymonk/Fathom-Drone-Archive/Electronics/PCBA/Fathom PCBA.sldasm

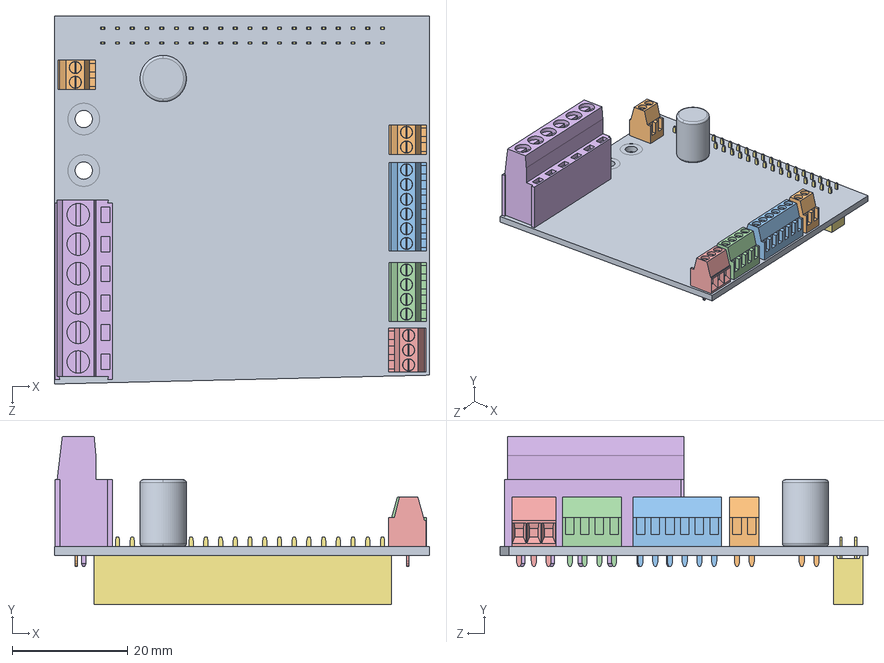
[picture p103: CAD file, 2019-07-11]
Electronics/PCBA/Fathom PCBA.sldasm
64.8 x 29.1 x 63.5 mm
Copy of PCB^Fathom PCBA
Copy of OSTVN2A150^Fathom PCBA x 2
Copy of OSTVN6A150^Fathom PCBA
Copy of OSTVN4A150^Fathom PCBA
Copy of OSTVN3A150^Fathom PCBA
Copy of c-282857-6-f-3d^Fathom PCBA
Copy of C202LFBN-RC^Fathom PCBA
