identitymonk/Fathom-Drone-Archive/CAD Files/Drone Related/Face.Assembly/electronics/RasPi_Camera.SLDASM

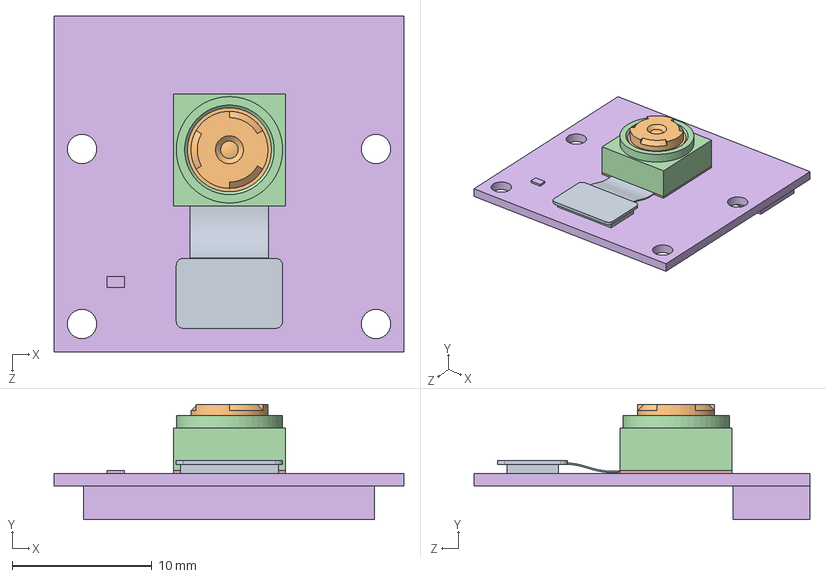
[picture p104: CAD file, 2019-07-11]
CAD Files/Drone Related/Face.Assembly/electronics/RasPi_Camera.SLDASM
25.0 x 8.25 x 24.0 mm
Copy of RasPi_Camera_Board_Standard
Copy of OVA5647_Standard
Copy of OVA5647_Housing_Standard
Copy of OVA5647_IR-Glas_Standard
Copy of OVA5647_Lens_FOV
Copy of OVA5647_Pigtail_Standard
