identitymonk/Fathom-Drone-Archive/CAD Files/Drone Related/Topside Transmitter/Topside Transmitter.SLDASM

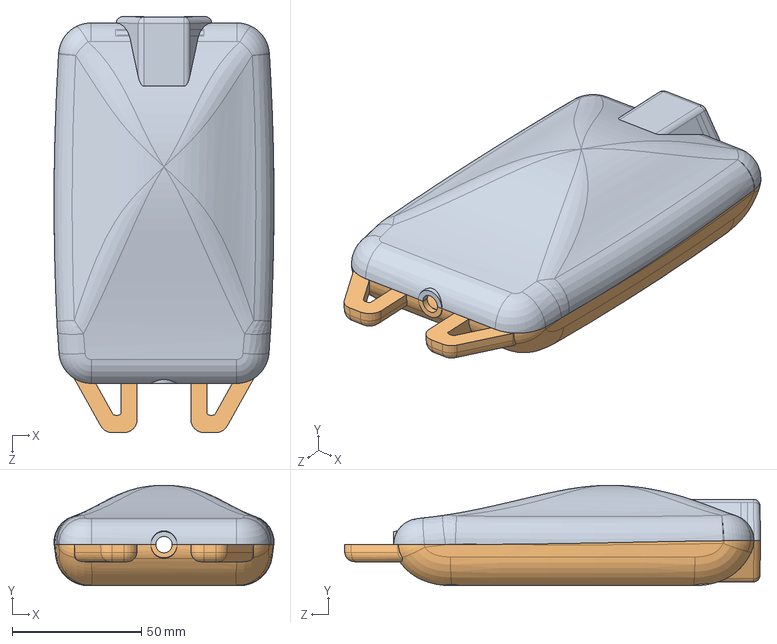
[picture p105: CAD file, 2019-07-11]
CAD Files/Drone Related/Topside Transmitter/Topside Transmitter.SLDASM
85.2 x 38.9 x 161.1 mm
FP-0006
FP-0007
