identitymonk/Fathom-Drone-Archive/CAD Files/Drone Related/Face.Assembly/Face.Assembly.sldasm

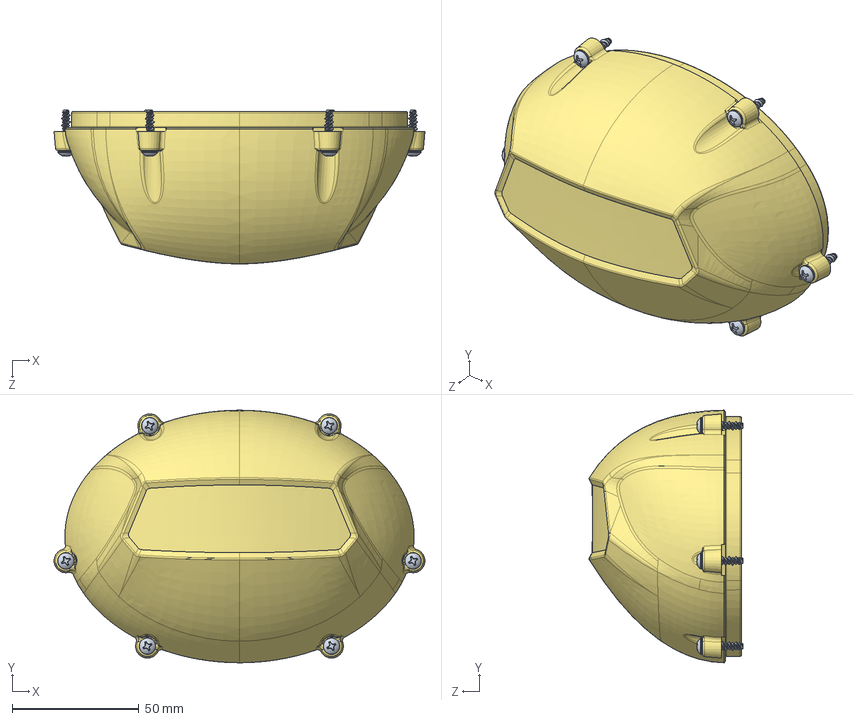
[picture p106: CAD file, 2019-07-11]
CAD Files/Drone Related/Face.Assembly/Face.Assembly.sldasm
146.3 x 99.6 x 60.7 mm
Copy of RasPi_Camera_Board_Standard
Copy of OVA5647_Standard
Copy of OVA5647_Housing_Standard
Copy of OVA5647_IR-Glas_Standard
Copy of OVA5647_Lens_FOV
Copy of OVA5647_Pigtail_Standard
Drone_LED x 2
97975A215_THRD-FORMING 410 SS SCREW FOR BRITTLE PLASTIC x 6
face.bracket
