identitymonk/Fathom-Drone-Archive/CAD Files/Drone Related/Face.Assembly/Copy of OVA5647_FOV.sldasm

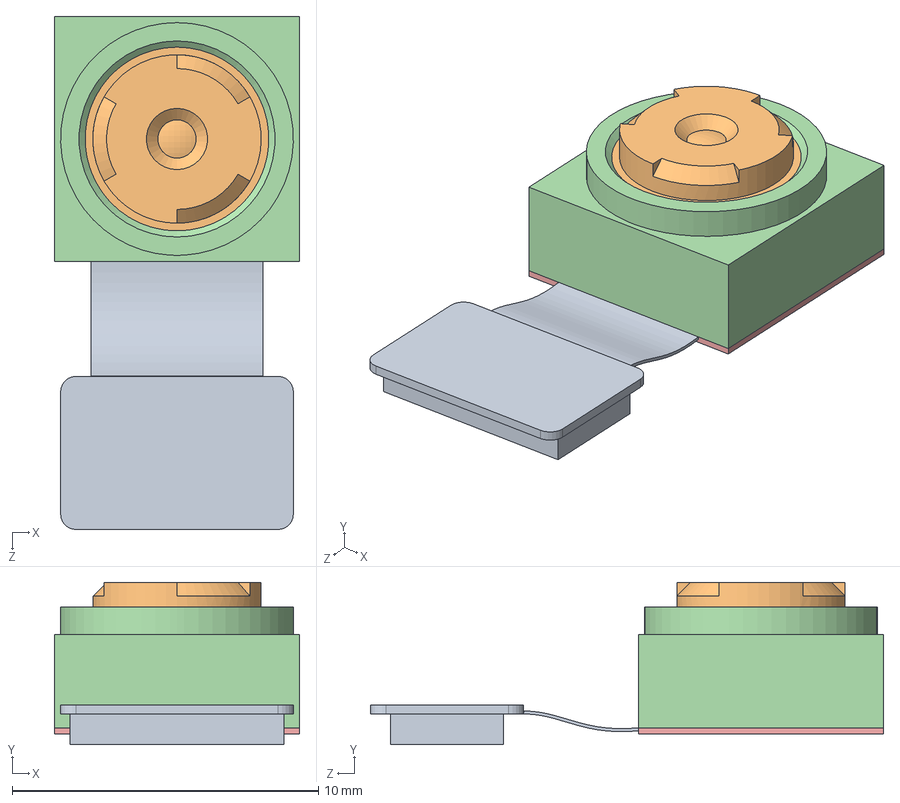
[picture p107: CAD file, 2019-07-11]
CAD Files/Drone Related/Face.Assembly/Copy of OVA5647_FOV.sldasm
8.00 x 5.30 x 16.8 mm
Copy of OVA5647_Standard
Copy of OVA5647_Housing_Standard
Copy of OVA5647_IR-Glas_Standard
Copy of OVA5647_Lens_FOV
Copy of OVA5647_Pigtail_Standard
