identitymonk/Fathom-Drone-Archive/CAD Files/Attachments/ElmoPayload/EPayload2.STL

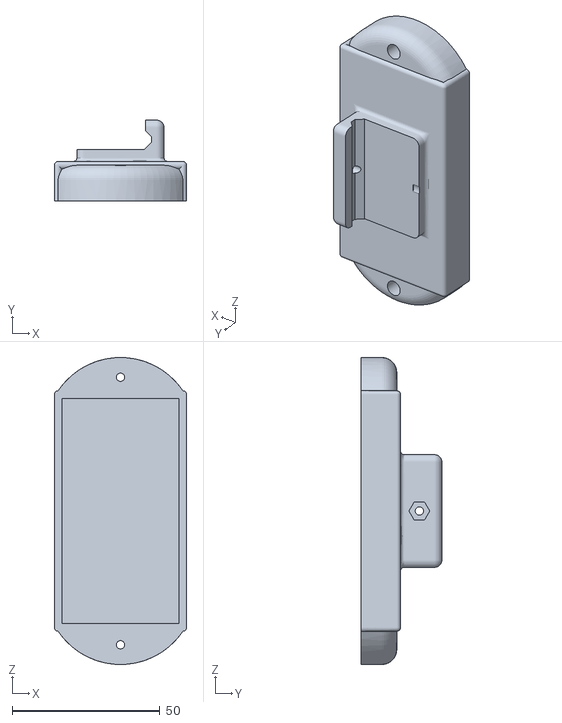
[picture p108: CAD file, 2019-07-11]
CAD Files/Attachments/ElmoPayload/EPayload2.STL
44.7 x 27.3 x 103.7
