identitymonk/Fathom-Drone-Archive/CAD Files/Attachments/Fixtures and Tools/Picatinny Mount.SLDPRT

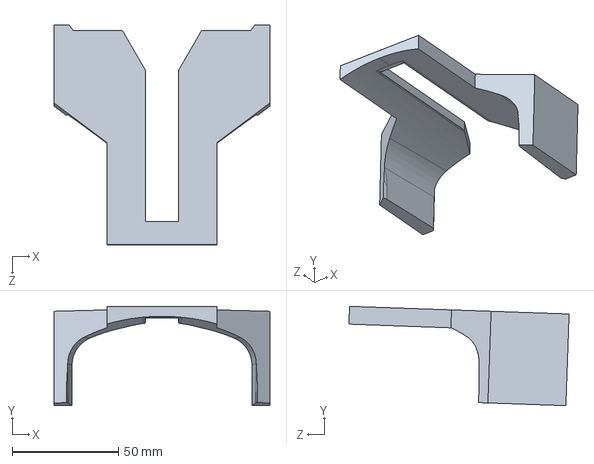
[picture p109: CAD file, 2019-07-11]
CAD Files/Attachments/Fixtures and Tools/Picatinny Mount.SLDPRT
101.7 x 46.8 x 103.7 mm
