identitymonk/Fathom-Drone-Archive/CAD Files/Attachments/LightModule2/LightModule2.STL

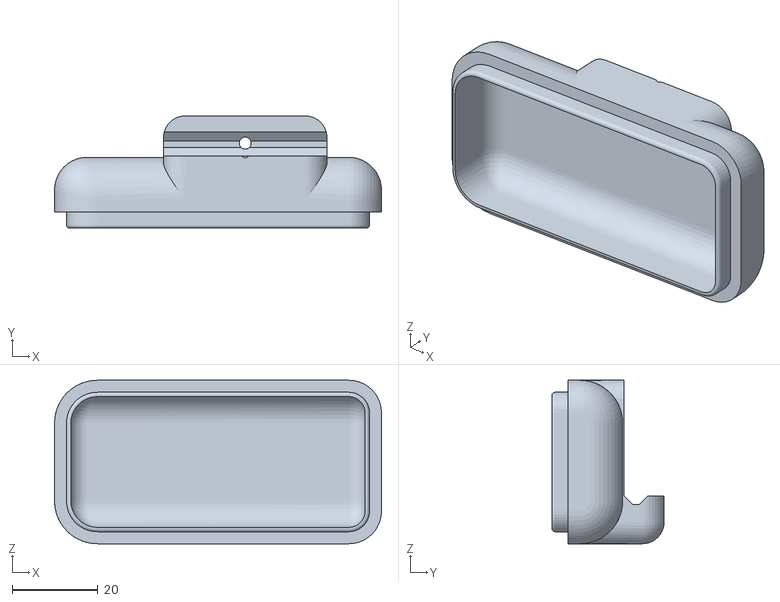
[picture p110: CAD file, 2019-07-11]
CAD Files/Attachments/LightModule2/LightModule2.STL
76.2 x 26.2 x 38.1
