identitymonk/Fathom-Drone-Archive/CAD Files/Attachments/LightModules2.SLDPRT

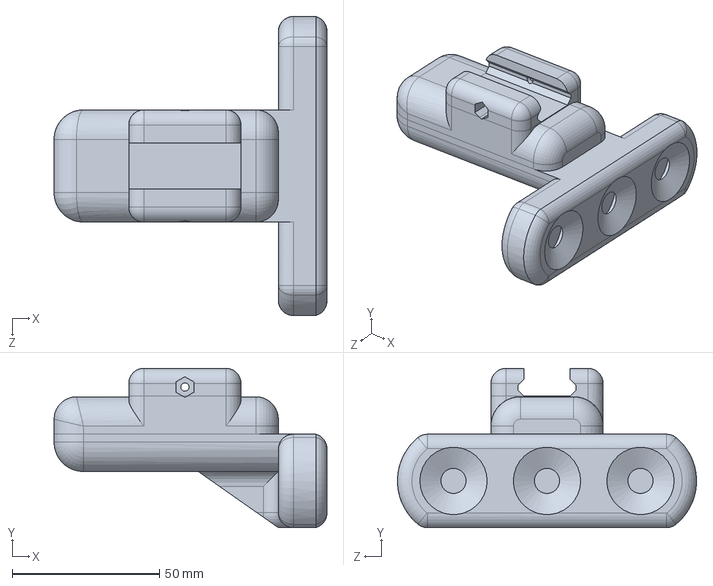
[picture p111: CAD file, 2019-07-11]
CAD Files/Attachments/LightModules2.SLDPRT
92.7 x 54.1 x 101.6 mm
