identitymonk/Fathom-Drone-Archive/CAD Files/Attachments/Trim Weight/SaltBallast2.STL

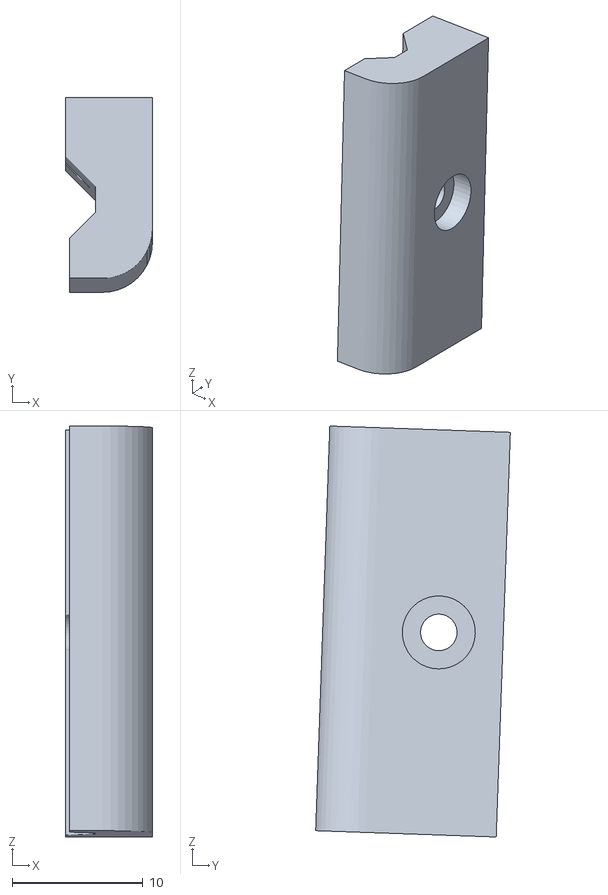
[picture p112: CAD file, 2019-07-11]
CAD Files/Attachments/Trim Weight/SaltBallast2.STL
6.65 x 14.9 x 31.5
