identitymonk/Fathom-Drone-Archive/CAD Files/Drone Related/Drone Documentation/Tether.SLDPRT

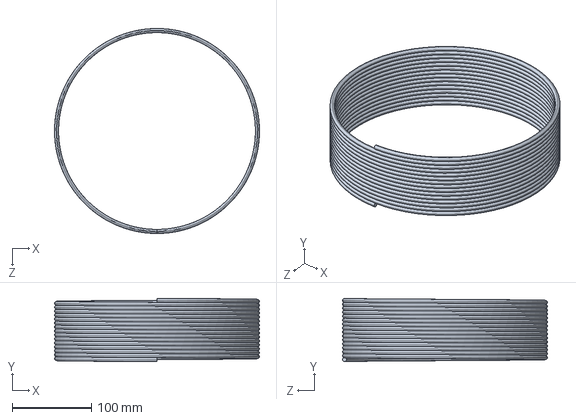
[picture p113: CAD file, 2019-07-11]
CAD Files/Drone Related/Drone Documentation/Tether.SLDPRT
259.1 x 80.1 x 259.1 mm
