identitymonk/Fathom-Drone-Archive/CAD Files/Drone Related/Face.Assembly/Copy of RasPi_Camera_Board_Standard.sldprt

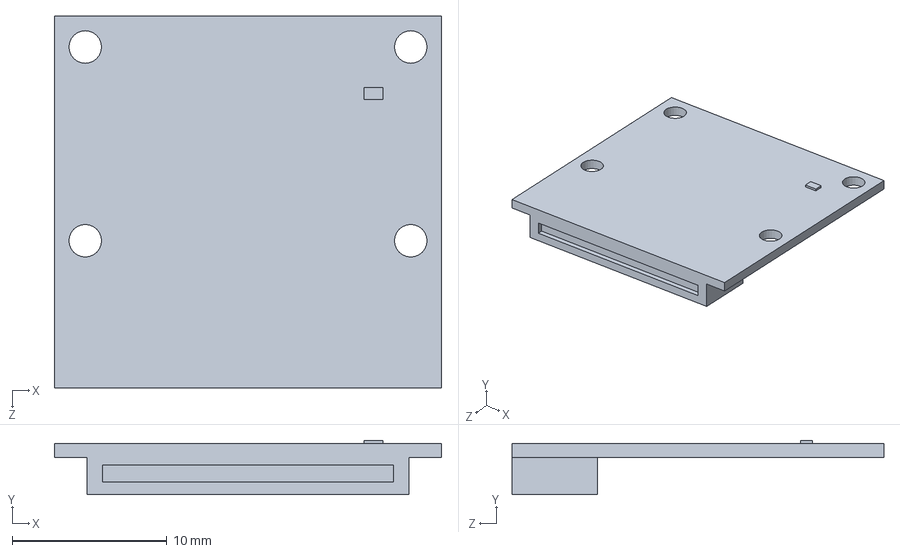
[picture p114: CAD file, 2019-07-11]
CAD Files/Drone Related/Face.Assembly/Copy of RasPi_Camera_Board_Standard.sldprt
25.0 x 3.50 x 24.0 mm
