identitymonk/Fathom-Drone-Archive/CAD Files/Drone Related/Face.Assembly/electronics/Drone_LED.SLDPRT

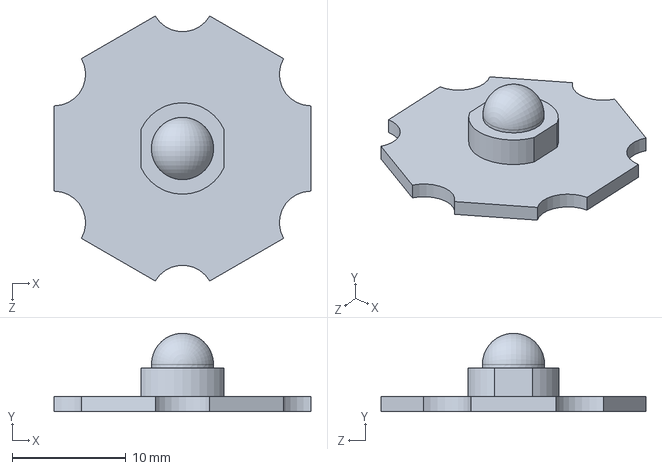
[picture p115: CAD file, 2019-07-11]
CAD Files/Drone Related/Face.Assembly/electronics/Drone_LED.SLDPRT
22.6 x 6.89 x 23.3 mm
