identitymonk/Fathom-Drone-Archive/CAD Files/Drone Related/Printer Files/Prop.001.STL

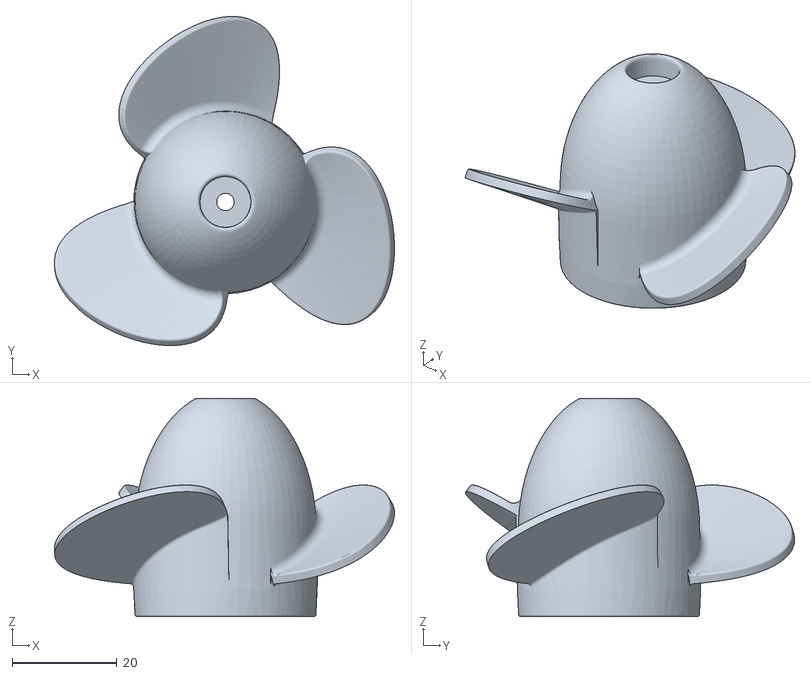
[picture p116: CAD file, 2019-07-11]
CAD Files/Drone Related/Printer Files/Prop.001.STL
65.0 x 62.9 x 41.7
