identitymonk/Fathom-Drone-Archive/CAD Files/Drone Related/Topside Transmitter/FP-0007_TransmitterBottomHalf.STL

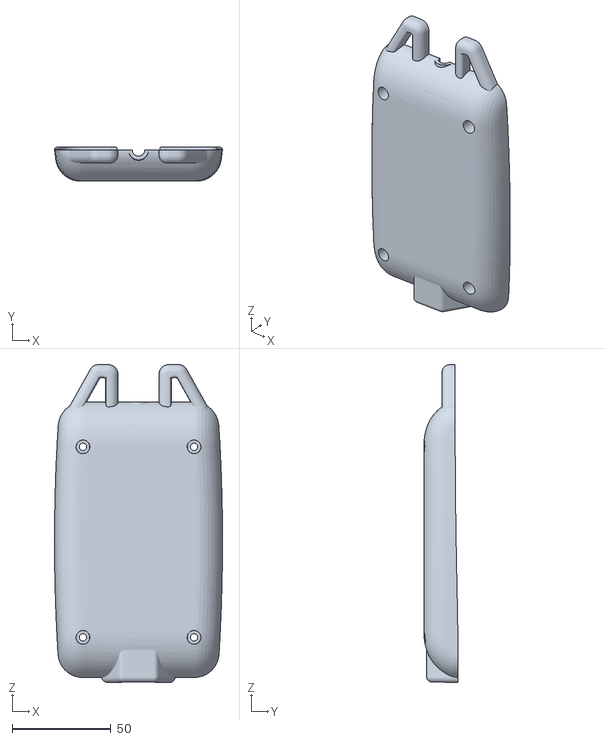
[picture p117: CAD file, 2019-07-11]
CAD Files/Drone Related/Topside Transmitter/FP-0007_TransmitterBottomHalf.STL
85.1 x 17.5 x 161.1
