identitymonk/Fathom-Drone-Archive/CAD Files/Attachments/ElmoPayload/EPayload1.STL

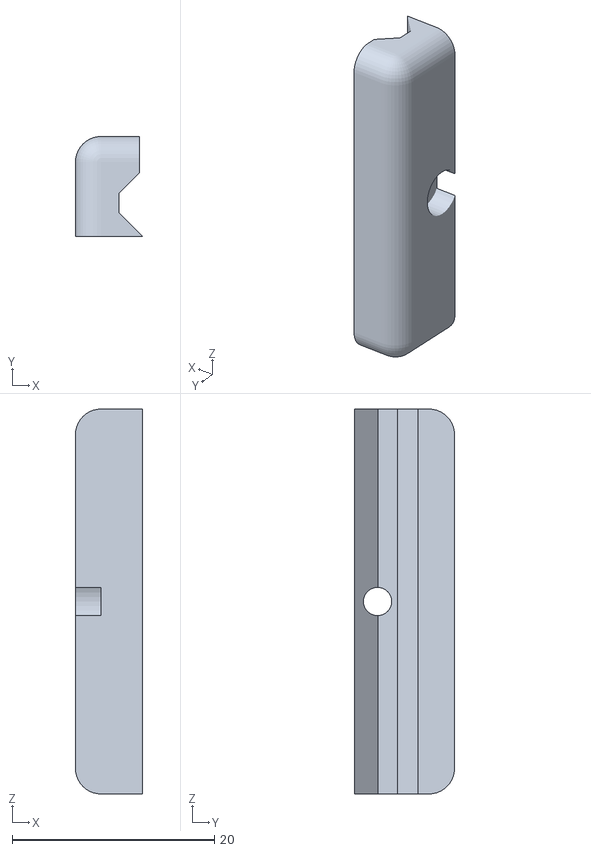
[picture p118: CAD file, 2019-07-11]
CAD Files/Attachments/ElmoPayload/EPayload1.STL
6.65 x 9.91 x 38.1
