identitymonk/Fathom-Drone-Archive/CAD Files/Attachments/Fixtures and Tools/Transducer Wrench.SLDPRT

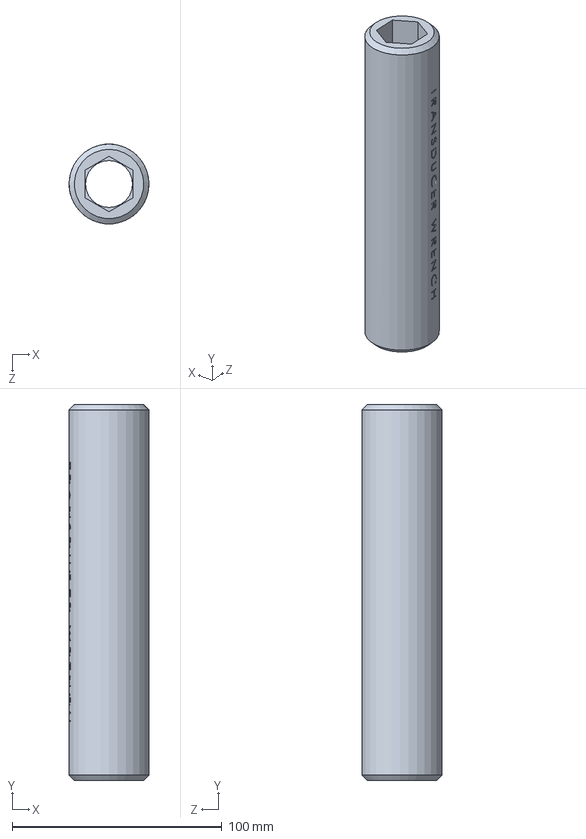
[picture p119: CAD file, 2019-07-11]
CAD Files/Attachments/Fixtures and Tools/Transducer Wrench.SLDPRT
38.1 x 179.1 x 38.1 mm
