identitymonk/Fathom-Drone-Archive/CAD Files/Attachments/GoPro_Streamlined3.STL

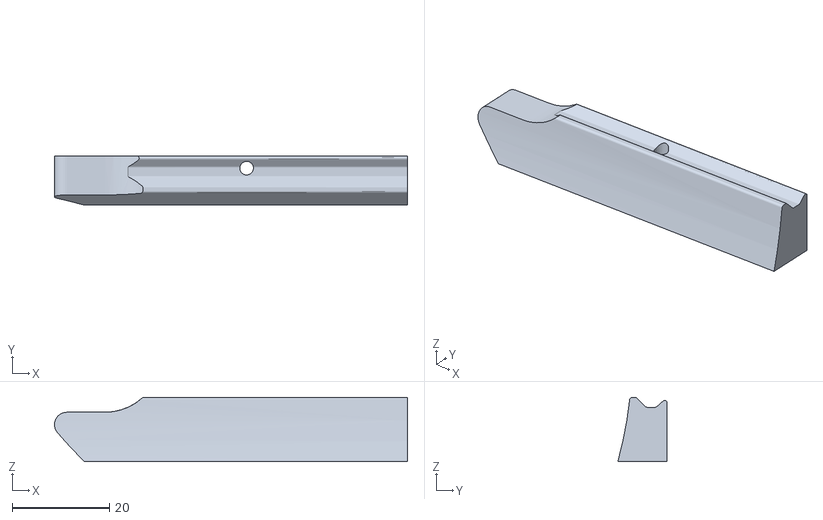
[picture p120: CAD file, 2019-07-11]
CAD Files/Attachments/GoPro_Streamlined3.STL
72.6 x 10.2 x 13.2
