identitymonk/Fathom-Drone-Archive/CAD Files/Attachments/LightModule2/LightModule3.STL

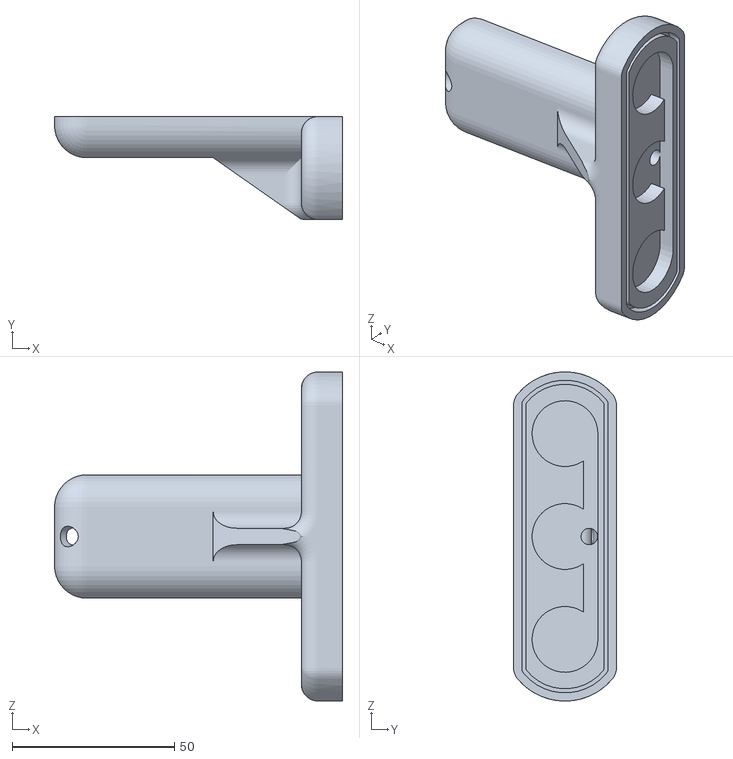
[picture p121: CAD file, 2019-07-11]
CAD Files/Attachments/LightModule2/LightModule3.STL
88.9 x 31.7 x 101.5
