identitymonk/Fathom-Drone-Archive/CAD Files/Attachments/Trim Weight/SaltBallast1.STL

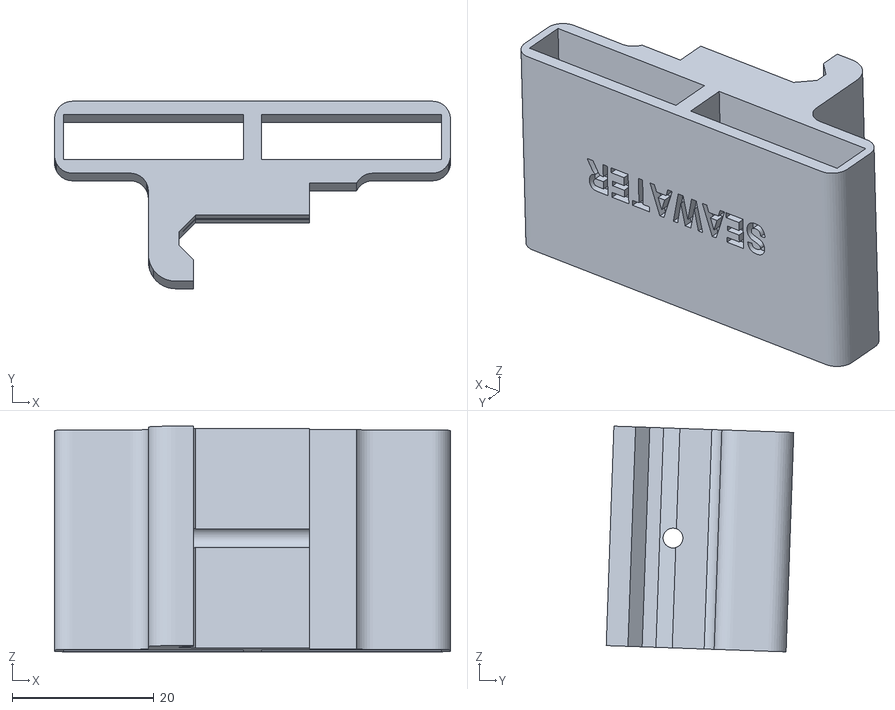
[picture p122: CAD file, 2019-07-11]
CAD Files/Attachments/Trim Weight/SaltBallast1.STL
55.9 x 26.5 x 31.9
