identitymonk/Fathom-Drone-Archive/CAD Files/Drone Related/Drone Documentation/Charger.SLDPRT

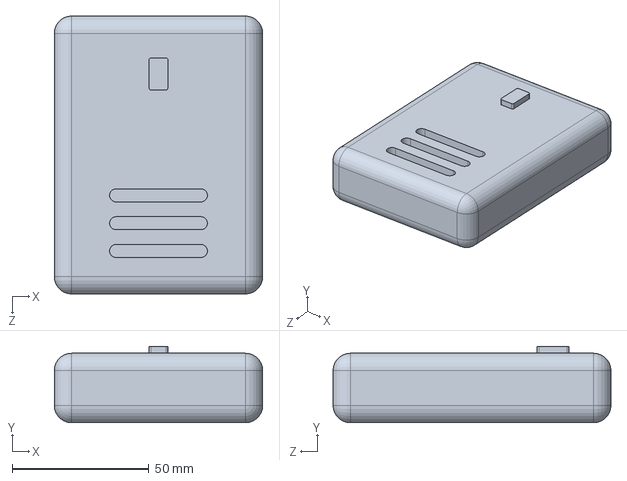
[picture p123: CAD file, 2019-07-11]
CAD Files/Drone Related/Drone Documentation/Charger.SLDPRT
76.2 x 27.9 x 101.6 mm
