identitymonk/Fathom-Drone-Archive/CAD Files/Drone Related/Face.Assembly/face.bracket.sldprt

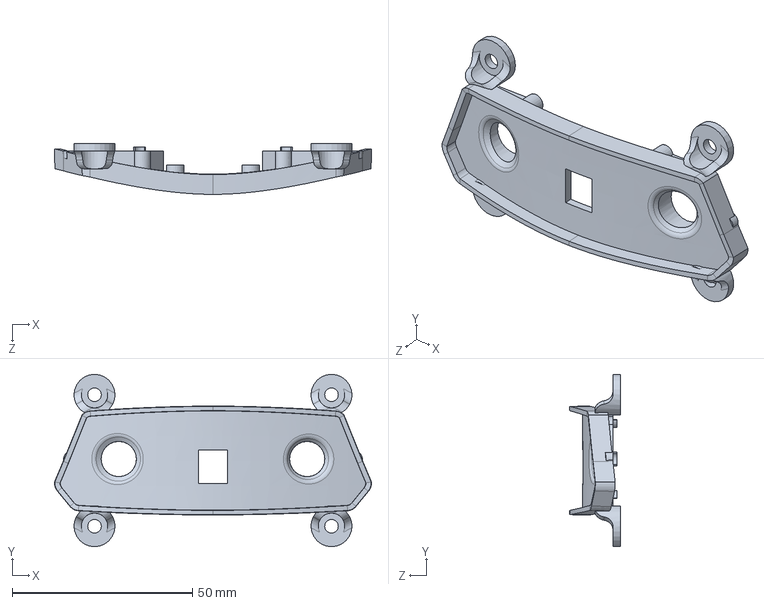
[picture p124: CAD file, 2019-07-11]
CAD Files/Drone Related/Face.Assembly/face.bracket.sldprt
88.0 x 47.9 x 14.1 mm
