identitymonk/Fathom-Drone-Archive/CAD Files/Drone Related/Printer Files/TrimWeight2.STL

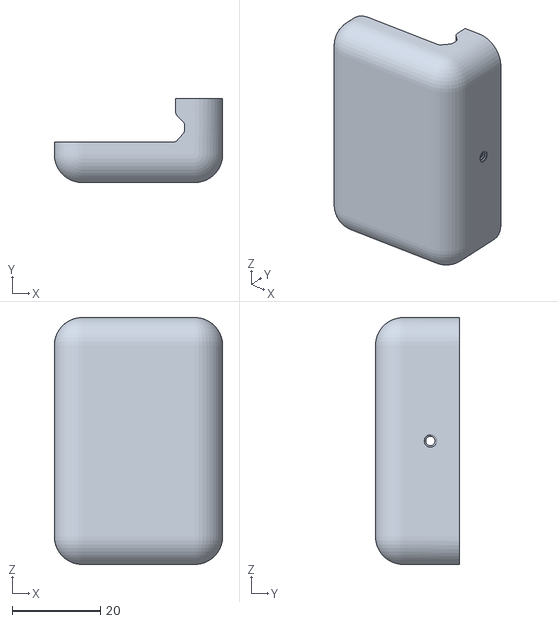
[picture p125: CAD file, 2019-07-11]
CAD Files/Drone Related/Printer Files/TrimWeight2.STL
38.1 x 19.1 x 55.9
