identitymonk/Fathom-Drone-Archive/CAD Files/Drone Related/Thruster.002.SLDPRT

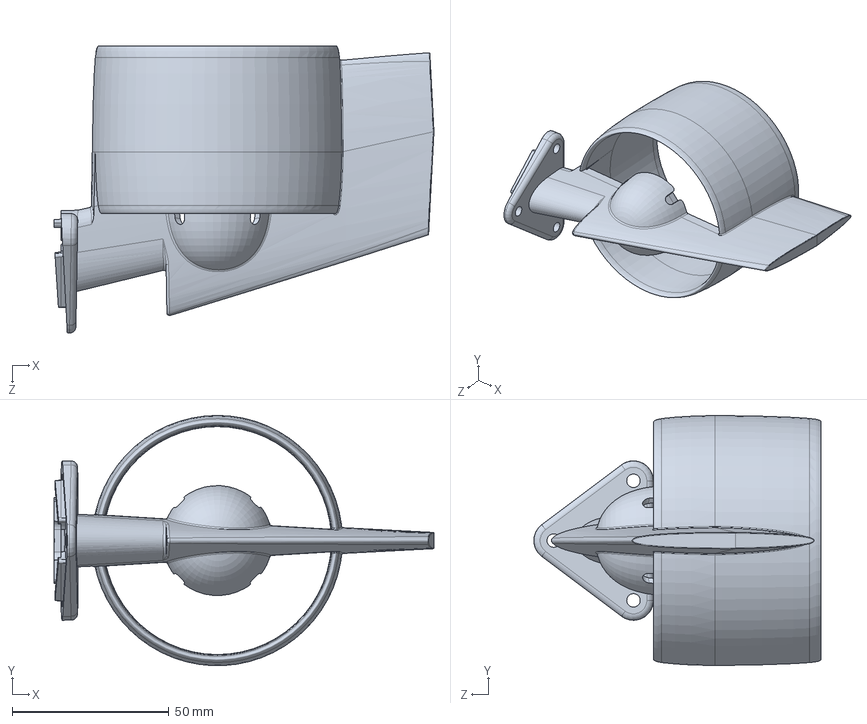
[picture p126: CAD file, 2019-07-11]
CAD Files/Drone Related/Thruster.002.SLDPRT
121.1 x 79.7 x 91.6 mm
