identitymonk/Fathom-Drone-Archive/CAD Files/Drone Related/Topside Transmitter/FP-0006.SLDPRT

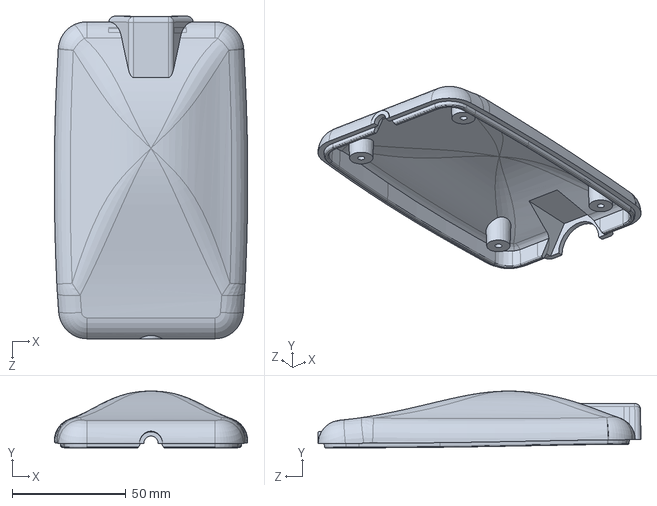
[picture p127: CAD file, 2019-07-11]
CAD Files/Drone Related/Topside Transmitter/FP-0006.SLDPRT
85.2 x 25.0 x 142.2 mm
