identitymonk/Fathom-Drone-Archive/CAD Files/Attachments/ElmoPayload/EPayload.SLDPRT

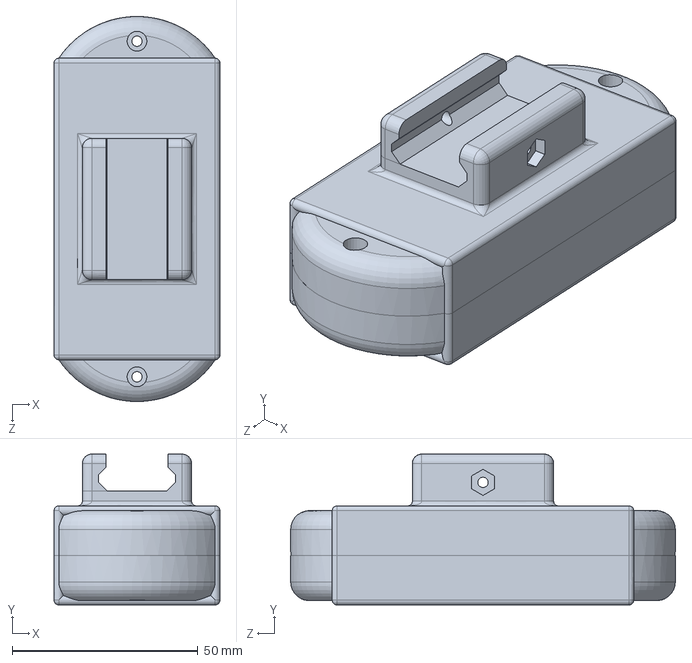
[picture p128: CAD file, 2019-07-11]
CAD Files/Attachments/ElmoPayload/EPayload.SLDPRT
44.7 x 40.6 x 103.7 mm
