identitymonk/Fathom-Drone-Archive/CAD Files/Attachments/GoPro_Streamlined1.STL

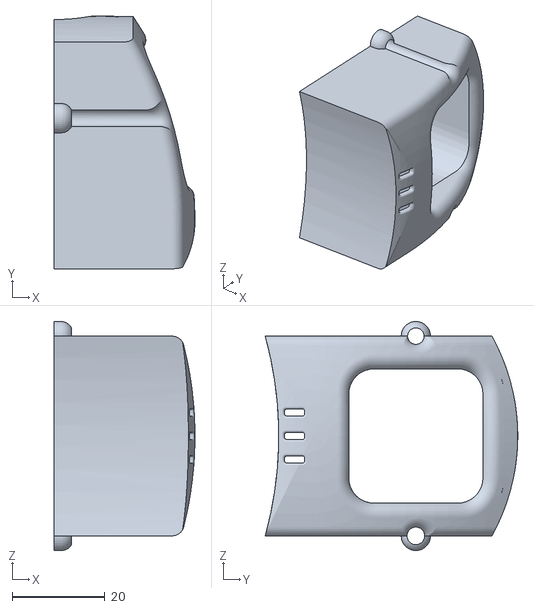
[picture p129: CAD file, 2019-07-11]
CAD Files/Attachments/GoPro_Streamlined1.STL
30.5 x 54.6 x 49.5
