identitymonk/Fathom-Drone-Archive/CAD Files/Attachments/LightModule2/LightModule1.STL

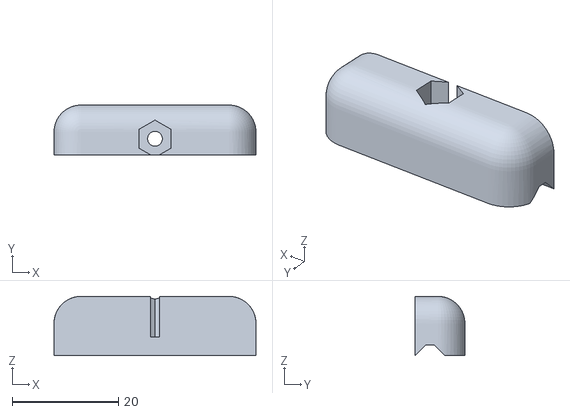
[picture p130: CAD file, 2019-07-11]
CAD Files/Attachments/LightModule2/LightModule1.STL
38.1 x 9.40 x 11.2
