identitymonk/Fathom-Drone-Archive/CAD Files/Drone Related/Face.Assembly/Copy of OVA5647_IR-Glas_Standard.sldprt

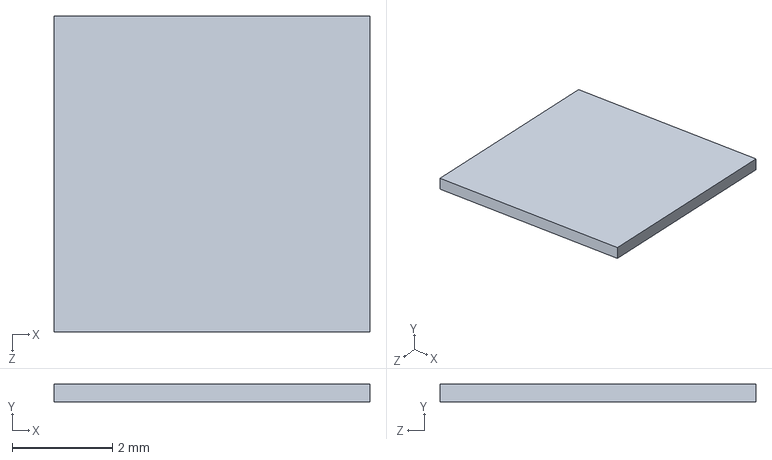
[picture p131: CAD file, 2019-07-11]
CAD Files/Drone Related/Face.Assembly/Copy of OVA5647_IR-Glas_Standard.sldprt
6.30 x 0.35 x 6.30 mm
