identitymonk/Fathom-Drone-Archive/CAD Files/Drone Related/Printer Files/TrimWeight1.STL

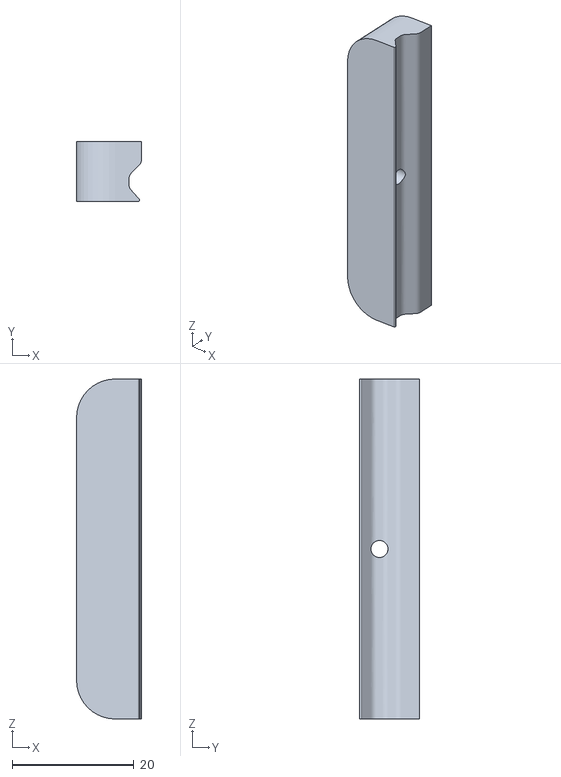
[picture p132: CAD file, 2019-07-11]
CAD Files/Drone Related/Printer Files/TrimWeight1.STL
10.7 x 9.91 x 55.9
