identitymonk/Fathom-Drone-Archive/CAD Files/Attachments/ElmoPayload/EPayload3.STL

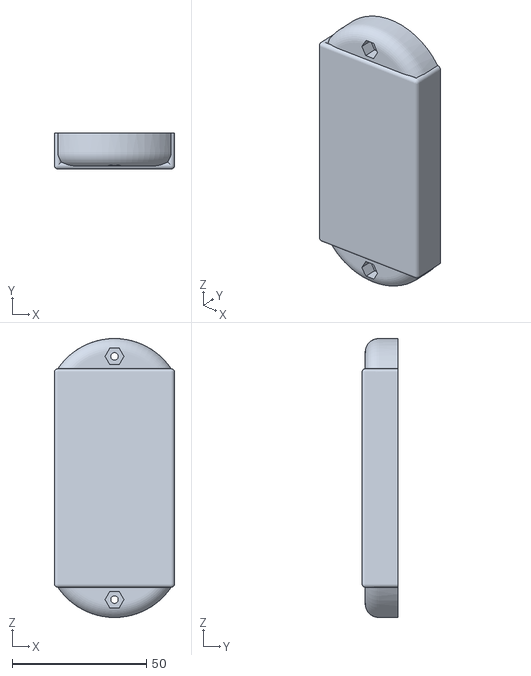
[picture p133: CAD file, 2019-07-11]
CAD Files/Attachments/ElmoPayload/EPayload3.STL
44.7 x 13.3 x 103.7
