identitymonk/Fathom-Drone-Archive/CAD Files/Attachments/FlashlightMount.SLDPRT

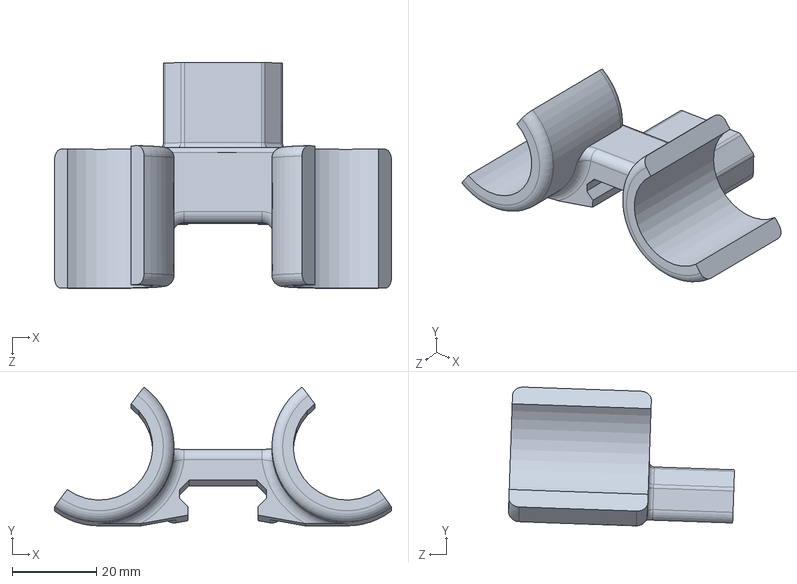
[picture p134: CAD file, 2019-07-11]
CAD Files/Attachments/FlashlightMount.SLDPRT
80.1 x 33.0 x 53.7 mm
