identitymonk/Fathom-Drone-Archive/CAD Files/Attachments/LightModule2/LightModule4.STL

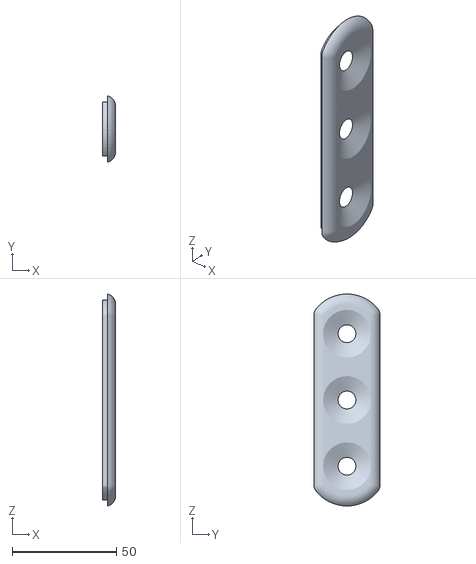
[picture p135: CAD file, 2019-07-11]
CAD Files/Attachments/LightModule2/LightModule4.STL
6.35 x 31.8 x 101.6
