identitymonk/Fathom-Drone-Archive/CAD Files/Drone Related/Face.Assembly/Copy of OVA5647_Standard.sldprt

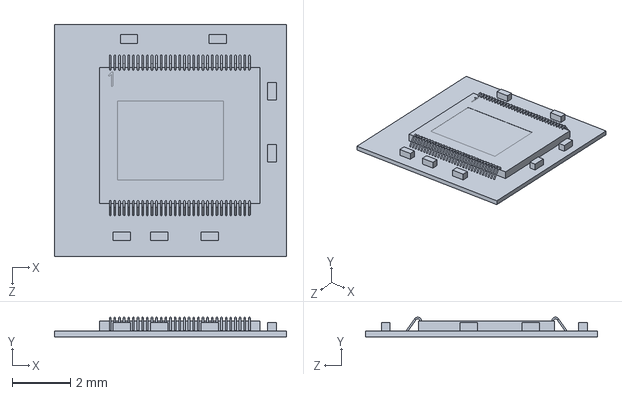
[picture p136: CAD file, 2019-07-11]
CAD Files/Drone Related/Face.Assembly/Copy of OVA5647_Standard.sldprt
8.00 x 0.68 x 8.00 mm
