identitymonk/Fathom-Drone-Archive/CAD Files/Drone Related/Printer Files/Face.001.STL

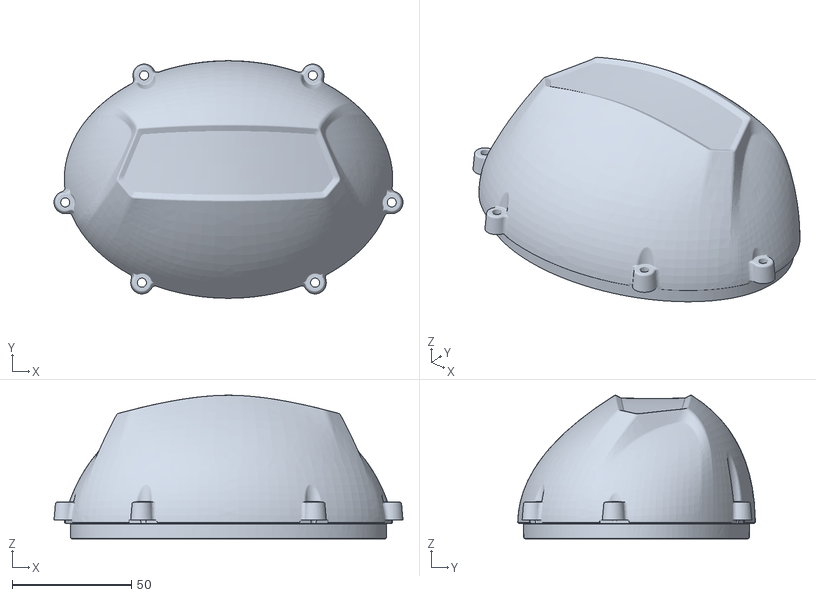
[picture p137: CAD file, 2019-07-11]
CAD Files/Drone Related/Printer Files/Face.001.STL
146.3 x 99.6 x 60.2
