identitymonk/Fathom-Drone-Archive/CAD Files/Attachments/Light Modules.SLDPRT

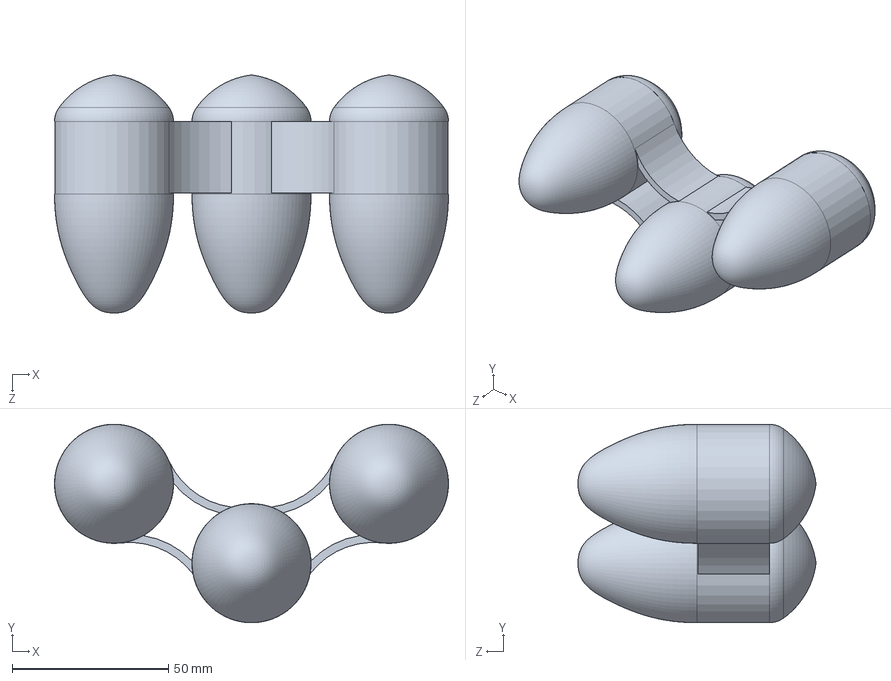
[picture p138: CAD file, 2019-07-11]
CAD Files/Attachments/Light Modules.SLDPRT
126.1 x 63.5 x 76.2 mm
