identitymonk/Fathom-Drone-Archive/CAD Files/Drone Related/Face.Assembly/Copy of OVA5647_Housing_Standard.sldprt

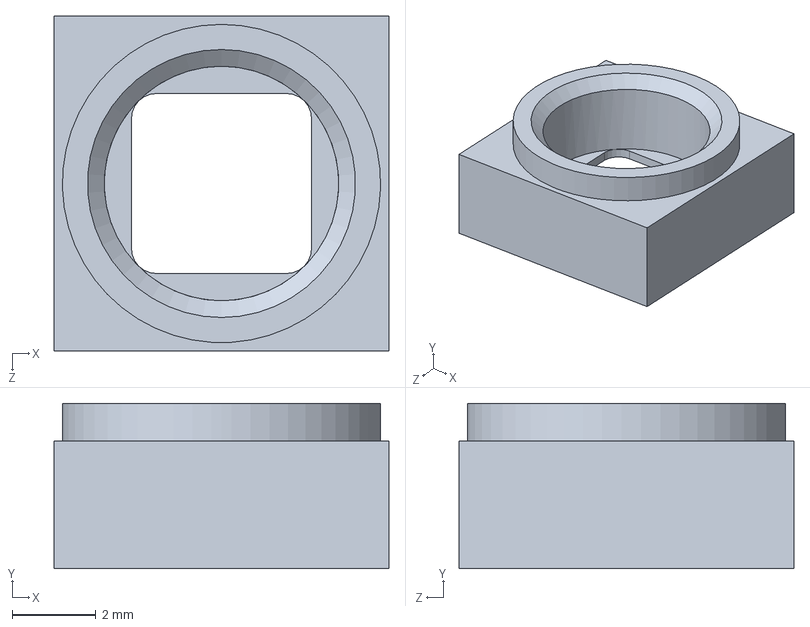
[picture p139: CAD file, 2019-07-11]
CAD Files/Drone Related/Face.Assembly/Copy of OVA5647_Housing_Standard.sldprt
8.00 x 3.95 x 8.00 mm
