identitymonk/Fathom-Drone-Archive/CAD Files/Attachments/GoPro_Streamlined2.STL

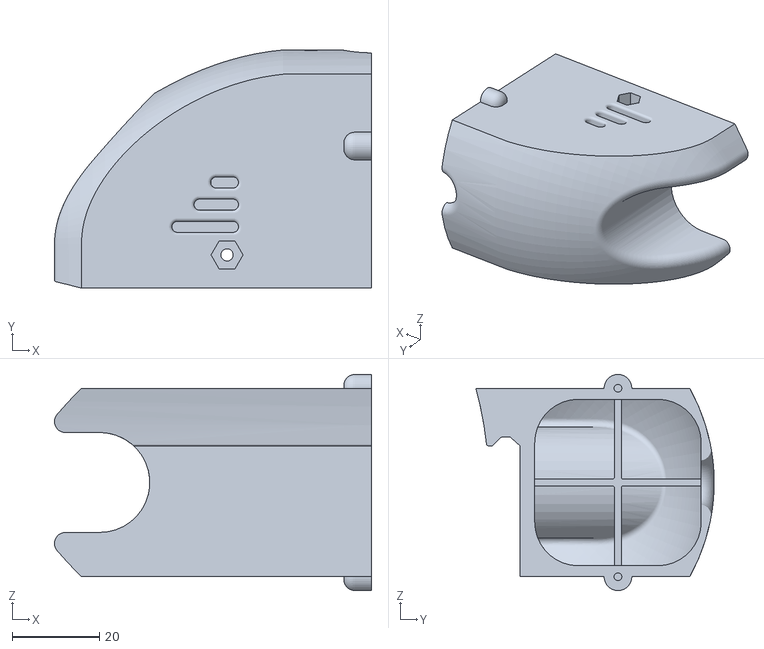
[picture p140: CAD file, 2019-07-11]
CAD Files/Attachments/GoPro_Streamlined2.STL
72.6 x 54.6 x 49.5
