identitymonk/Fathom-Drone-Archive/CAD Files/Drone Related/Face.Assembly/Copy of OVA5647_Lens_FOV.sldprt

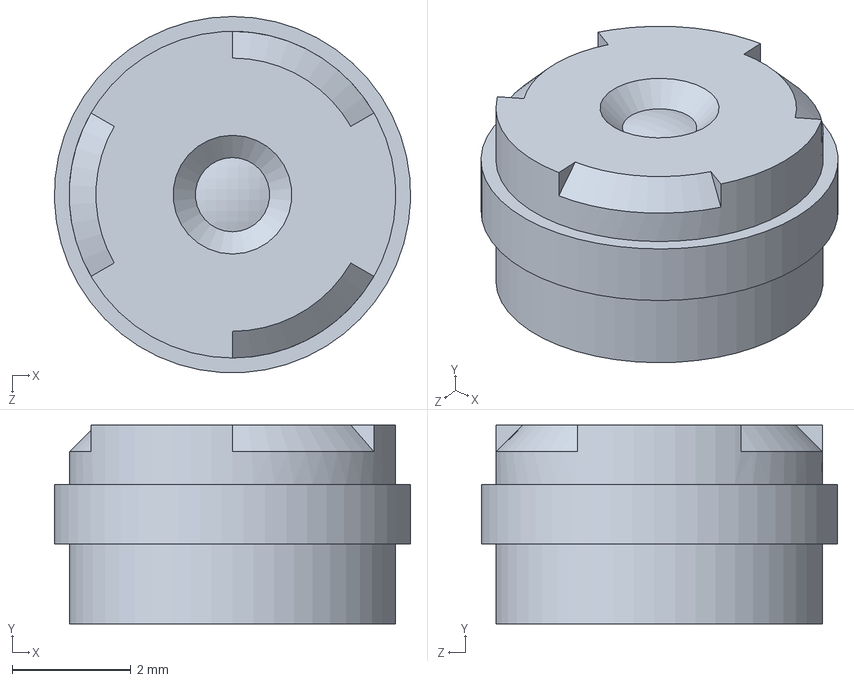
[picture p141: CAD file, 2019-07-11]
CAD Files/Drone Related/Face.Assembly/Copy of OVA5647_Lens_FOV.sldprt
6.00 x 3.35 x 5.99 mm
