identitymonk/Fathom-Drone-Archive/CAD Files/Drone Related/Printer Files/face.bracket.STL

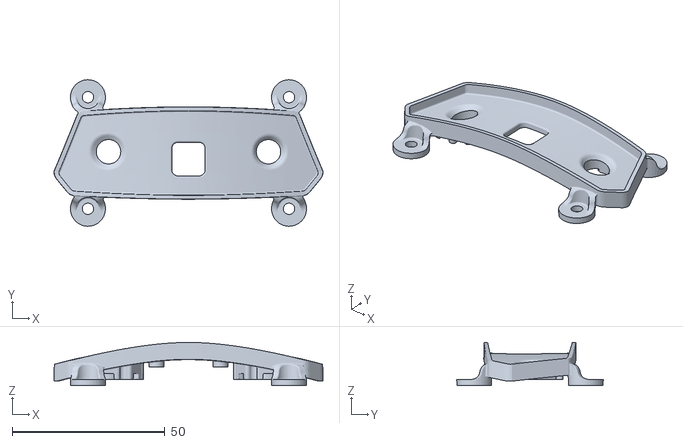
[picture p142: CAD file, 2019-07-11]
CAD Files/Drone Related/Printer Files/face.bracket.STL
88.0 x 48.0 x 14.1
