identitymonk/Fathom-Drone-Archive/CAD Files/Drone Related/Face.Assembly/Copy of OVA5647_Pigtail_Standard.sldprt

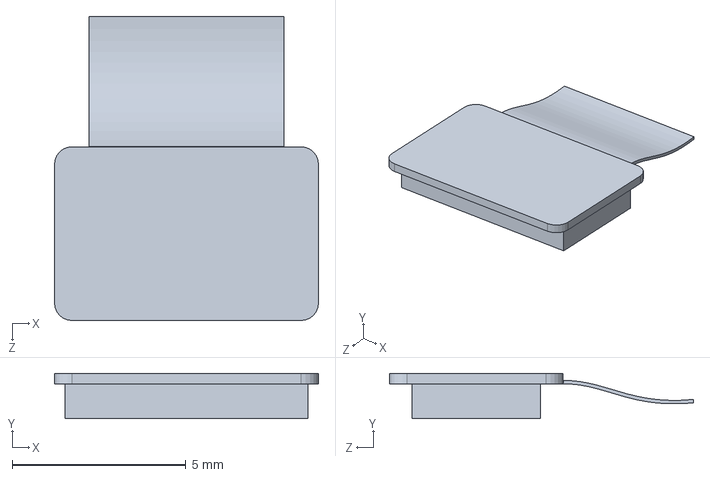
[picture p143: CAD file, 2019-07-11]
CAD Files/Drone Related/Face.Assembly/Copy of OVA5647_Pigtail_Standard.sldprt
7.60 x 1.30 x 8.75 mm
