identitymonk/Fathom-Drone-Archive/(list of files, cad)

Other CAD files:
CAD Files/Drone Related/Prop.001.SLDPRT
FaceMask/Faceplate.dwg
CAD Files/Drone Related/Topside Transmitter/FP-0006_TransmitterTopHalf.STL
CAD Files/Drone Related/Topside Transmitter/FP-0007.SLDPRT
CAD Files/Drone Related/Printer Files/Thruster.002.STL
CAD Files/Drone Related/Printer Files/Prop.001_R.STL
CAD Files/Attachments/Fixtures and Tools/Transducer Wrench.STL
CAD Files/Drone Related/Face.Assembly/fasteners/97975A215_THRD-FORMING 410 SS SCREW FOR BRITTLE PLASTIC.SLDPRT
