identitymonk/Fathom-Drone-Archive/Packaging Instructions/Assets/BatterySticker.png

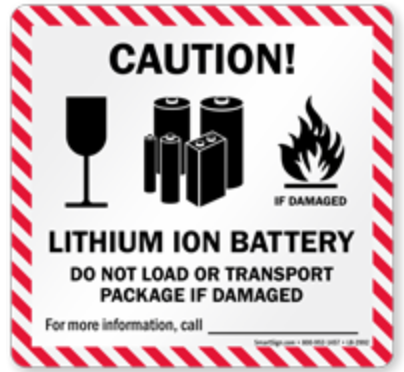
Packaging Instructions/Assets/BatterySticker.png
