identitymonk/Fathom-Drone-Archive/Packaging Instructions/Assets/Instruction booklet.png

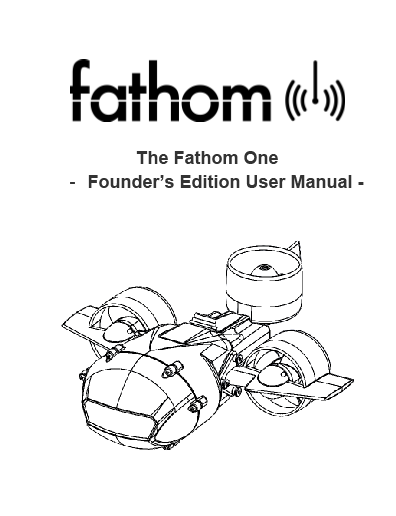
Packaging Instructions/Assets/Instruction booklet.png
