identitymonk/Fathom-Drone-Archive/Packaging Instructions/Assets/PackagingDiagramV2.png

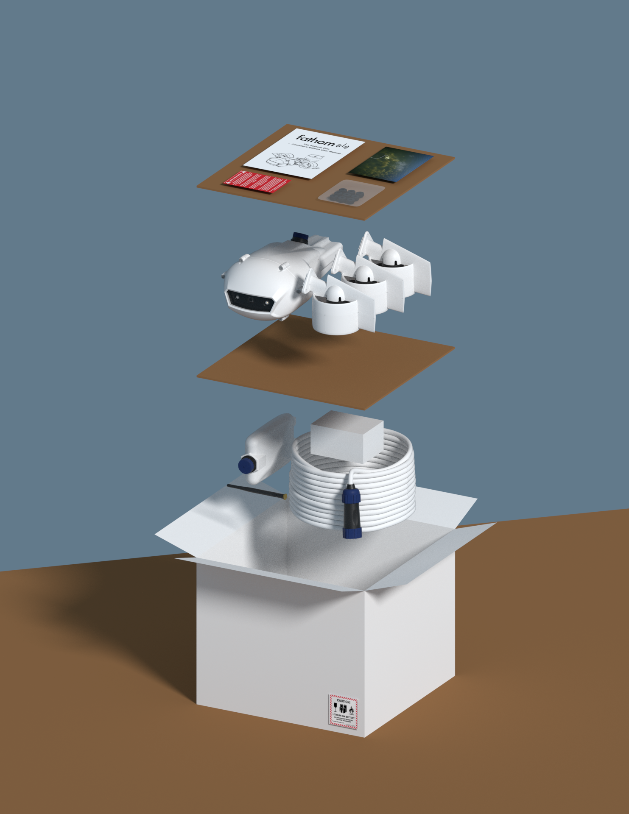
Packaging Instructions/Assets/PackagingDiagramV2.png
