identitymonk/Fathom-Drone-Archive/Packaging Instructions/Assets/Warningcard.png

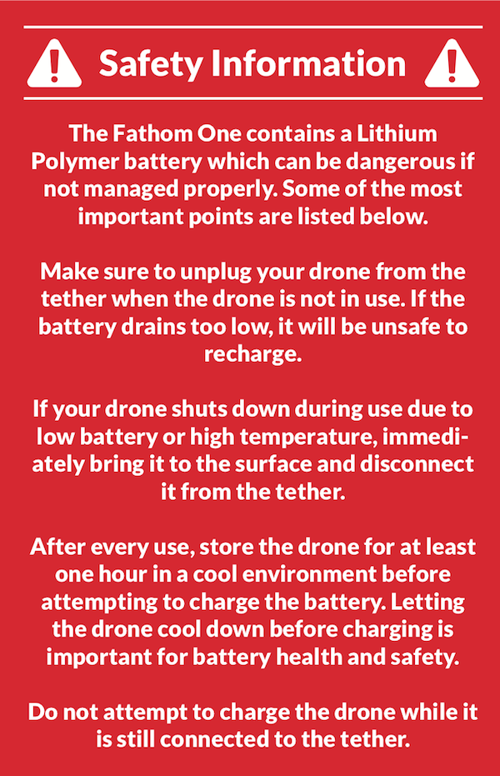
Packaging Instructions/Assets/Warningcard.png
