identitymonk/Fathom-Drone-Archive/Packaging Instructions/Fathom-One-Boxing-Diagram-V2.png

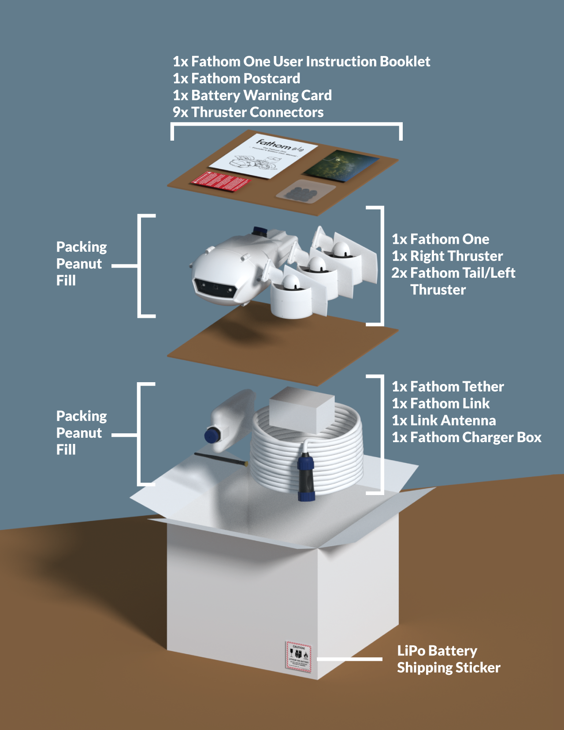
Packaging Instructions/Fathom-One-Boxing-Diagram-V2.png
