identitymonk/Fathom-Drone-Archive/Website/April 2018/Assets/iOS Testflight/Step1.PNG

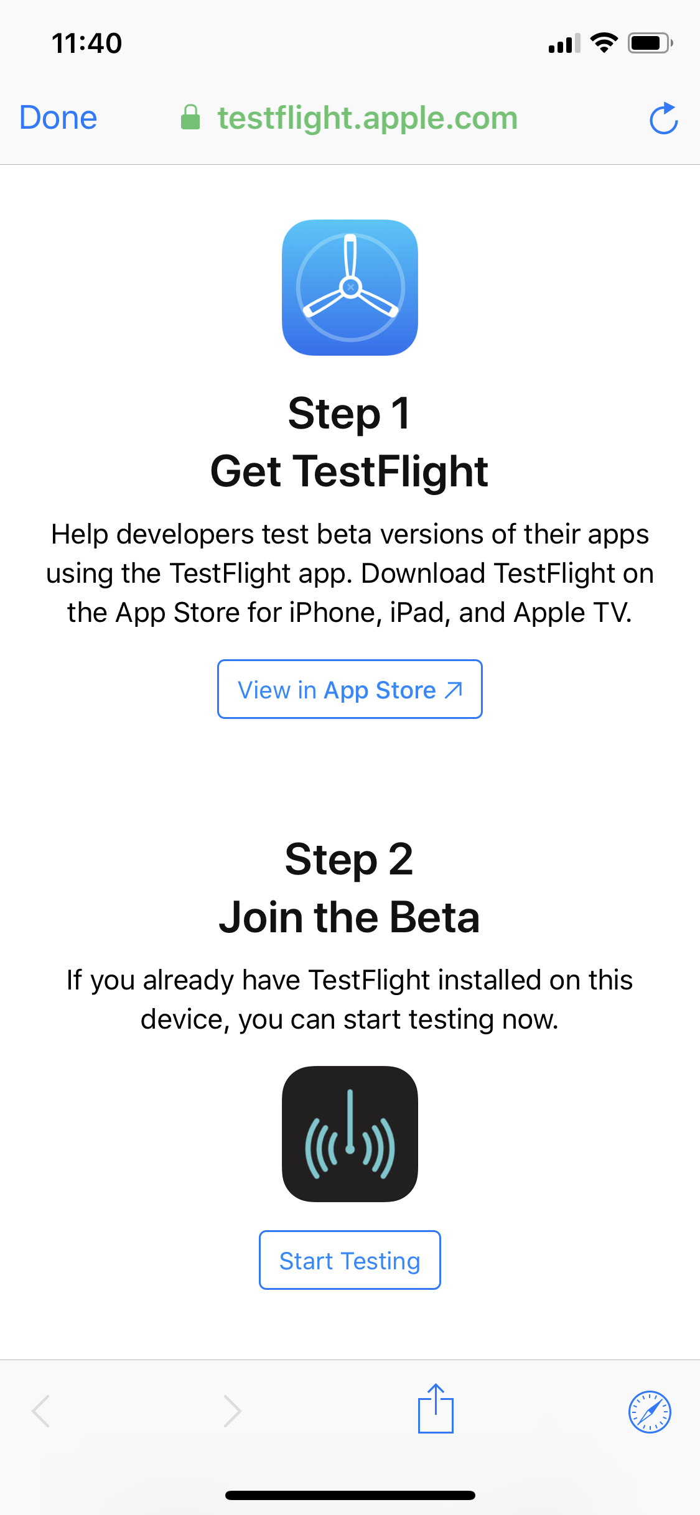
Website/April 2018/Assets/iOS Testflight/Step1.PNG
