identitymonk/Fathom-Drone-Archive/Website/April 2018/Assets/iOS Testflight/DownloadFathom.PNG

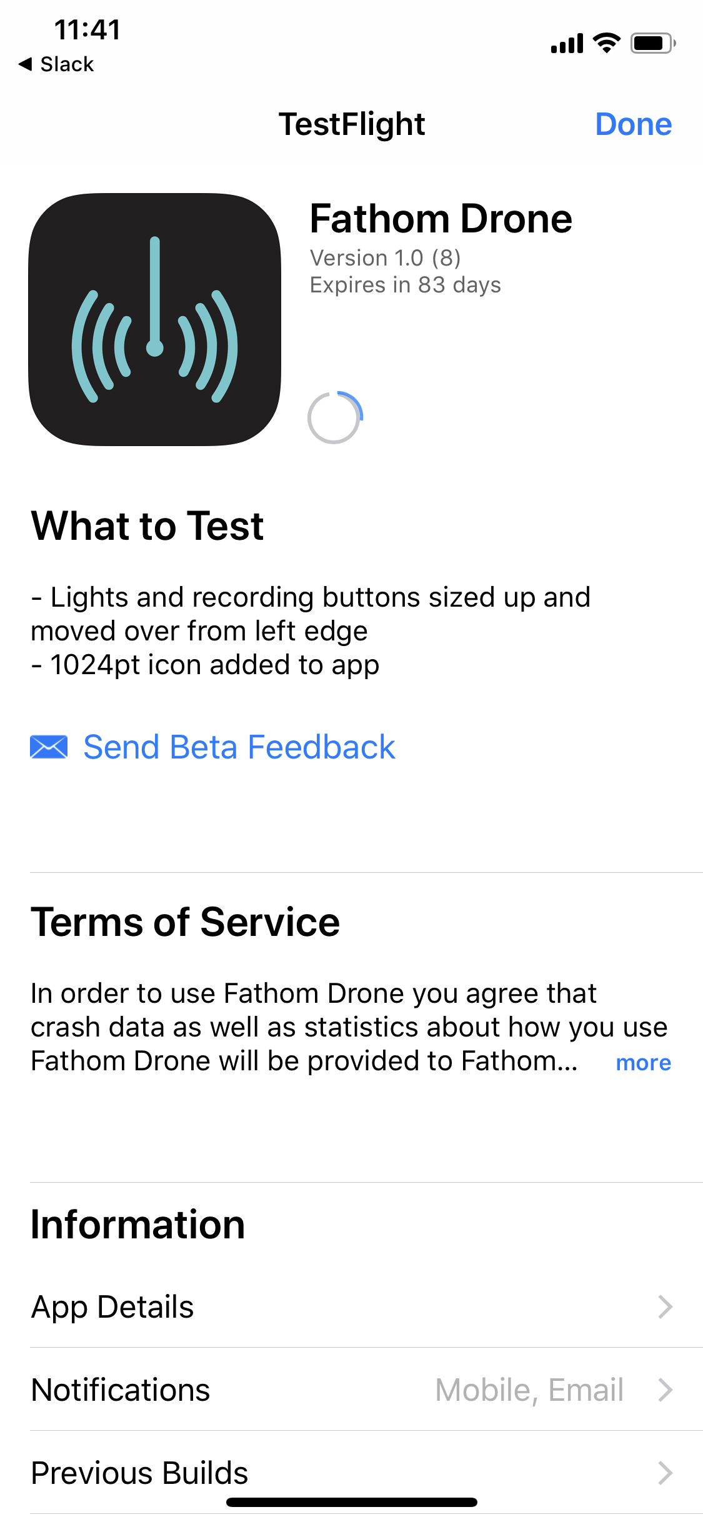
Website/April 2018/Assets/iOS Testflight/DownloadFathom.PNG
