identitymonk/Fathom-Drone-Archive/Website/April 2018/Assets/iOS Testflight/DownloadTestflight.jpeg

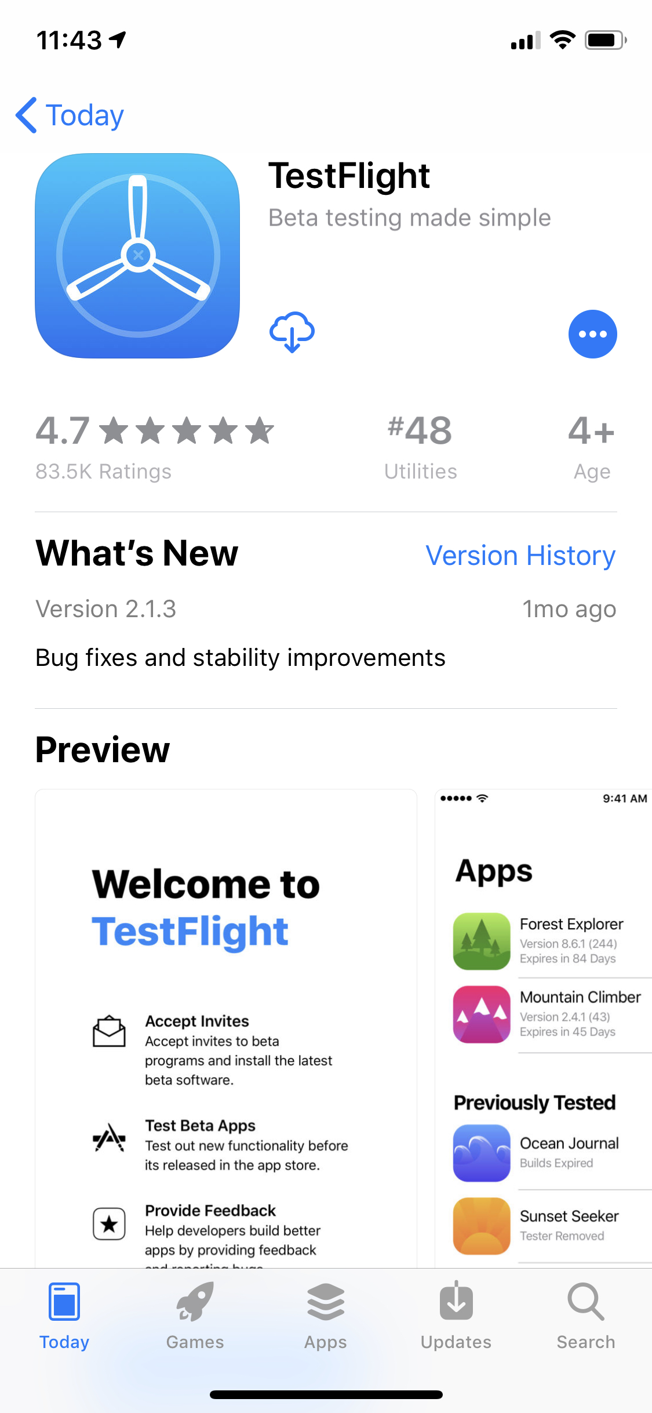
Website/April 2018/Assets/iOS Testflight/DownloadTestflight.jpeg
