identitymonk/Fathom-Drone-Archive/CAD Files/Drone Related/Body.004.pdf

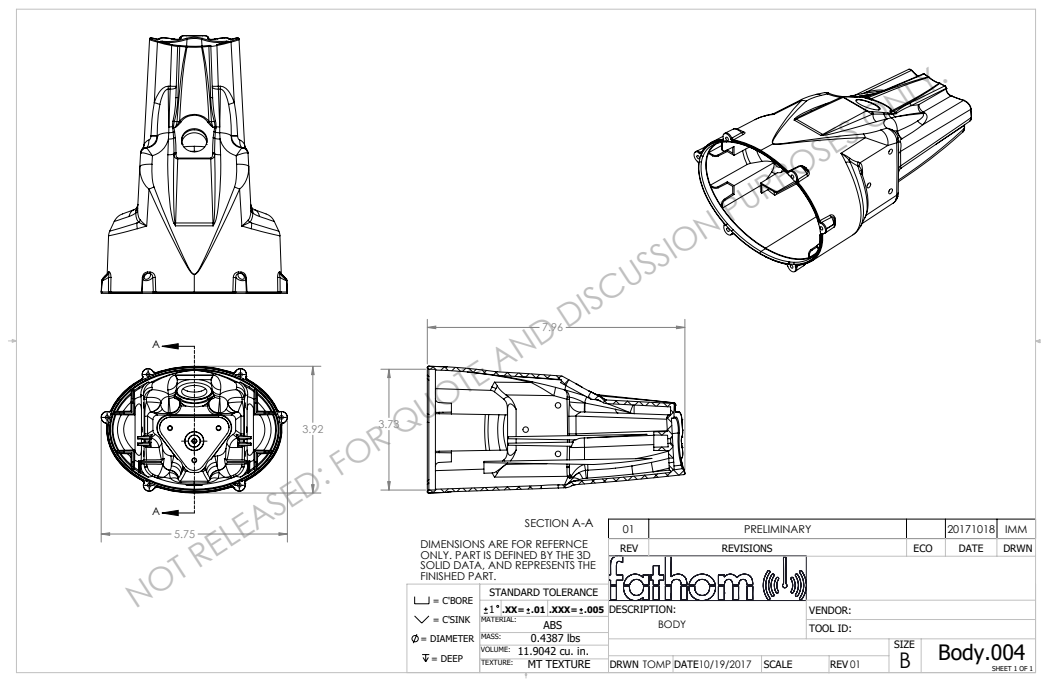
[picture p166: page 1]
SECTION A-A; SHEET 1 OF 1; TOOL ID:; Body.004 TOMP; 0.4387 lbs; REV 01

NOT RELEASED: FOR QUOTE AND DISCUSSION PURPOSES ONLY.

DIMENSIONS ARE FOR REFERNCE
ONLY. PART IS DEFINED BY THE 3D
SOLID DATA, AND REPRESENTS THE
FINISHED PART.
= C'BORE
= C'SINK
= DIAMETER
= DEEP

STANDARD TOLERANCE
.XX= .01 .XXX= .005
MATERIAL:
MASS:
MT TEXTURE TEXTURE:
