identitymonk/Fathom-Drone-Archive/CAD Files/Drone Related/Face.001.pdf

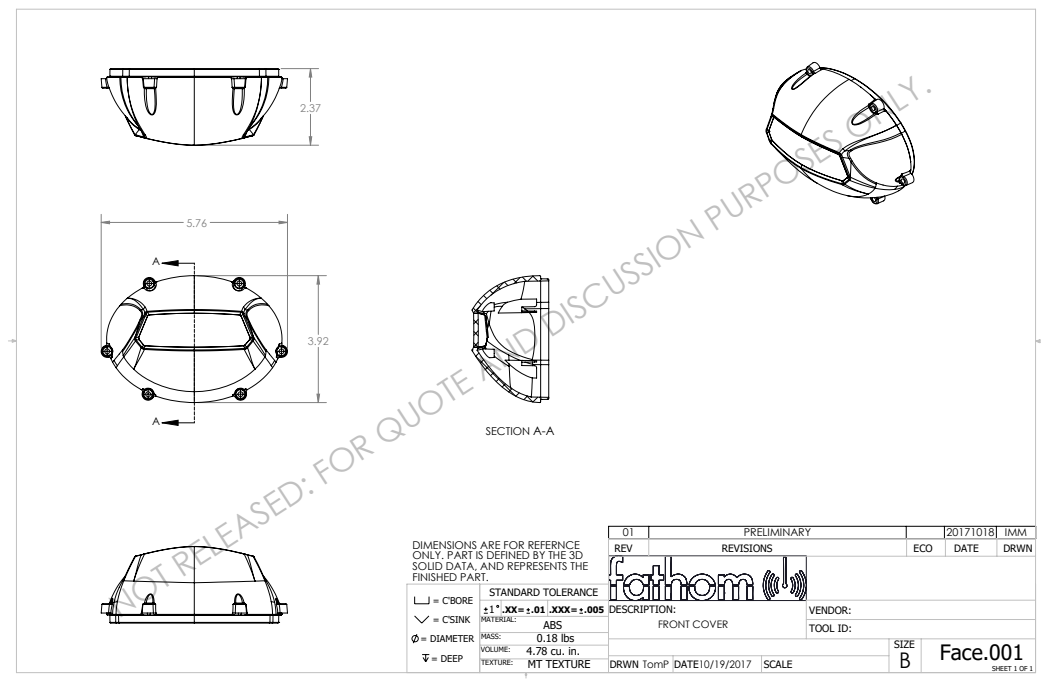
[picture p167: page 1]
SECTION A-A; FRONT COVER; SHEET 1 OF 1; TOOL ID:; Face.001 TomP; 0.18 lbs

NOT RELEASED: FOR QUOTE AND DISCUSSION PURPOSES ONLY.

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

STANDARD TOLERANCE
.XX= .01 .XXX= .005
MATERIAL:
MASS:
MT TEXTURE TEXTURE:
