identitymonk/Fathom-Drone-Archive/CAD Files/Drone Related/face.bracket.pdf

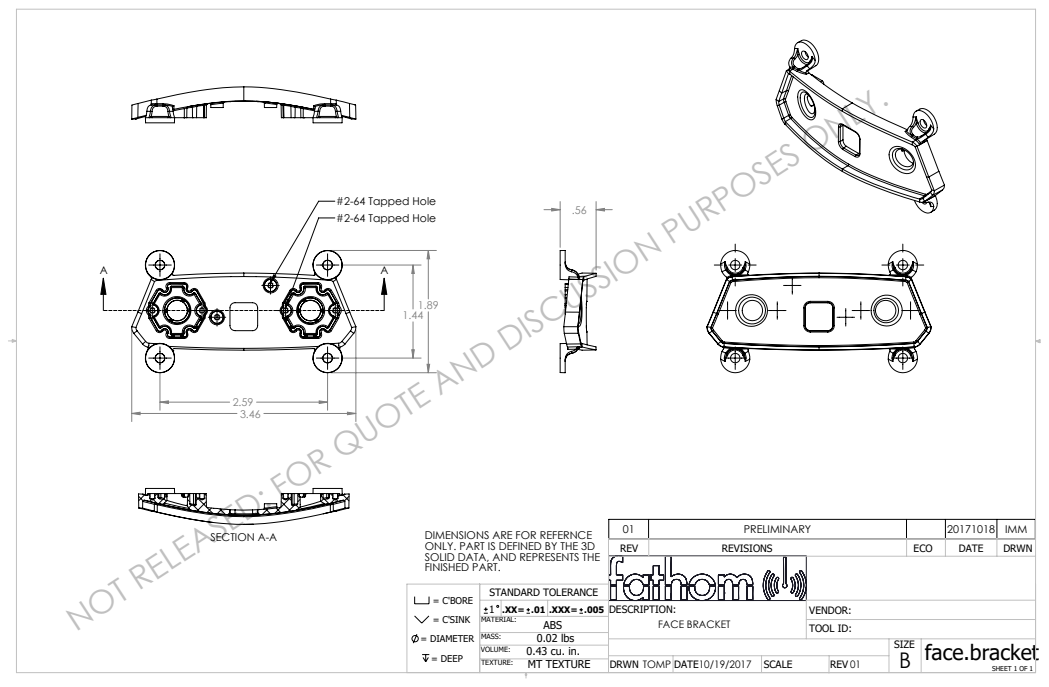
[picture p168: page 1]
#2-64 Tapped Hole; SECTION A-A; DIMENSIONS ARE FOR REFERNCE; FACE BRACKET; SHEET 1 OF 1; TOOL ID:; = C'BORE = C'SINK = DIAMETER = DEEP; face.bracket TOMP; 0.02 lbs; REV 01

NOT RELEASED: FOR QUOTE AND DISCUSSION PURPOSES ONLY.

ONLY. PART IS DEFINED BY THE 3D
SOLID DATA, AND REPRESENTS THE
FINISHED PART.

STANDARD TOLERANCE
.XX= .01 .XXX= .005
MATERIAL:
MASS:
MT TEXTURE TEXTURE:
