identitymonk/Fathom-Drone-Archive/CAD Files/Drone Related/Thruster.002.pdf

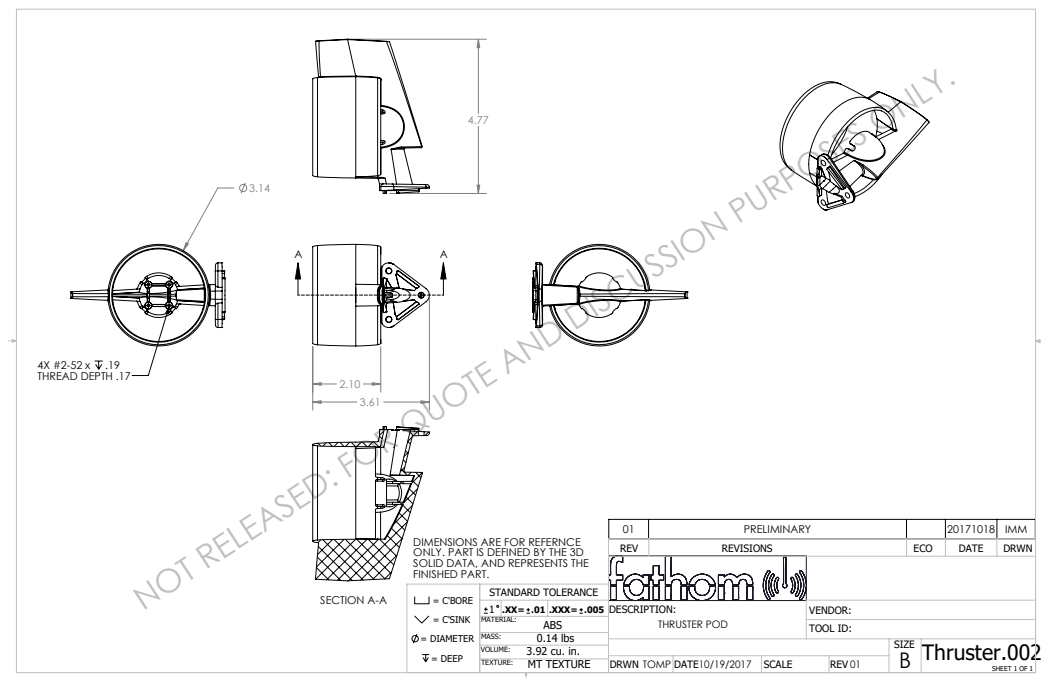
[picture p169: page 1]
4X #2-52 x .19 THREAD DEPTH .17; SECTION A-A; THRUSTER POD; SHEET 1 OF 1; TOOL ID:; = C'BORE = C'SINK = DIAMETER = DEEP; Thruster.002 TOMP; 0.14 lbs; REV 01

NOT RELEASED: FOR QUOTE AND DISCUSSION PURPOSES ONLY.

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

STANDARD TOLERANCE
.XX= .01 .XXX= .005
MATERIAL:
MASS:
MT TEXTURE TEXTURE:
