identitymonk/Fathom-Drone-Archive/FaceMask/facemask.pdf

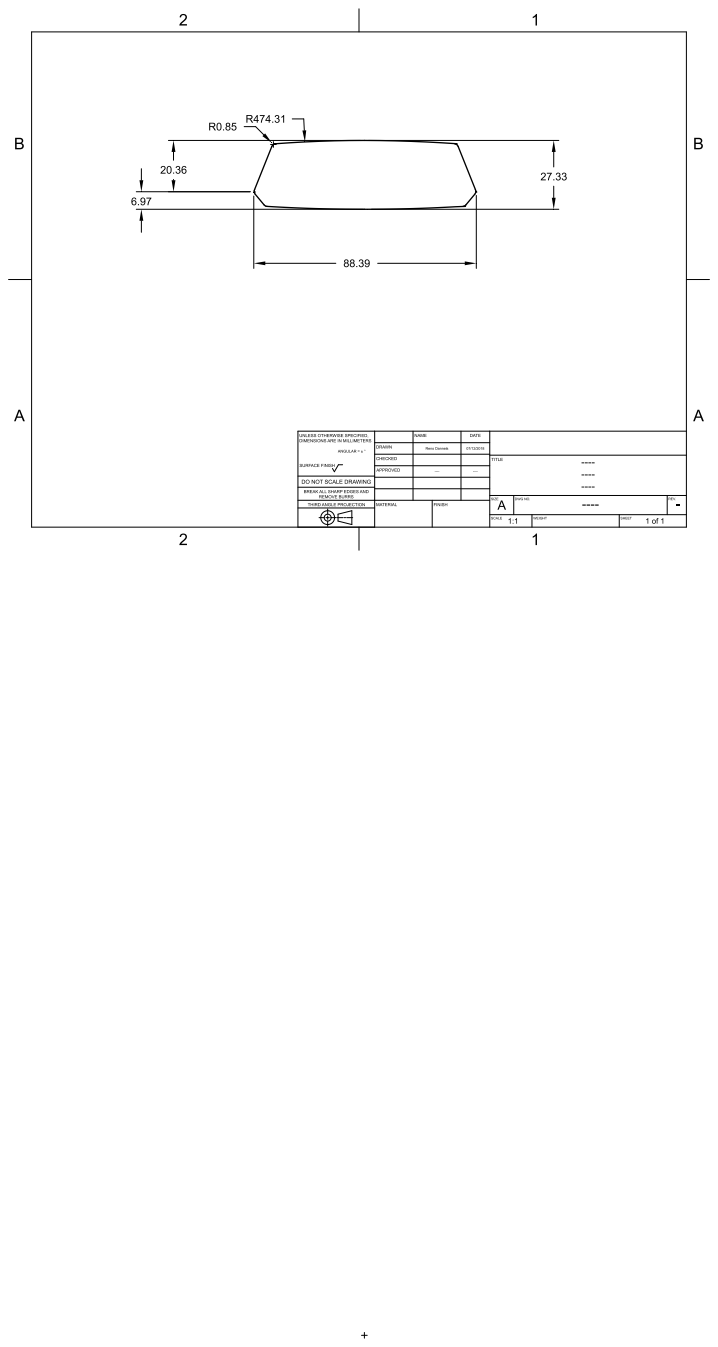
[picture p170: page 1]
