identitymonk/Fathom-Drone-Archive/Electronics/PCBA/Fathom Drone Pi Shield.brd

## EAGLE design Electronics/PCBA/Fathom Drone Pi Shield.brd (2019-07-11)

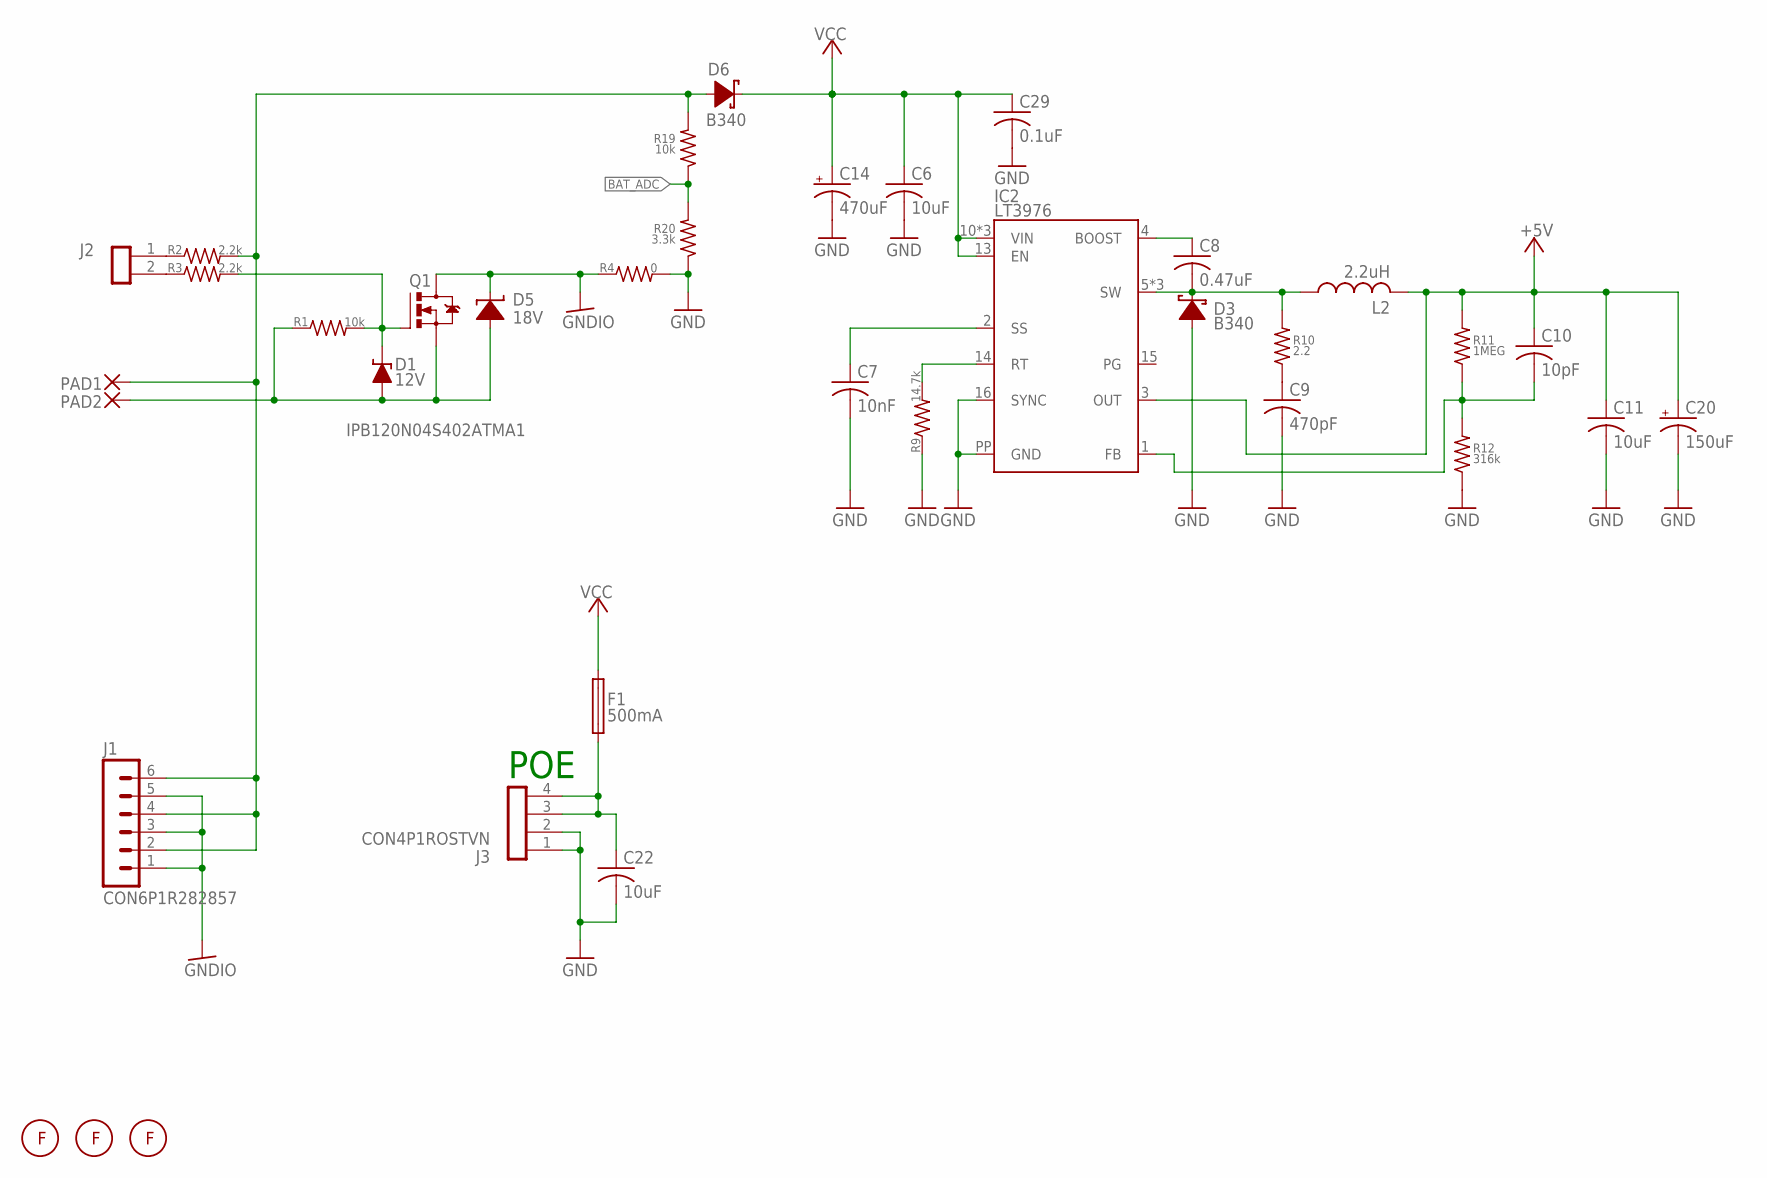
[picture p171: schematic Fathom Drone Pi Shield.sch, sheet 1]

Parts:
C6, C22: 10uF; C1206
C7: 10nF; C0402
C8: 0.47uF; C0603
C9: 470pF; C0603
C10: 10pF; C0603
C11: 10uF; C0805
C14: 470uF; E3,5-8
C20: 150uF; PANASONIC_C
C29: 0.1uF; C0402
D1: 12V; SOT-23
D3, D6: B340; SMA
D5: 18V; SMC
F1: 500mA; BETTER_LITTELFUSE1812
FM1, FM2, FM3: FIDUCIAL1MM; 1MMCIRCLE
IC2: LT3976; MSOP-16-PP
J1: CON6P1R282857; 282857-6
J2: CON2P1ROSTVN; OSTVN02A150
J3: CON4P1ROSTVN; OSTVN04A150
L2: 2.2uH; VLP8040
PAD1, PAD2: WIREPAD5.5/3,0; 5.5/3,0
Q1: IPB120N04S402ATMA1; TO263
R1, R19: 10k; R0603
R2, R3: 2.2k; R0603
R4: 0; R0805
R9: 14.7k; R0603
R10: 2.2; R0603
R11: 1MEG; R0603
R12: 316k; R0603
R20: 3.3k; R0402

Connections:
+5V: C10.1, C11.1, C20.+, IC2.3 (OUT), L2.P$2 (2), R11.2; also elsewhere on the board
BAT_ADC: R19.1, R20.2; also elsewhere on the board
GND: C6.2, C7.2, C9.2, C11.2, C14.-, C20.-, C22.2, C29.2, D3.A, IC2.16 (SYNC), IC2.PP (GND), J3.1, J3.2, R4.2, R9.1, R12.1, R20.1; also elsewhere on the board
GNDIO: D5.C, J1.1, J1.3, J1.5, Q1.3 (D), R4.1
unnamed: D1.1 (A), D5.A, PAD2.P$1, Q1.2 (S), R1.1
unnamed: J2.1, R2.1
unnamed: J2.2, R3.1
unnamed: D6.A, J1.2, J1.4, J1.6, PAD1.P$1, R2.2, R19.2
unnamed: C7.1, IC2.2 (SS)
unnamed: IC2.14 (RT), R9.2
unnamed: C8.2, D3.C, IC2.5 (SW), IC2.6 (SW), IC2.7 (SW), L2.P$1 (1), R10.2
unnamed: C8.1, IC2.4 (BOOST)
unnamed: C9.1, R10.1
unnamed: C10.2, IC2.1 (FB), R11.1, R12.2
unnamed: D1.3 (K), Q1.1 (G), R1.2, R3.2
unnamed: C22.1, F1.P$1 (1), J3.3, J3.4
VCC: C6.1, C14.+, C29.1, D6.C, F1.P$2 (2), IC2.10 (VIN), IC2.11 (VIN), IC2.12 (VIN), IC2.13 (EN); also elsewhere on the board

Notes on the sheet:
POE

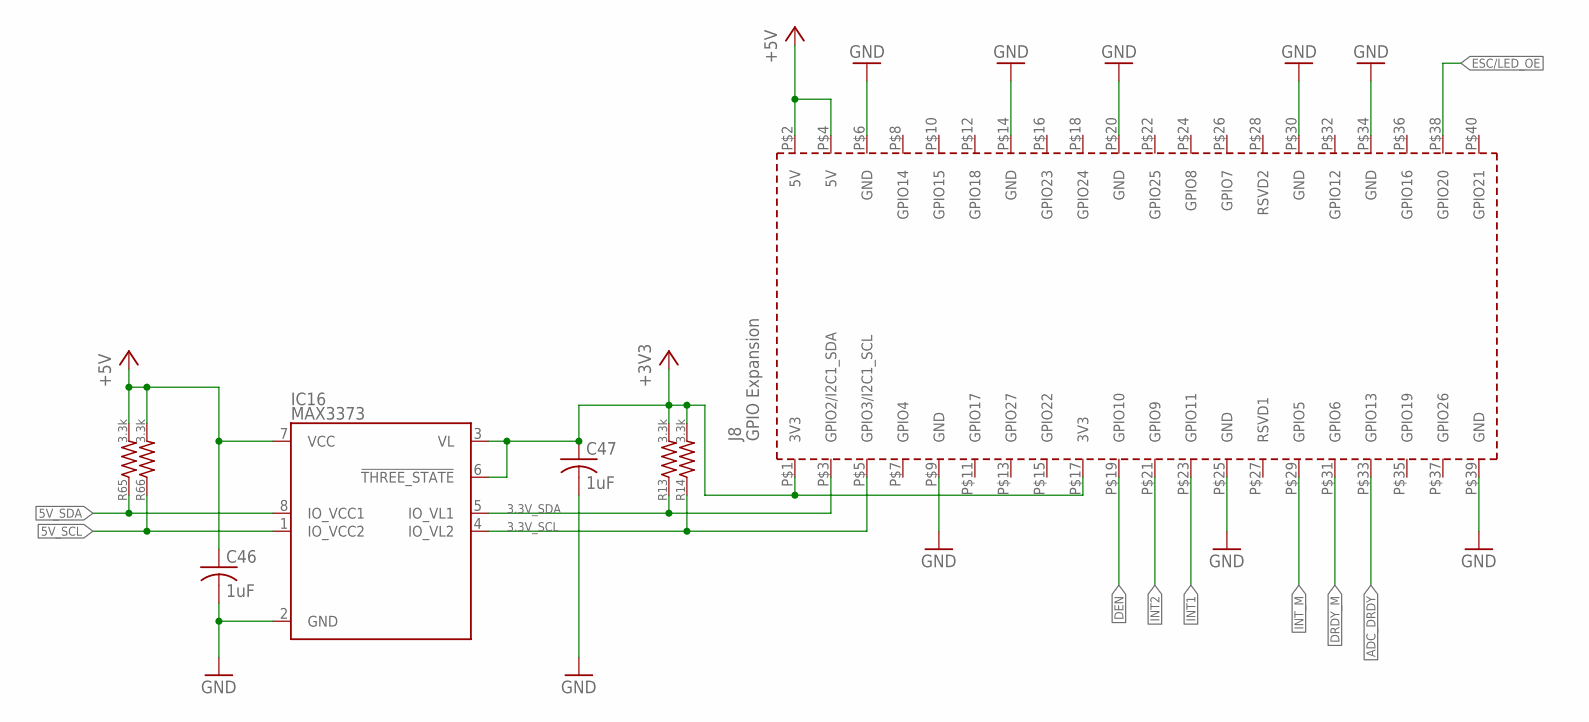
[picture p172: schematic Fathom Drone Pi Shield.sch, sheet 2]

Parts:
C46, C47: 1uF; C0402
IC16: MAX3373; TS8
PCB1: RPI3
R13, R14, R65, R66: 3.3k; R0402

Connections:
3.3V_SCL: IC16.4 (IO_VL2), PCB1.P$5 (GPIO3/I2C1_SCL), R14.1; also elsewhere on the board
3.3V_SDA: IC16.5 (IO_VL1), PCB1.P$3 (GPIO2/I2C1_SDA), R13.1; also elsewhere on the board
5V_SCL: IC16.1 (IO_VCC2), R66.1; also elsewhere on the board
5V_SDA: IC16.8 (IO_VCC1), R65.1; also elsewhere on the board
+3V3: C47.1, IC16.3 (VL), IC16.6 (!THREE_STATE), PCB1.P$1 (3V3), PCB1.P$17 (3V3), R13.2, R14.2; also elsewhere on the board
+5V: C46.1, IC16.7 (VCC), PCB1.P$2 (5V), PCB1.P$4 (5V), R65.2, R66.2; also elsewhere on the board
ADC_DRDY: PCB1.P$33 (GPIO13); also elsewhere on the board
DEN: PCB1.P$19 (GPIO10); also elsewhere on the board
DRDY_M: PCB1.P$31 (GPIO6); also elsewhere on the board
ESC/LED_OE: PCB1.P$38 (GPIO20); also elsewhere on the board
GND: C46.2, C47.2, IC16.2 (GND), PCB1.P$6 (GND), PCB1.P$9 (GND), PCB1.P$14 (GND), PCB1.P$20 (GND), PCB1.P$25 (GND), PCB1.P$30 (GND), PCB1.P$34 (GND), PCB1.P$39 (GND); also elsewhere on the board
INT1: PCB1.P$23 (GPIO11); also elsewhere on the board
INT2: PCB1.P$21 (GPIO9); also elsewhere on the board
INT_M: PCB1.P$29 (GPIO5); also elsewhere on the board

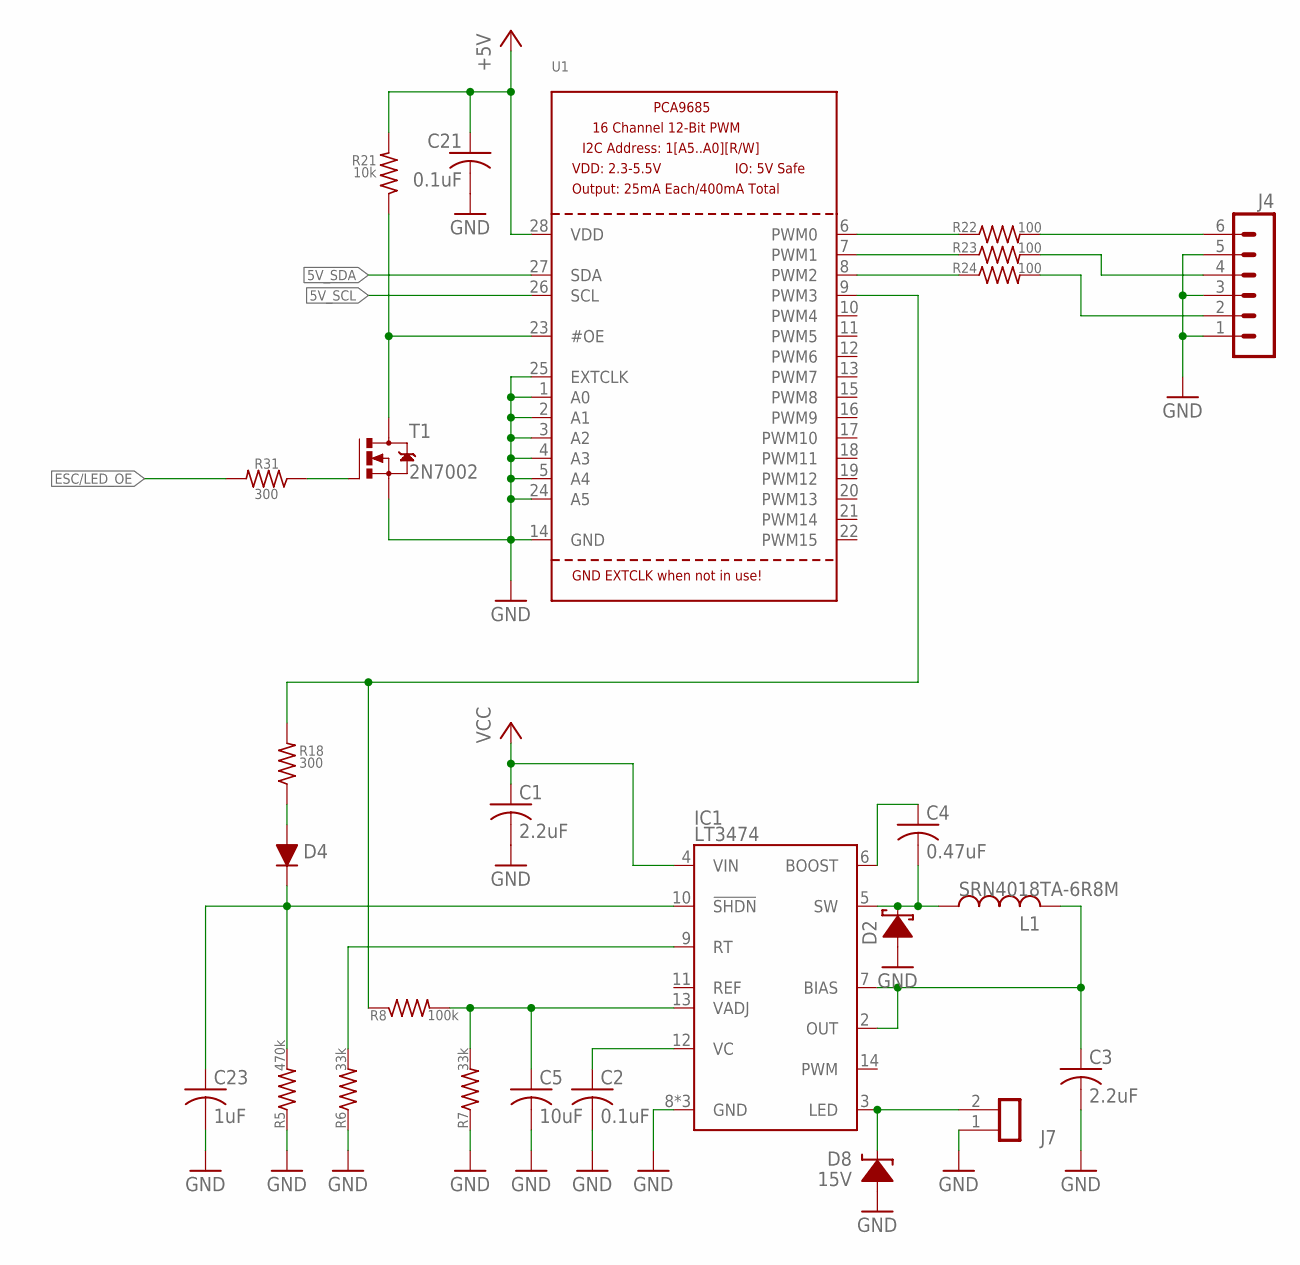
[picture p173: schematic Fathom Drone Pi Shield.sch, sheet 3]

Parts:
C1, C3: 2.2uF; C0603
C2, C21: 0.1uF; C0402
C4: 0.47uF; C0603
C5: 10uF; C0805
C23: 1uF; C0402
D2: DIODE-SCHOTTKYSMA; SMA
D4: DIODESOD-123; SOD-123
D8: 15V; SOD123FL
IC1: LT3474; TSSOP16_PP
J4: CON6P1ROSTVN; OSTVN06A150
J7: CON2P1ROSTVN; OSTVN02A150
L1: SRN4018TA-6R8M; L-4026
R5: 470k; R0603
R6, R7: 33k; R0603
R8: 100k; R0603
R18, R31: 300; R0402
R21: 10k; R0603
R22, R23, R24: 100; R0603
T1: 2N7002; SOT-23
U1: PCA9685; TSSOP28

Connections:
5V_SCL: U1.26 (SCL); also elsewhere on the board
5V_SDA: U1.27 (SDA); also elsewhere on the board
+5V: C21.1, R21.2, U1.28 (VDD); also elsewhere on the board
ESC/LED_OE: R31.2; also elsewhere on the board
GND: C1.2, C2.2, C3.2, C5.2, C21.2, C23.2, D2.A, D8.A, IC1.8 (GND), IC1.15 (GND), IC1.PP (GND), J4.1, J4.3, J4.5, J7.1, R5.1, R6.1, R7.1, T1.2 (S), U1.1 (A0), U1.2 (A1), U1.3 (A2), U1.4 (A3), U1.5 (A4), U1.14 (GND), U1.24 (A5), U1.25 (EXTCLK); also elsewhere on the board
unnamed: IC1.9 (RT), R6.2
unnamed: R21.1, T1.3 (D), U1.23 (#OE)
unnamed: C2.1, IC1.12 (VC)
unnamed: D8.K (C), IC1.3 (LED), J7.2
unnamed: C3.1, IC1.2 (OUT), IC1.7 (BIAS), L1.P$2 (2)
unnamed: C4.2, D2.C, IC1.5 (SW), L1.P$1 (1)
unnamed: C4.1, IC1.6 (BOOST)
unnamed: C5.1, IC1.13 (VADJ), R7.2, R8.2
unnamed: R22.1, U1.6 (PWM0)
unnamed: R23.1, U1.7 (PWM1)
unnamed: R24.1, U1.8 (PWM2)
unnamed: R8.1, R18.2, U1.9 (PWM3)
unnamed: J4.6, R22.2
unnamed: J4.4, R23.2
unnamed: J4.2, R24.2
unnamed: C23.1, D4.K, IC1.10 (!SHDN), R5.2
unnamed: D4.A, R18.1
unnamed: R31.1, T1.1 (G)
VCC: C1.1, IC1.4 (VIN); also elsewhere on the board

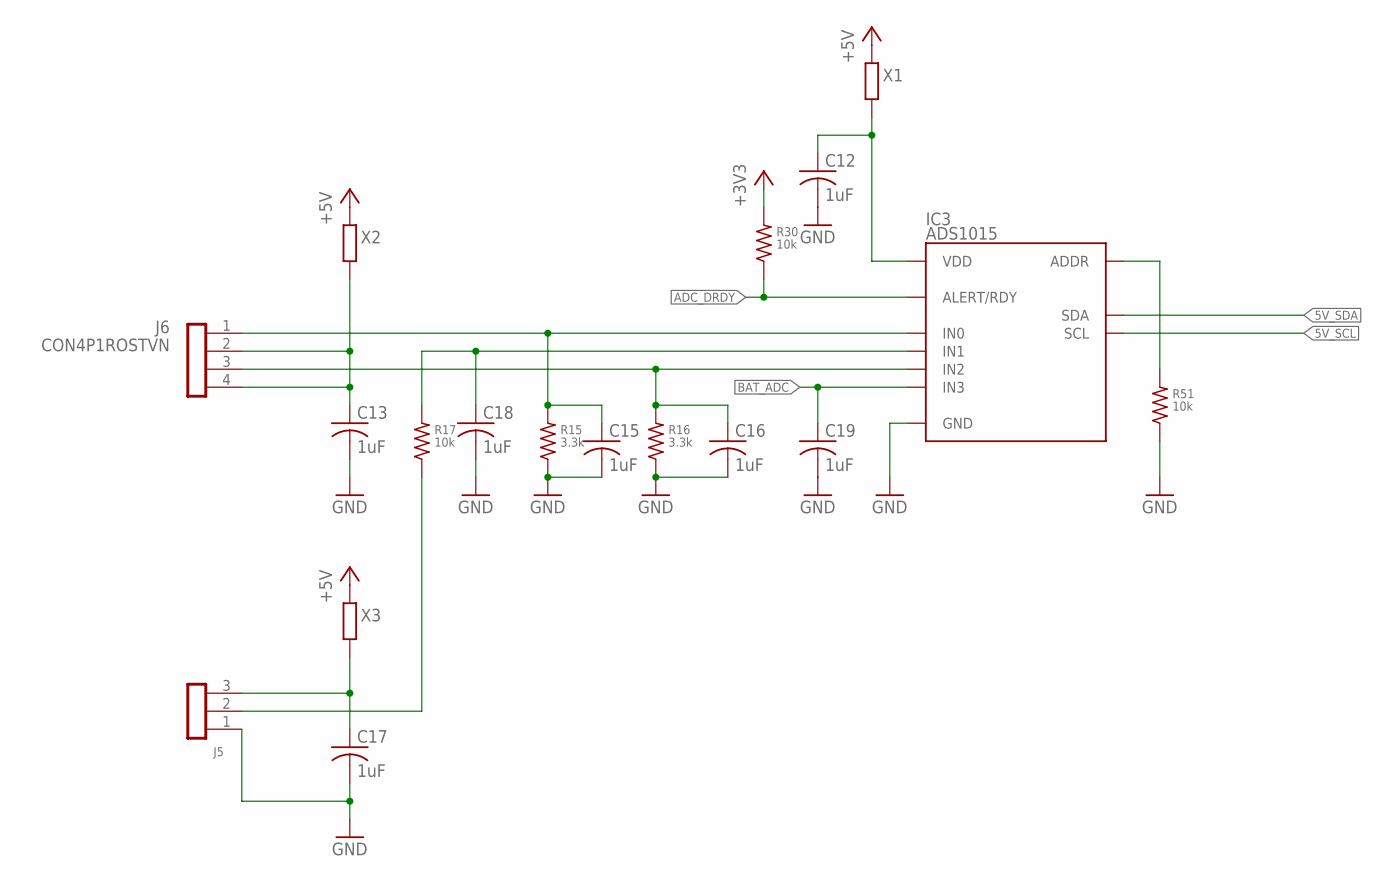
[picture p174: schematic Fathom Drone Pi Shield.sch, sheet 4]

Parts:
C12, C13, C15, C16, C17, C18, C19: 1uF; C0402
IC3: ADS1015; MSOP10
J5: CON3P1ROSTVN; OSTVN03A150
J6: CON4P1ROSTVN; OSTVN04A150
R15, R16: 3.3k; R0402
R17, R30, R51: 10k; R0603
X1, X2, X3: PASSIVE0603; R0603@1

Connections:
5V_SCL: IC3.10 (SCL); also elsewhere on the board
5V_SDA: IC3.9 (SDA); also elsewhere on the board
+3V3: R30.2; also elsewhere on the board
+5V: X1.2, X2.2, X3.2; also elsewhere on the board
ADC_DRDY: IC3.2 (ALERT/RDY), R30.1; also elsewhere on the board
BAT_ADC: C19.1, IC3.7 (IN3); also elsewhere on the board
GND: C12.2, C13.2, C15.2, C16.2, C17.2, C18.2, C19.2, IC3.3 (GND), J5.1, R15.1, R16.1, R51.1; also elsewhere on the board
unnamed: C15.1, IC3.4 (IN0), J6.1, R15.2
unnamed: C16.1, IC3.6 (IN2), J6.3, R16.2
unnamed: C13.1, J6.2, J6.4, X2.1
unnamed: C17.1, J5.3, X3.1
unnamed: C12.1, IC3.8 (VDD), X1.1
unnamed: J5.2, R17.1
unnamed: C18.1, IC3.5 (IN1), R17.2
unnamed: IC3.1 (ADDR), R51.2

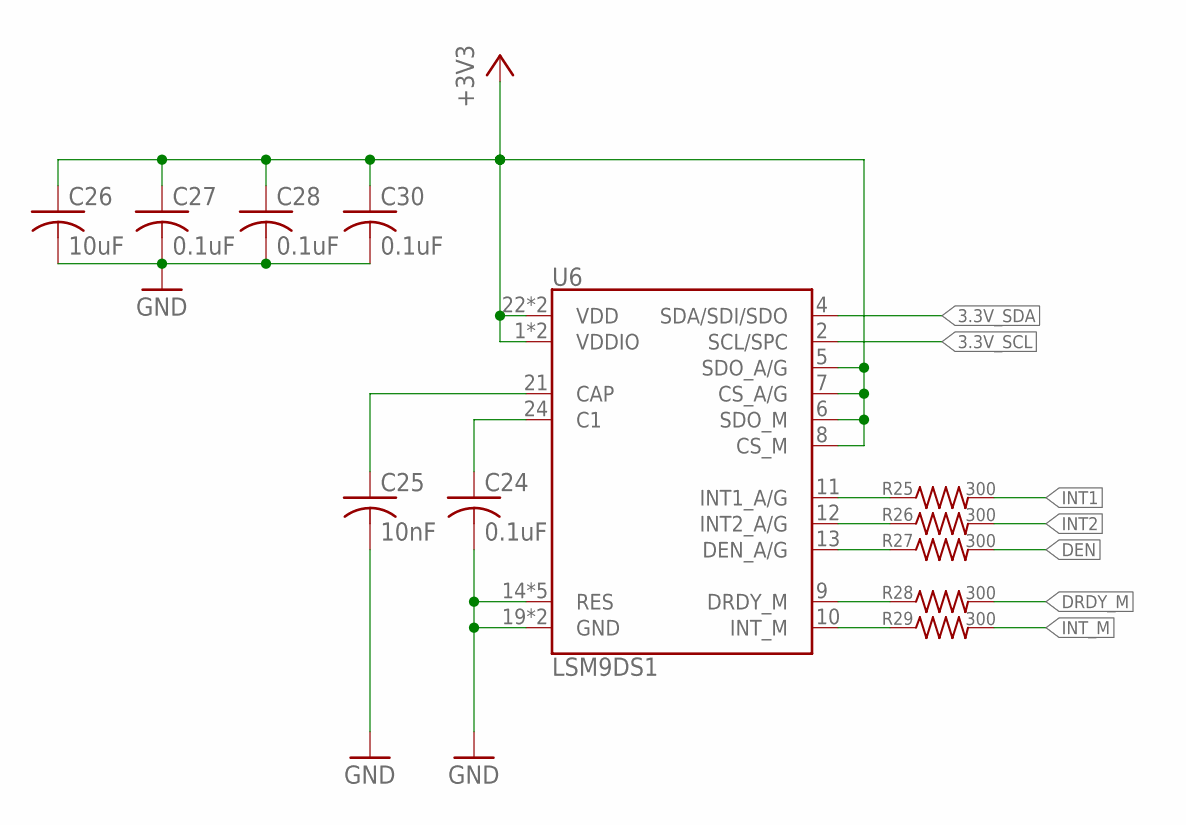
[picture p175: schematic Fathom Drone Pi Shield.sch, sheet 5]

Parts:
C24, C27, C28, C30: 0.1uF; C0402
C25: 10nF; C0402
C26: 10uF; C0805
R25, R26, R27, R28, R29: 300; R0402
U6: LSM9DS1; LGA24-8X4

Connections:
3.3V_SCL: U6.2 (SCL/SPC); also elsewhere on the board
3.3V_SDA: U6.4 (SDA/SDI/SDO); also elsewhere on the board
+3V3: C26.1, C27.1, C28.1, C30.1, U6.1 (VDDIO), U6.3 (VDDIO), U6.5 (SDO_A/G), U6.6 (SDO_M), U6.7 (CS_A/G), U6.8 (CS_M), U6.22 (VDD), U6.23 (VDD); also elsewhere on the board
DEN: R27.2; also elsewhere on the board
DRDY_M: R28.2; also elsewhere on the board
GND: C24.2, C25.2, C26.2, C27.2, C28.2, C30.2, U6.14 (RES), U6.15 (RES), U6.16 (RES), U6.17 (RES), U6.18 (RES), U6.19 (GND), U6.20 (GND); also elsewhere on the board
INT1: R25.2; also elsewhere on the board
INT2: R26.2; also elsewhere on the board
INT_M: R29.2; also elsewhere on the board
unnamed: R25.1, U6.11 (INT1_A/G)
unnamed: R26.1, U6.12 (INT2_A/G)
unnamed: R27.1, U6.13 (DEN_A/G)
unnamed: R28.1, U6.9 (DRDY_M)
unnamed: R29.1, U6.10 (INT_M)
unnamed: C24.1, U6.24 (C1)
unnamed: C25.1, U6.21 (CAP)

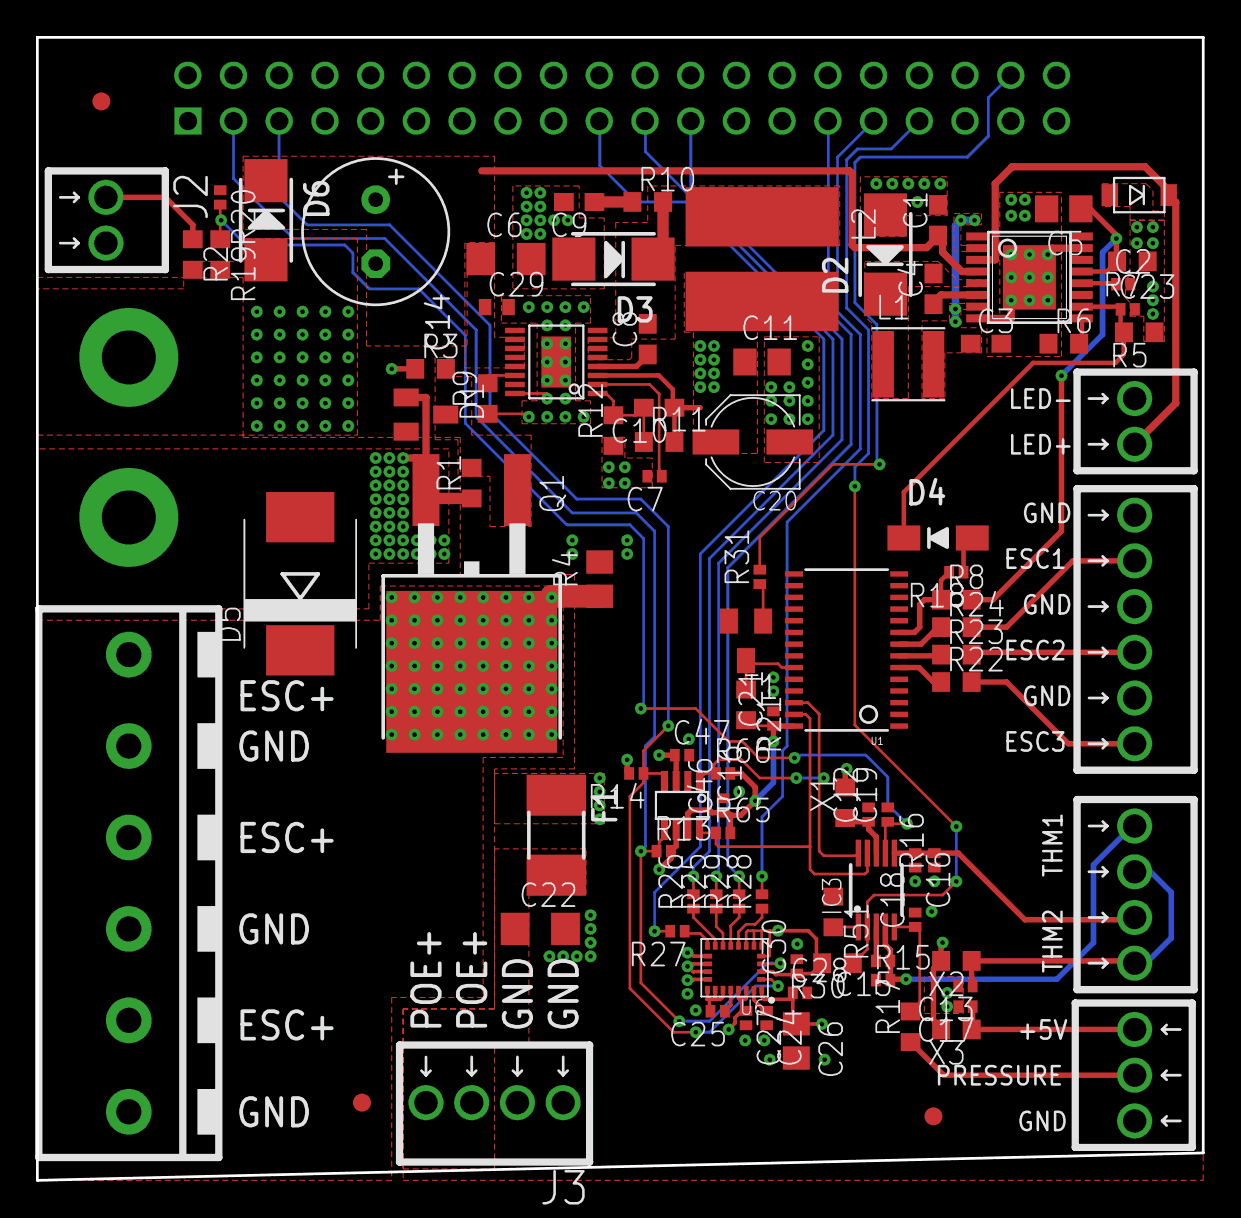
[picture p176: board Fathom Drone Pi Shield.brd from above]

Board: 4 copper layers, 64.8 x 63.5 mm, 100 parts (0 on the bottom side), 62 nets.
